dineshannayya/riscduino_board/KiCad_PCB/Riscduino_Fpga_Rev1.1/Riscduino_Fpga_Rev1.1.Back.jpg

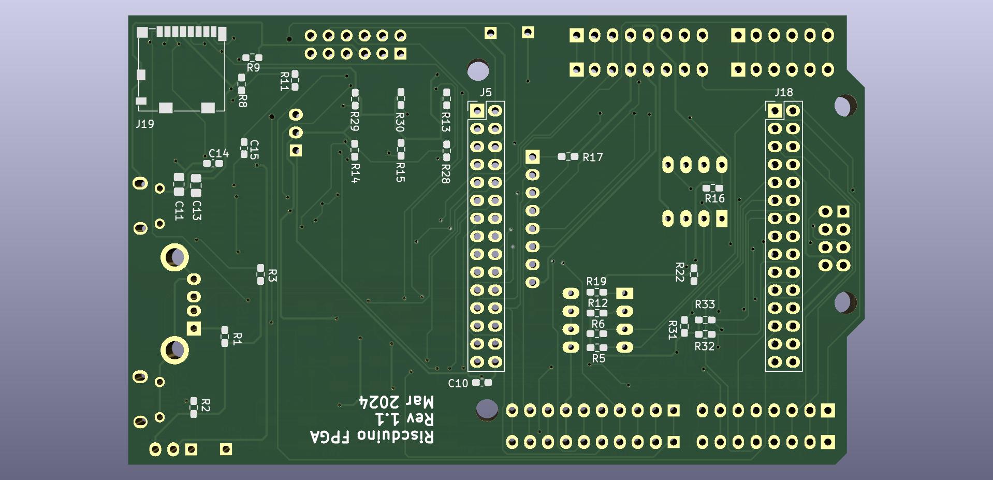
KiCad_PCB/Riscduino_Fpga_Rev1.1/Riscduino_Fpga_Rev1.1.Back.jpg
