dineshannayya/riscduino_board/KiCad_PCB/Riscduino_Fpga_Rev1.1/Riscduino_Fpga_Rev1.1.Front.jpg

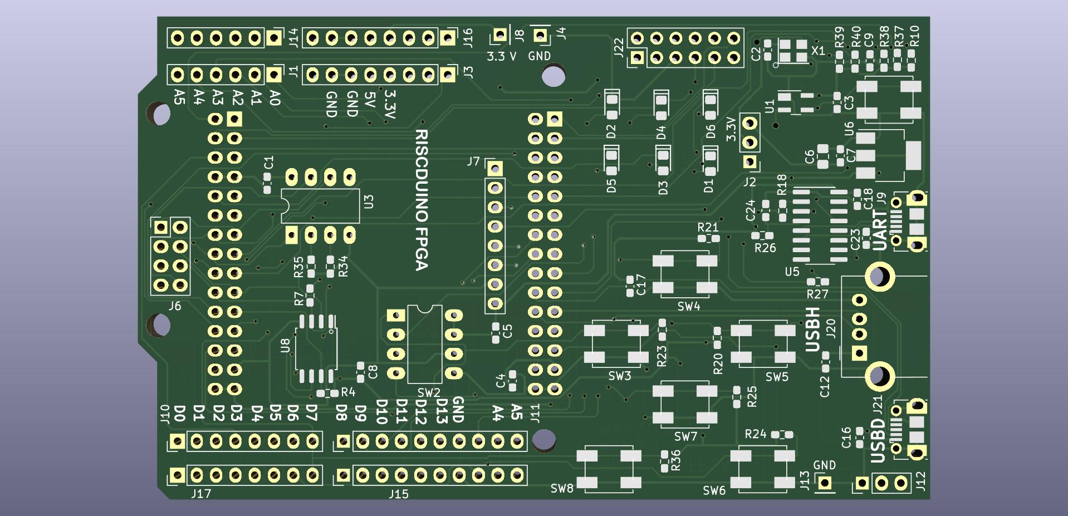
KiCad_PCB/Riscduino_Fpga_Rev1.1/Riscduino_Fpga_Rev1.1.Front.jpg
