dineshannayya/riscduino_board/README.md

# riscduino_board
Riscduino PCB Board documentation
