dineshannayya/riscduino_board/KiCad_PCB/Riscduino_Fpga_Rev1.1/Riscduino_Fpga_Rev1.1_BOM.xlsx

Id | Designator | Footprint | Quantity | Designation
1 | J3,J10,J7 | PinHeader_1x08_P2.54mm_Vertical | 3 | Conn_01x08_Female_Header
2 | J1 | PinHeader_1x06_P2.54mm_Vertical | 1 | Conn_01x06_Female_Header
3 | J11 | PinHeader_1x10_P2.54mm_Vertical | 1 | Conn_01x10_Female_Header
4 | J6 | PinHeader_2x04_P2.54mm_Vertical | 1 | Conn_02x04_Male_Header
5 | J14 | PinHeader_1x06_P2.54mm_Vertical | 1 | Conn_01x06_Male_Header
6 | J16,J17 | PinHeader_1x08_P2.54mm_Vertical | 2 | Conn_01x08_Male_Header
7 | J15 | PinHeader_1x10_P2.54mm_Vertical | 1 | Conn_01x10_Male_Header
8 | J12,J2 | PinHeader_1x03_P2.54mm_Vertical | 2 | Conn_01x03_Male_Header
9 | J22 | PinHeader_2x06_P2.54mm_Vertical | 1 | Conn_02x06_Male_Header
10 | J5,J18 | PinHeader_2x15_P2.54mm_Vertical | 2 | Conn_02x15_Male_Header (Double Hight, Both side exposure)
11 | J9,J21 | USB_Micro-B_Molex-105017-0001 | 2 | USB_B_Micro_Female
12 | J20 | USB_A_Molex_67643_Horizontal | 1 | USB Type A Female
13 | C1,C2,C3,C4,C5,C7,C8,C9,C10,C12,C14,C15,C16,C17,C18,C23,C24 | C_0603_1608Metric_Pad1.08x0.95mm_HandSolder | 17 | 0.1uF
14 | C6 | C_0805_2012Metric_Pad1.18x1.45mm_HandSolder | 1 | 22uF
15 | C13,C11 | C_0805_2012Metric_Pad1.18x1.45mm_HandSolder | 2 | 10uF
16 | R38,R25,R23,R39,R21,R37,R20,R24,R4,R10,R36,R7,R40,R5,R8,R19,R22,R31,R6,R32,R33,R16,R12 | R_0603_1608Metric_Pad0.98x0.95mm_HandSolder | 23 | 10K
17 | R1,R3,R11,R18,R26,R27 | R_0603_1608Metric_Pad0.98x0.95mm_HandSolder | 6 | 0E
18 | R13,R29,R28,R14,R15,R30 | R_0603_1608Metric_Pad0.98x0.95mm_HandSolder | 6 | 470 Ohm
19 | R17 | R_0603_1608Metric_Pad0.98x0.95mm_HandSolder | 1 | 100E
20 | U6 | SOT-223-3_TabPin2 | 1 | LM1117MP-3.3
21 | U8 | SOIC-8_5.23x5.23mm_P1.27mm | 1 | W25Q32JVSS
22 | U5 | SOIC-16_3.9x9.9mm_P1.27mm | 1 | CH340C
23 | D2,D4 | LED_0805_2012Metric_Pad1.15x1.40mm_HandSolder | 2 | GREEN LED
24 | D3,D1,D5,D6 | LED_0805_2012Metric_Pad1.15x1.40mm_HandSolder | 4 | BLUE LED
25 | SW3,SW5,SW8,SW6,SW4,SW1,SW7 | SW_SPST_EVPBF_TS4550TP | 7 | 4Pin Round Button SPST Straight Tactile Switch SMD - TS4550TP
26 | SW2 | DIP-8_W7.62mm_LongPads | 1 | 8 bit DIP Socket (SW_DIP_x04)
27 | U3 | DIP-8_W7.62mm_LongPads | 1 | 8 pin DIP socket (23LC1024-I/P)
28 | U1 | SOT-143_Handsoldering | 1 | APX811-29UG-7
29 | X1 | Crystal_SMD_Abracon_ABM8G-4Pin_3.2x2.5mm | 1 | ASE-18.432MHZ-LC-T
DNI - Donot Mount
1 | R34,R35 | R_0603_1608Metric_Pad0.98x0.95mm_HandSolder | 2 | DNI
2 | R9 | R_0603_1608Metric_Pad0.98x0.95mm_HandSolder | 1 | DNI
3 | R2 | R_0603_1608Metric_Pad0.98x0.95mm_HandSolder | 1 | DNI-0E
4 | J19 | microSD_HC_Molex_104031-0811 | 1 | Micro_SD_Card
24 | H1 | Arduino_UNO_R3_WithMountingHoles | 1 | MountingHole
1 | J4,J13,J8 | PinHeader_1x01_P2.54mm_Vertical | 3 | Conn_01x01
