dineshannayya/riscduino_board/KiCad_PCB/Riscduino_Uno_Rev1.3/Riscduino_Uno_Rev1.3_bom.xlsx

Id | Designator | Footprint | Quantity | Designation
1 | J4,J12,J7,J5 | PinHeader_1x01_P2.54mm_Vertical (Male Berg Connector) | 4 | Conn_01x01
2 | JP2,JP1 | PinHeader_1x02_P2.54mm_Vertical (Male Berg Connector) | 2 | Jumper_2
3 | J11 | PinHeader_1x03_P2.54mm_Vertical (Male Berg Connector) | 1 | Conn_01x03_Pin
4 | J2 | PinHeader_2x03_P2.54mm_Vertical (Male Berg Connector) | 1 | ISP
5 | J6 | PinHeader_2x04_P2.54mm_Vertical(Male Berg Connector) | 1 | Conn_02x04_Odd_Even
6 | J10 | PinHeader_1x10_P2.54mm_Vertical(Female Berg Connector) | 1 | Conn_01x10_Pin
7 | J3,J9 | PinHeader_1x08_P2.54mm_Vertical(Female Berg Connector) | 2 | Conn_01x08_Pin
8 | J1 | PinHeader_1x06_P2.54mm_Vertical(Female Berg Connector) | 1 | Conn_01x06_Pin
9 | J8 | USB_Micro-B_Molex-105017-0001 | 1 | USB_B_Micro
10 | C2,C12,C27,C28,C18,C21,C22,C23,C26 | C_0603_1608Metric_Pad1.08x0.95mm_HandSolder | 9 | 0.1uF (100nf)
11 | C6,C14,C3,C7,C9,C10,C11,C5,C8,C4,C1,C24,C25 | C_0603_1608Metric_Pad1.08x0.95mm_HandSolder | 13 | 0.1uF (100nf)
12 | C13,C19 | C_0805_2012Metric_Pad1.18x1.45mm_HandSolder | 2 | 22uF
13 | C16,C17,C15,C20 | C_0805_2012Metric_Pad1.18x1.45mm_HandSolder | 4 | 10uF
14 | R9,R6,R7,R5,R12,R20,R25,R26 | R_0603_1608Metric_Pad0.98x0.95mm_HandSolder | 8 | 0E
15 | R18,R27,R28,R17,R16,R29,R15 | R_0603_1608Metric_Pad0.98x0.95mm_HandSolder | 7 | 470 Ohm
16 | R3,R2,R1,R4,R10,R13,R21,R32,R24,R22,R23,R30,R31,R19 | R_0603_1608Metric_Pad0.98x0.95mm_HandSolder | 14 | 10K
17 | D2,D3,D1,D4,D5 | LED_0805_2012Metric_Pad1.15x1.40mm_HandSolder | 5 | GREEN LED
18 | D6 | LED_0805_2012Metric_Pad1.15x1.40mm_HandSolder | 1 | BLUE LED
19 | U1 | SOT-143_Handsoldering | 1 | APX811-29UG-7
20 | U5 | SOT-223-3_TabPin2 | 1 | LM1117MP-3.3
21 | U8,U2 | SOIC-8_5.23x5.23mm_P1.27mm | 2 | W25Q32JVSS
22 | U7 | SOT-223-3_TabPin2 | 1 | LM1117S-ADJ
23 | U6 | SOIC-16_3.9x9.9mm_P1.27mm | 1 | CH340C
24 | U3 | DIP-8_W7.62mm_LongPads | 1 | 23LC1024-I/P
25 | U4 | RISCDUINO_QFN-64-1EP_9x9mm_P0.5mm_EP7.65x7.65mm_Ver1.1 | 1 | Riscduino
26 | SW1 | SW_SPST_EVPBF_TS4550TP | 1 | 4Pin Round Button SPST Straight Tactile Switch SMD - TS4550TP
27 | X1 | Crystal_SMD_Abracon_ABM8G-4Pin_3.2x2.5mm | 1 | ASE-10.000MHZ-LC-T
28 | RV1 | Potentiometer_Bourns_3296W_Vertical | 1 | 500 Ohm Trim Pot
Don't mount below componets
1 | H1 | Arduino_UNO_R3_WithMountingHoles | 1 | MountingHole
2 | R8 | R_0603_1608Metric_Pad0.98x0.95mm_HandSolder | 1 | DNI
3 | R11 | C_0603_1608Metric_Pad1.08x0.95mm_HandSolder | 1 | 0E-DNI
4 | R14 | R_0603_1608Metric_Pad0.98x0.95mm_HandSolder | 1 | DNI
