dineshannayya/riscduino_board/KiCad_PCB/Riscduino_Tester_Rev1.0/Riscduino_Tester_BOM_1_0.xlsx

Id | Designator | Footprint | Quantity | Designation
1 | JP2,JP1 | PinHeader_1x02_P2.54mm_Vertical | 2 | Jumper_2(Male berg Connector)
2 | J6 | PinHeader_2x04_P2.54mm_Vertical | 1 | Conn_02x04_Odd_Even(Male berg Connector)
3 | J11 | PinHeader_1x03_P2.54mm_Vertical | 1 | Conn_01x03_Pin(Male berg Connector)
4 | J2 | PinHeader_2x03_P2.54mm_Vertical | 1 | ISP(Male berg Connector)
5 | J1 | PinHeader_1x06_P2.54mm_Vertical | 1 | Conn_01x06_Pin(Female berg Connector)
6 | J10 | PinHeader_1x10_P2.54mm_Vertical | 1 | Conn_01x10_Pin(Female berg Connector)
7 | J13,J14 | PinHeader_2x16_P2.54mm_Vertical_Swap | 2 | Conn_02x16_Odd_Even (Female berg Connector)
8 | J3,J9 | PinHeader_1x08_P2.54mm_Vertical | 2 | Conn_01x08_Pin(Female berg Connector)
9 | C3,C8,C16,C9,C11,C2,C6,C15,C12,C7,C1,C10 | C_0603_1608Metric_Pad1.08x0.95mm_HandSolder | 12 | 0.1uf
10 | C5,C13,C26,C27,C17,C18,C23,C24 | C_0603_1608Metric_Pad1.08x0.95mm_HandSolder | 8 | 0.1uF
11 | C4,C19,C20,C22 | C_0805_2012Metric_Pad1.18x1.45mm_HandSolder | 4 | 10uF
12 | C14,C21 | C_0805_2012Metric_Pad1.18x1.45mm_HandSolder | 2 | 22uF
13 | C25 | C_0603_1608Metric_Pad1.08x0.95mm_HandSolder | 1 | 0.1uF
14 | R7,R1,R10,R12,R8,R17,R22,R28 | R_0603_1608Metric_Pad0.98x0.95mm_HandSolder | 8 | 0E
15 | R2,R6,R4,R5,R3,R11,R23,R29,R24,R25,R26,R30,R31,R16 | R_0603_1608Metric_Pad0.98x0.95mm_HandSolder | 14 | 10K
16 | R18,R15,R19,R27,R20,R21,R13 | R_0603_1608Metric_Pad0.98x0.95mm_HandSolder | 7 | 470 Ohm
17 | U3 | SOT-223-3_TabPin2 | 1 | LM1117MP-3.3
18 | U6,U1 | SOIC-8_5.23x5.23mm_P1.27mm | 2 | W25Q32JVSS
19 | U4 | SOT-223-3_TabPin2 | 1 | LM1117S-ADJ
20 | U5 | SOIC-16_3.9x9.9mm_P1.27mm | 1 | CH340C
21 | U2 | DIP-8_W7.62mm_LongPads | 1 | 23LC1024-I/P
22 | D2,D5,D6,D3,D4 | LED_0805_2012Metric_Pad1.15x1.40mm_HandSolder | 5 | GREEN LED
23 | D1 | LED_0805_2012Metric_Pad1.15x1.40mm_HandSolder | 1 | BLUE LED
24 | J8 | USB_Micro-B_Molex-105017-0001 | 1 | USB_B_Micro
25 | SW1 | SW_SPST_EVPBF_TS4550TP | 1 | 4Pin Round Button SPST Straight Tactile Switch SMD - TS4550TP
26 | X1 | Crystal_SMD_Abracon_ABM8G-4Pin_3.2x2.5mm | 1 | ASE-10.000MHZ-LC-T
27 | RV1 | Potentiometer_Bourns_3296W_Vertical | 1 | 500 Ohm Trim Pot
1 | J4,J12,J7,J5 | PinHeader_1x01_P2.54mm_Vertical | 4 | DNI (Don't Mount)
2 | R9 | R_0603_1608Metric_Pad0.98x0.95mm_HandSolder | 1 | DNI(Don't Mount)
3 | H1 | Riscduino_Tester_WithMountingHoles | 1 | DNI(Don't Mount)
4 | R14 | R_0603_1608Metric_Pad0.98x0.95mm_HandSolder | 1 | DNI(Don't Mount)
