dineshannayya/riscduino_board/KiCad_PCB/Riscduino_Debug_Rev1.4/Riscduino_Debug_Rev1.4.xlsx

 | Id | Designator | Footprint | Quantity | Designation | Total Pins | Total Q | Total 5 Board
Female Berg Connector | 1 | J3,J10,J7 | PinHeader_1x08_P2.54mm_Vertical | 3 | Female Berg Conn_01x08 | 8 | 24
 | 2 | J1 | PinHeader_1x06_P2.54mm_Vertical | 1 | Femal Berg Conn_01x06 | 6 | 6
 | 3 | J11 | PinHeader_1x10_P2.54mm_Vertical | 1 | Female Berg Conn_01x10 | 10 | 10
 |  |  |  |  |  | 24 | 40 | 200
Male Berg Connector | 4 | JP2,JP1 | PinHeader_1x02_P2.54mm_Vertical | 2 | Male Berg Conn_01x02 | 2 | 4
 | 5 | J6 | PinHeader_2x04_P2.54mm_Vertical | 1 | Male Berg Conn_02x04 | 8 | 8
 | 6 | J12 | PinHeader_1x03_P2.54mm_Vertical | 1 | Male Berg Conn_01x03 | 3 | 3
 | 7 | J2 | PinHeader_2x03_P2.54mm_Vertical | 1 | Male Berg Conn_02x04 | 8 | 8
 |  |  |  |  |  | 21 | 23 | 115
IC's | 8 | U6 | SOT-223-3_TabPin2 | 1 | LM1117MP-3.3 | 1 | 1 | 5
 | 9 | U8,U2 | SOIC-8_5.23x5.23mm_P1.27mm | 2 | W25Q32JVSS | 2 | 2 | 10
 | 10 | U7 | SOT-223-3_TabPin2 | 1 | LM1117S-ADJ | 1 | 1 | 5
 | 11 | X1 | Crystal_SMD_Abracon_ABM8G-4Pin_3.2x2.5mm | 1 | ASE-10.000MHZ-LC-T | 1 | 1 | 5
 | 12 | U5 | SOIC-16_3.9x9.9mm_P1.27mm | 1 | CH340C | 1 | 1 | 5
 | 13 | U3 | DIP-8_W7.62mm_LongPads | 1 | 23LC1024-I/P (8 pin socket)
 | 14 | U1 | SOT-143_Handsoldering | 1 | APX811-29UG-7 | 1 | 1 | 5
 | 15 | J9 | USB_Micro-B_Molex-105017-0001 | 1 | USB_B_Micro | 1 | 1 | 5
Capacitor | 16 | C2,C8,C3,C5,C7,C4,C1,C21,C20,C15,C24,C16,C22,C12,C14,C19,C18,C23 | C_0603_1608Metric_Pad1.08x0.95mm | 18 | 0.1uF | 18 | 18 | 90
 | 17 | C6,C17 | C_0805_2012Metric_Pad1.18x1.45mm | 2 | 22uF | 2 | 2 | 10
 | 18 | C10,C13,C9,C11 | C_0805_2012Metric_Pad1.18x1.45mm | 4 | 10uF | 4 | 4 | 20
LED | 19 | D2,D3,D1,D4,D5 | LED_0805_2012Metric_Pad1.15x1.40mm | 5 | GREEN LED | 5 | 5 | 25
 | 20 | D6 | LED_0805_2012Metric_Pad1.15x1.40mm | 1 | BLUE LED | 1 | 1 | 5
Resister | 21 | R5,R11,R18,R19,R20,R21,R26,R27 | R_0603_1608Metric_Pad0.98x0.95mm | 8 | 0E | 8 | 8 | 40
 | 22 | R13,R29,R28,R14,R15,R30,R12 | R_0603_1608Metric_Pad0.98x0.95mm | 7 | 470E | 7 | 7 | 35
 | 23 | R17 | R_0603_1608Metric_Pad0.98x0.95mm | 1 | 100E | 1 | 1 | 5
 | 24 | R1,R2,R3,R4,R7,R8,R22,R31,R23,R24,R25,R32,R33,R16 | R_0603_1608Metric_Pad0.98x0.95mm | 14 | 10K | 14 | 14 | 70
 | 25 | H2 | MicroMod-Standoff | 1 | MICROMOD-Standoff | 1 | 1 | 5
 | 26 | U4 | M.2-CONNECTOR-E | 1 | MICROMOD-Connector | 1 | 1 | 5
 | 27 | SW1 | SW_SPST_EVPBF_TS4550TP | 1 | 4Pin Round Button SPST Straight Tactile Switch SMD - TS4550TP | 1 | 1 | 5
 | 28 | RV1 | Potentiometer_Bourns_3296W_Vertical | 1 | 500 Ohm Trim Pot | 1 | 1 | 5
 | Following Componets are need not be mounted
 | 30 | R6,R34,R35 | R_0603_1608Metric_Pad0.98x0.95mm | 3 | DNI
 | 31 | R10 | C_0603_1608Metric_Pad1.08x0.95mm | 1 | 0E-DNI
 | 32 | R9 | R_0603_1608Metric_Pad0.98x0.95mm | 1 | DNI
 | 33 | J4,J13,J8,J5 | PinHeader_1x01_P2.54mm_Vertical | 4 | DNI
 | 34 | H1 | Arduino_UNO_R3_WithMountingHoles | 1 | MountingHole | 1 | 1 | 5
