dineshannayya/riscduino_board/KiCad_PCB/Riscduino_Componets_Tracking.xlsx

 | Riscduino Components Tracking
Id | Footprint | Designation | Quantity | Vendor |  | Code/Sku | Link
1 | PinHeader_1x01_P2.54mm_Vertical(Male) | Conn_01x01 | 40x 10 | evelta | ₹4.03 | 083-BS-M-1X40-254-S | berg-strip-i-type-male (https://evelta.com/berg-strip-i-type-male-1x40-2-54-mm-0-1-inch-pitch/)
2 | PinHeader_1x02_P2.54mm_Vertical(Male) | Jumper_2
3 | PinHeader_1x01_P2.54mm_Vertical(Male) | TestPoint
7 | PinHeader_2x04_P2.54mm_Vertical(Male) | Conn_02x04_Odd_Even
8 | PinHeader_2x03_P2.54mm_Vertical(Male) | ISP
4 | PinHeader_1x08_P2.54mm_Vertical (Female) | Conn_01x08_Pin | 40 x 10 | electronicscomp | Rs.19.00 | EC-6391/85366990 | 2x40 1.27mm Pitch Pin Female Double Row Header Berg Strip (https://www.electronicscomp.com/2x40-1.27mm-pitch-pin-female-double-row-header-berg-strip?search=EC-6391)
5 | PinHeader_1x06_P2.54mm_Vertical (Female) | Conn_01x06_Pin (Female)
6 | PinHeader_1x10_P2.54mm_Vertical (Female) | Conn_01x10_Pin
9 | USB_Micro-B_Molex-105017-0001 | USB_B_Micro | 13 | evelta | ₹7.78 | 345-U254-051T-4BH83-S1S | female-micro-b-usb-connector (https://evelta.com/female-micro-b-usb-connector-smd/)
10 | R_0603_1608Metric_Pad0.98x0.95mm_HandSolder | 0E | 200
11 | R_0603_1608Metric_Pad0.98x0.95mm_HandSolder | 10K | 200 | evelta | ₹0.32 | 039-RC0603FR-0710KL | 10k-1-100mw-0603 (https://evelta.com/10k-1-100mw-0603-chip-resistor/)
12 | R_0603_1608Metric_Pad0.98x0.95mm_HandSolder | 470 Ohm | 200 | robu.in | ₹45.00 | 573876 | 470-ohm-1-4w-0603 (https://robu.in/product/470-ohm-1-4w-0603-surface-mount-chip-resistor-pack-of-100/)
13 | C_0603_1608Metric_Pad1.08x0.95mm_HandSolder | 0.1uF | 200 | evelta | ₹0.76 | 153-W25Q32JVSSIQ | 100-nf-50v-0603 (https://evelta.com/100-nf-50v-0603-smd-multi-layer-ceramic-capacitor-0603b104k500ct-walsin/)
14 | C_0805_2012Metric_Pad1.18x1.45mm_HandSolder | 22uF | 100 | evelta | ₹4.00 | 110-CL21A226MQQNNNE | 22-uf-6-3v-0805
15 | C_0805_2012Metric_Pad1.18x1.45mm_HandSolder | 10uF | 100 | evelta | ₹7.14 | 110-CL21A106KBYQNNE | 10uf-50v (https://evelta.com/10uf-50v-10-x5r-0805-chip-capacitor/)
16 | LED_0805_2012Metric_Pad1.15x1.40mm_HandSolder | RED LED | 100 | evelta | ₹1.84 | 083-RD-LED-0805 | red-led (https://evelta.com/red-led-smd-0805-package/)
17 | LED_0805_2012Metric_Pad1.15x1.40mm_HandSolder | GREEN LED | 100 | evelta | ₹4.03 | 083-GN-LED-0805 | green-led (https://evelta.com/green-led-smd-0805-package/)
18 | LED_0805_2012Metric_Pad1.15x1.40mm_HandSolder | BLUE LED | 100 | evelta | ₹1.69 | 083-BE-LED-0805 | blue-led (https://evelta.com/blue-led-smd-0805-package/)
19 | SOIC-8_5.23x5.23mm_P1.27mm | W25Q32JVSS (SPI FLASH) | 50 | evelta | ₹28.80 | 153-W25Q32JVSSIQ | w25q32jvssiq (https://evelta.com/w25q32jvssiq-winbond/)
20 | SOT-223-3_TabPin2 | LM1117S-ADJ (Adjustable Regulator) | 25 | evelta | ₹13.44 | 052-LM1117S-ADJ | lm1117s-adj-htc-adjustable (https://evelta.com/lm1117s-adj-htc-adjustable-1a-ldo-voltage-regulator/)
reg |  |  | 25 | inkocean.in | ₹21.00 | CJ0109170855 | LM1117IMPX-ADJ N03A (https://inkocean.in/products/screen-lm1117impx-adj-n03a-power-regulator-chip-package-sot223)
21 | SOIC-16_3.9x9.9mm_P1.27mm | CH340C (USB2UART IC) | 10 | electronicscomp | Rs.64.00 | EC-17358/85423100 | ch340c-smd-sop-16-package (https://www.electronicscomp.com/ch340c-smd-sop-16-package-usb-to-serial-ttl-converter-ic?search=EC-17358) | S
22 | SOIC-8-1EP_3.9x4.9mm_P1.27mm_EP2.29x3mm | MAX1232ESA+T ( Power Supervisory) | 25 | inkocean.in | ₹30.00 | CJ0109155354 | monitor-ic-max1232esa-sop8 (https://inkocean.in/products/monitor-ic-max1232esa-sop8-supervisory-circuits-max1232-chip-package)
23 | SOT-223-3_TabPin2 | LM1117MP-3.3 (3.3 V Regulator) | 25 | evelta | ₹11.70 | 052-LM1117GS-3.3 | lm1117s-3-3-htc-3-3v (https://evelta.com/lm1117s-3-3-htc-3-3v-1a-ldo-voltage-regulator/)
 |  |  | 25 | inkocean.in | ₹21.00 | CJ0109170855 | ns-lm1117-3-3-lm1117impx-3-3v (https://inkocean.in/products/ns-lm1117-3-3-lm1117impx-3-3-lm1117mpx-3-3-n05a-n05b)
24 | DIP-8_W7.62mm_LongPads | 23LC1024-I/P (SPI SRAM) | 10 | tanotis.com | ₹355.50 | 9781102352 | MICROCHIP SRAM, 1 MB, 128K x 8bit (https://www.tanotis.com/products/microchip-23lc1024-i-p-sram-1-mb-128k-x-8bit-2-5v-to-5-5v-dip-8-pins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) | S
25 | RISCDUINO_QFN-64-1EP_9x9mm_P0.5mm_EP7.65x7.65mm_NEW | Riscduino | 40
26 | SW_SPST_EVPBF_TS4550TP | 4Pin Round Button SPST Straight Tactile Switch SMD - TS4550TP | 100 | evelta | ₹1.68 | 336-TS4550TP | 4pin-round-button-spst (https://evelta.com/12v-50ma-4-5x4-5x5-0mm-4pin-round-button-spst-straight-tactile-switch-smd/)
27 | Crystal_SMD_Abracon_ABM8G-4Pin_3.2x2.5mm (SMD_3225) | ASE-10.000MHZ-LC-T | 15 | iodparts.in | ₹117.85 |  | ase-10-000mhz-lc-t (https://www.iodparts.in/part/ase-10-000mhz-lc-t) | S
28 | Potentiometer_Bourns_3296W_Vertical | 500 Ohm Trim Pot | 15 | evelta | ₹6.25 | 184-3296W-1-501LF | 500r-0-5w-10-multiturn-trimpot (https://evelta.com/500r-0-5w-10-multiturn-trimpot-trimming-potentiometer-through-hole/) | S
29 | MicroMod DIY Carrier Kit |  | 5 | tanotis.com | ₹665 | 6615389077589/KIT-16549 | MicroMod DIY Carrier Kit (https://www.tanotis.com/products/sparkfun-micromod-diy-carrier-kit-5-pack?variant=39501712425045)
Additional Componets
30 | R_0603_1608Metric_Pad0.98x0.95mm_HandSolder | 220 ohm | 200 | robu.in | ₹ 49.00 | 573740 | 220-ohm-chip-resistor-1-4w-0603 (https://robu.in/product/220-ohm-chip-resistor-1-4w-0603-surface-mount-pack-of-100/)
31 | R_0603_1608Metric_Pad0.98x0.95mm_HandSolder | 330 ohm | 200 | robu.in | ₹ 49.00 | 573821 | 330-ohm-1-4w-0603 (https://robu.in/product/330-ohm-1-4w-0603-surface-mount-chip-resistor-pack-of-100/)
32 | 1uF 16V 10% X5R 0603 MLCC Multilayer Ceramic Capacitor |  | 100 | evelta | ₹0.80 | 110-CL10A105KO8NNNC | 1uf-16v (https://evelta.com/1uf-16v-10-x5r-0603-capacitor/)
33 | 4.7uF 16V 10% X5R 0603 MLCC Multilayer Ceramic Capacitor |  | 100 | evelta | ₹1.60 | 110-CL10A475KO8NNNC | 4-7uf-16v (https://evelta.com/4-7uf-16v-10-x5r-0603-capacitor/)
34 | LM1117S-1.8V - 1.8V 1A Fixed Output LDO Linear Voltage Regulator 3-Pin SOT-223 |  | 50 | evelta | ₹13.44 | 052-LM1117S-1.8V | lm1117s-1-8v (https://evelta.com/lm1117s-1-8v-htc-1-8v-1a-ldo-voltage-regulator/)
35 | 1x20 2.54mm Pitch (Right Angle) Female Header Berg Strip |  | 4 | electronicscomp | Rs.19.00 | EC-6408/85366990 | 1x20-2.54mm-pitch-right-angle-female-header-berg-strip (https://www.electronicscomp.com/1x20-2.54mm-pitch-right-angle-female-header-berg-strip?search=EC-6408)
36 | 1x40 2.54mm Pitch Female Berg Strip Header (Right Angle) |  | 4 | electronicscomp | Rs.23.00 | EC-6405/85366990 | 1x40-2.54mm-pitch-female-berg-strip-header-right-angle (https://www.electronicscomp.com/1x40-2.54mm-pitch-female-berg-strip-header-right-angle?search=EC-6405)
37 | 1x20 2.54mm Pitch (Right Angle) Male Header Berg Strip |  | 6 | electronicscomp | Rs.15.00 | EC-6409/85366990 | 1x20-2.54mm-pitch-right-angle-male-header-berg-strip (https://www.electronicscomp.com/1x20-2.54mm-pitch-right-angle-male-header-berg-strip?search=EC-6409)
38 | 2x40 1.27mm Pitch Pin Female Double Row Header Berg Strip |  | 2 | electronicscomp | Rs.59.00 | EC-6391/85366990 | 2x40-1.27mm-pitch-pin-female-double-row-header-berg-strip (https://www.electronicscomp.com/2x40-1.27mm-pitch-pin-female-double-row-header-berg-strip?search=EC-6391)
39 | 1x40 Pin 2.54mm Pitch Male Berg Strip - Break Away Header - Straight |  | 10 | electronicscomp | Rs.9.00 | EC-0183/85369090 | 1x40 Pin 2.54mm Pitch Male Berg Strip (https://www.electronicscomp.com/40-pin-male-berg-strip?search=EC-0183)
40 | 24LC256-I/P 24C256 |  | 5 | robu.in | ₹ 55.00 | 1089239 | 24LC256-I/P 24C256 256K (https://robu.in/product/24lc256-i-p-24c256-256k-bit-serial-i2c-bus-eeprom-ic-dip-8-package/)
41 | 24LC512-I/SN |  | 20 | iodparts.in | ₹133.97 |  | 24lc512-i-sn (https://www.iodparts.in/part/24lc512-i-sn)
42 | Integrated Silicon Solution (ISSI) IS62WV2568BLL-55HLI Sram 2 Mbit 256K x 8bit 2.5V to 3.6V |  | 4 | tanotis.com | ₹334.65 | 1359619915861 | IS62WV2568BLL-55HLI (https://www.tanotis.com/products/integrated-silicon-solution-issi-is62wv2568bll-55hli-sram-2-mbit-256k-x-8bit-2-5v-to-3-6v-stsop-32-pins-55-ns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)
43 | LM1117IMPX-1.8 SOT223 package |  | 25 | inkocean.in | ₹26.00 | CJ0109162514 | lm1117impx-1-8-sot223 (https://inkocean.in/products/lm1117impx-1-8-sot223-package-n12a-screen-full-range-jieyou)
44 | CP2102 CP2102-GMR QFN28 USB serial converter chip |  | 5 | inkocean.in | ₹139.00 | CJ0109172849 | cp2102-cp2102-gmr-qfn28 (https://inkocean.in/products/cp2102-cp2102-gmr-qfn28-usb-serial-converter-chip)
45 | DS1232LPS DS1232L SOP-8 rmal monitoring chip |  | 100 | inkocean.in | ₹16.00 | CJ0109164039 | ds1232lps-ds1232l (https://inkocean.in/products/ds1232lps-ds1232l-sop-8-rmal-monitoring-chip)
