dineshannayya/riscduino_board/KiCad_PCB/Riscduino_Tester_Rev1.0/Riscduino_Tester_back_View.png

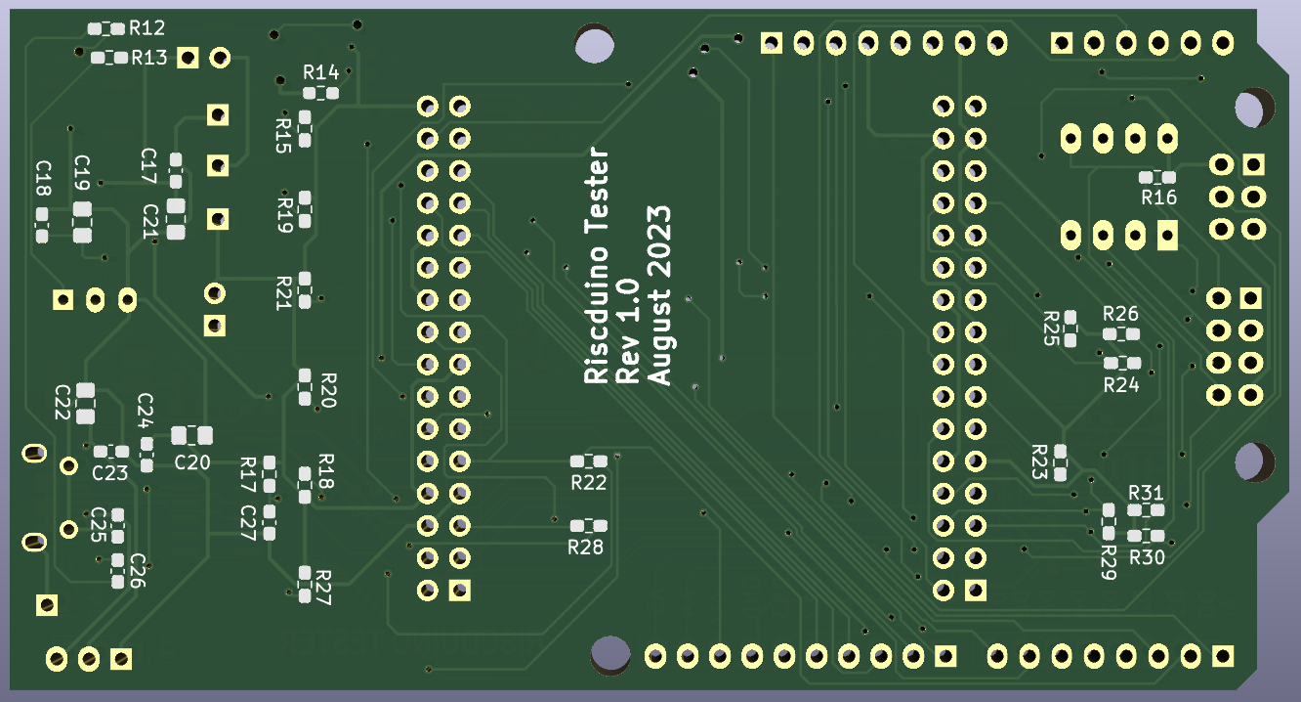
KiCad_PCB/Riscduino_Tester_Rev1.0/Riscduino_Tester_back_View.png
