dineshannayya/riscduino_board/KiCad_PCB/Riscduino_Debug_Rev1.4/BoardStatus.xlsx

 |  | IO | Core |  |  |  |  |  |  | Replace |  |  |  | Resolder | Female Connector
Board | No | (V) | (V) | USB | CLK | LED | Download | Cache | Non-Cache | CLK | USB2UART | Riscduino | LED | Riscduino |  | 100nf | Remark
Riscduino Rev 1.3 | B1 | 3.3 | 1.58 | OK | OK | OK | OK | NOK | OK |  |  |  |  |  |  |  | Good for Non cache mode TCM Test passing, Still software hangs with cache enabled
Riscduino Rev 1.3 | B2 | 3.3 | 1.59 | OK | NOK | OK |  |  |  | YES |  |  |  | YES |  |  | Need Clock Replacement + Chip reSoldering
Riscduino Rev 1.3 | B3 | 3.3 | 1.58 | OK | OK | OK | NOK |  |  |  |  | YES |  |  |  |  | Bootloader programing itself fails, need to replace chip
Riscduino Rev 1.3 | B4 | 3.3 | 1.59 | OK | OK | OK | OK | NOK | OK |  |  |  |  |  |  | YES | Good for Non cache mode
Riscduino Rev 1.3 | B5 | 3.3 | 1.59 | NOK | OK | OK |  |  |  |  | YES |  |  |  | YES |  | Try with USB2UART replacement
Riscduino Rev 1.3 | B6 | 3.3 | 1.59 | OK | OK | OK |  |  |  |  |  |  |  | YES | YES |  | Need Chip resoldering
Riscduino Rev 1.3 | B7 | 3.3 | 1.59 | NOK | OK |  |  |  |  |  | YES |  | YES |  |  |  | Replace USB2UART and Need to Solder LED
Riscduino Rev 1.3 | B8 | 3.3 | 1.59 | OK | OK | OK | OK | OK | OK |  |  |  |  |  | YES |  | Good for Cache Mode
Riscduino Rev 1.3 | B9 | 3.3 | 1.59 | OK | OK | OK |  |  |  |  |  |  |  | YES | YES |  | Need Chip resoldering
Riscduino Rev 1.3 | B10 | 3.3 | 1.59 | OK | OK | OK | OK | NOK | OK |  |  |  |  |  |  |  | Good for Non Cache Mode
VSDSquadron V2 | B1 | 3.3 | 1.57 | OK | OK | OK | OK | NOK | NOK |  |  | YES |  |  |  |  | Software is not executing Fyi: Previosly this board fails with SPI signature check, after replacing it , Downloading is working
VSDSquadron V2 | B2 | 3.3 | 1.58 | OK | OK | OK | OK | NOK | OK |  |  |  |  |  |  |  | Working in non cache Mode
