dineshannayya/riscduino_board/KiCad_PCB/Riscduino_Uno_Rev1.3/Riscduino_Uno_Rev1.3_Schematic.pdf

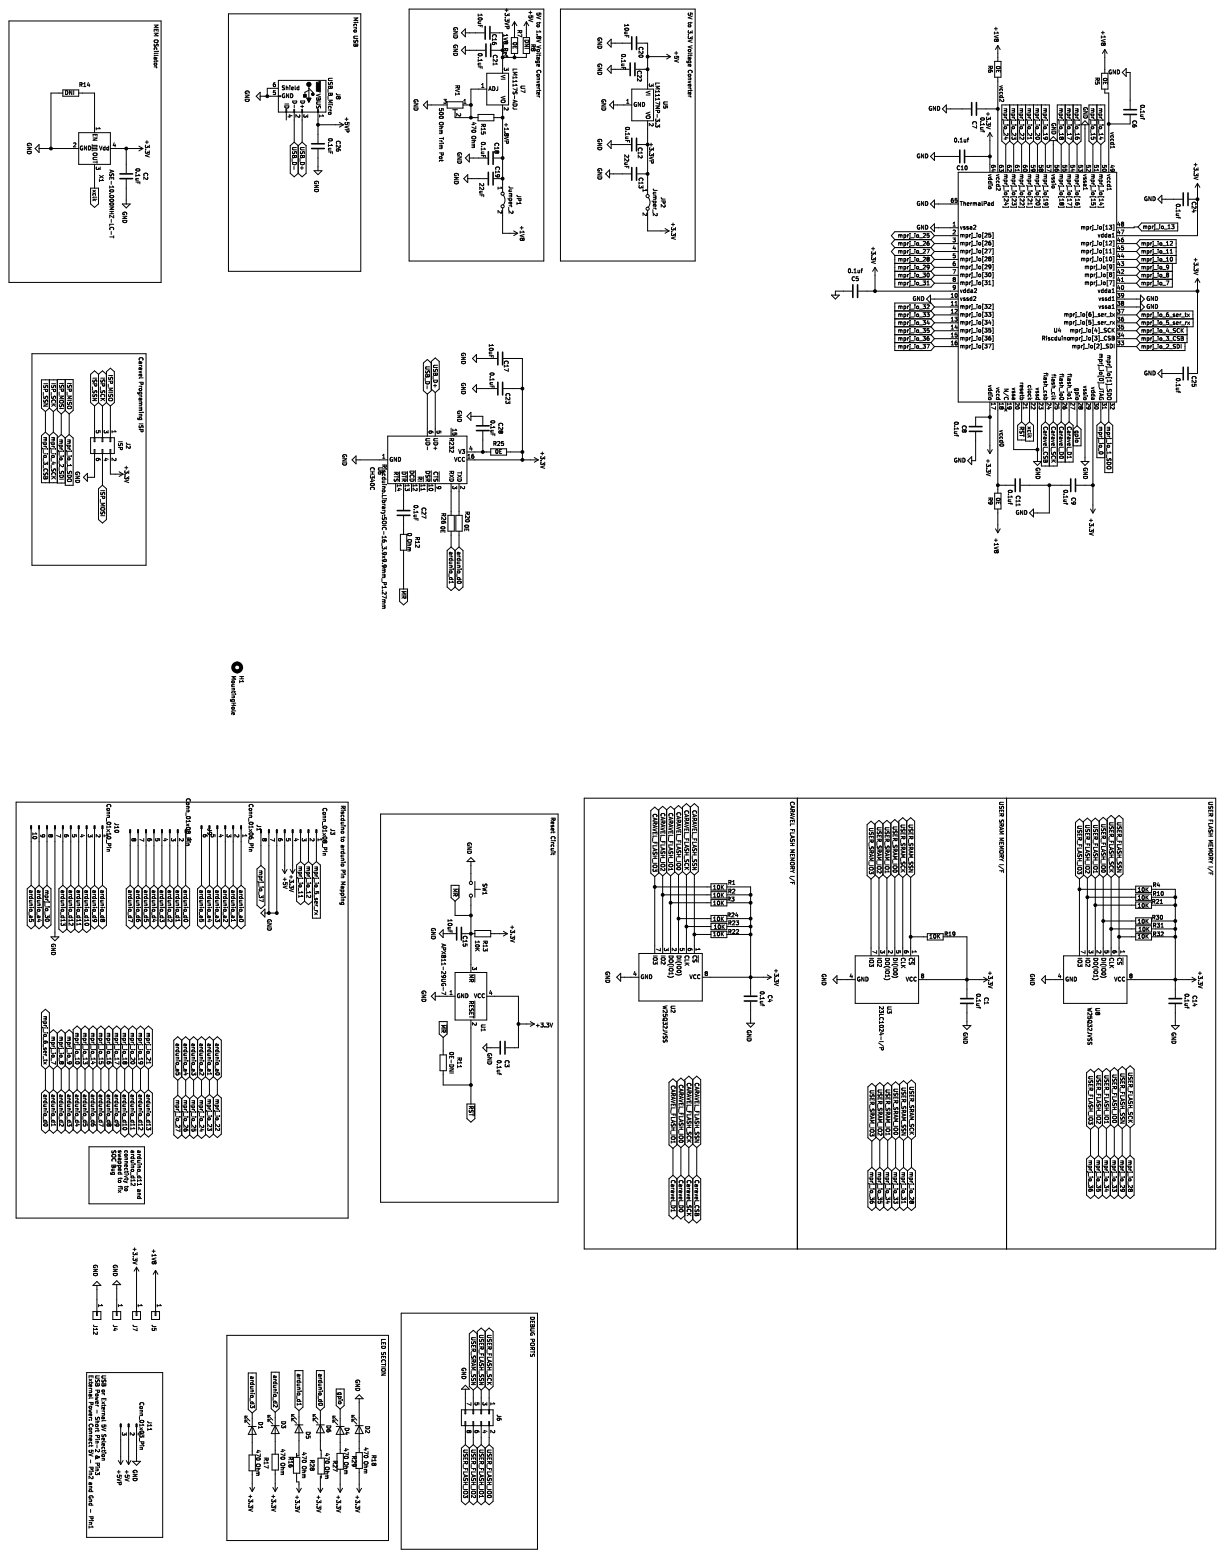
[picture p5: page 1]
