dineshannayya/riscduino_board/KiCad_PCB/Riscduino_Uno_Rev1.1/Riscduino_Uno_Rev1.1_Schematic.pdf

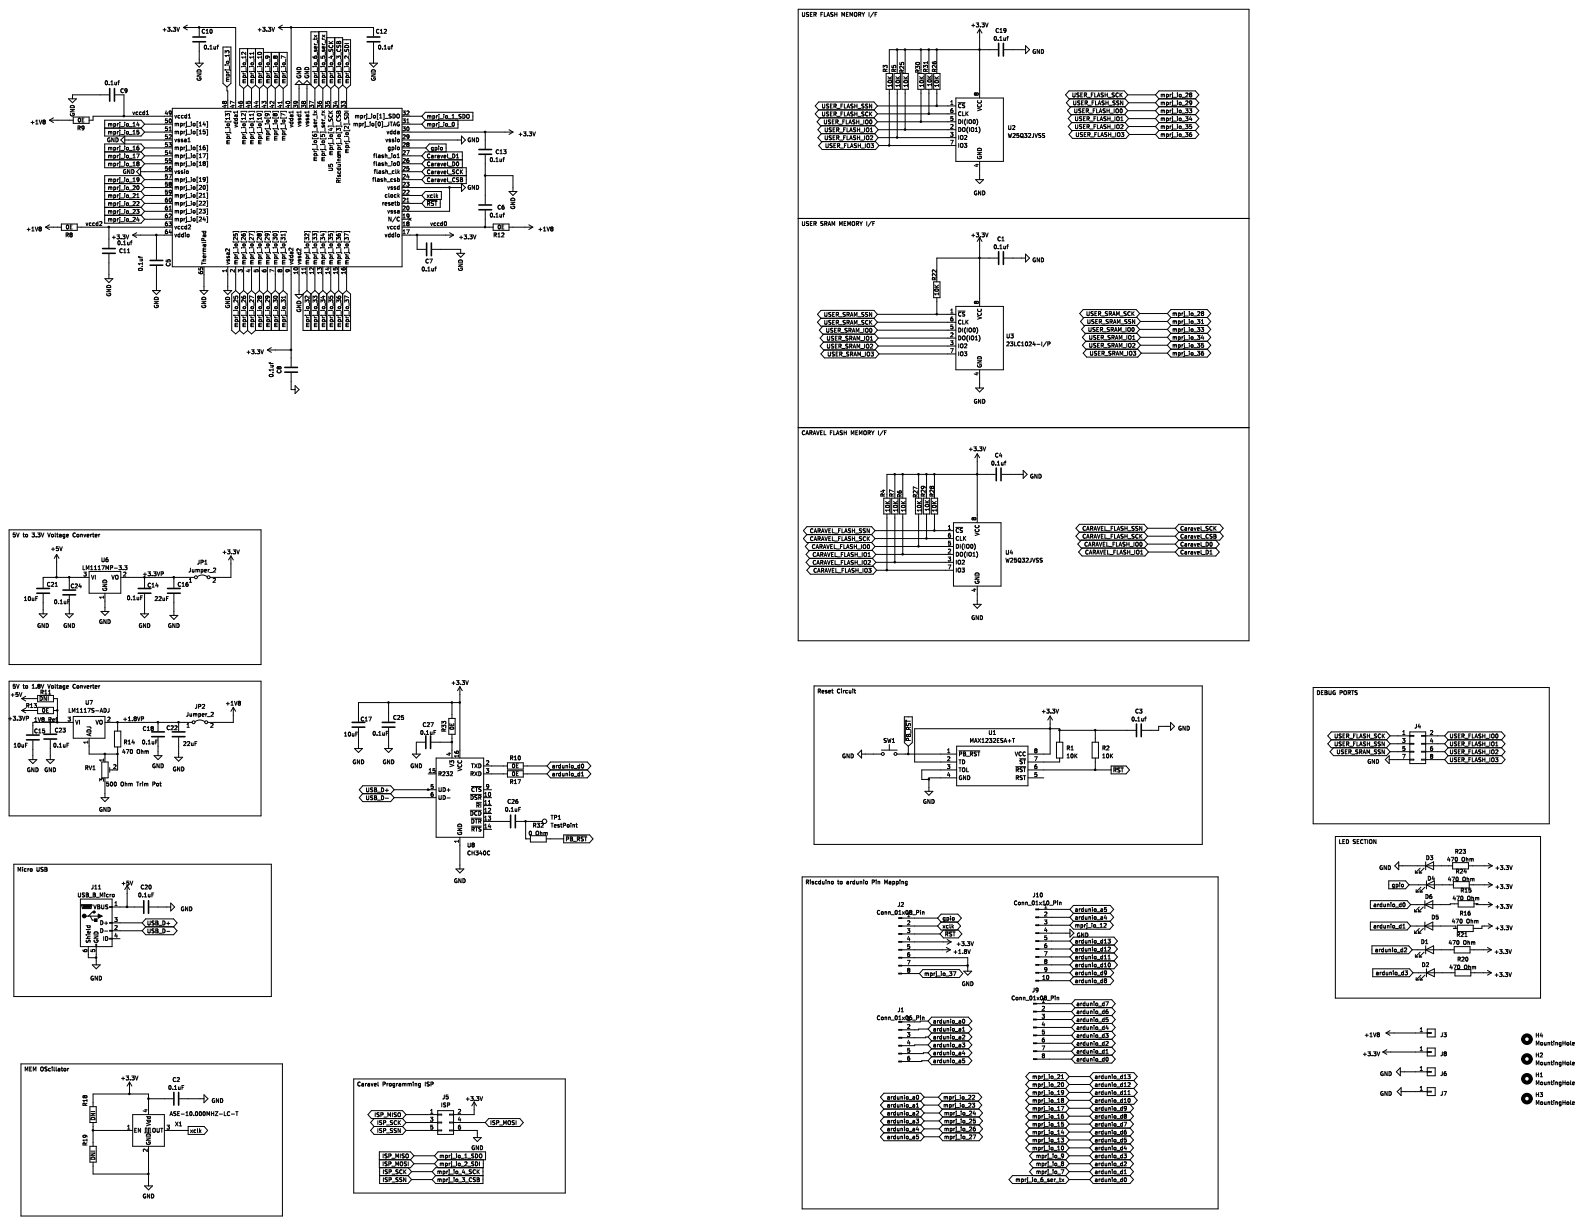
[picture p6: page 1]
