dineshannayya/riscduino_board/KiCad_PCB/Riscduino_Fpga_Rev1.1/Riscduino_Fpga_Rev1.1.kicad_pcb

## KiCad design KiCad_PCB/Riscduino_Fpga_Rev1.1/Riscduino_Fpga_Rev1.1.kicad_pcb (2024-03-15)

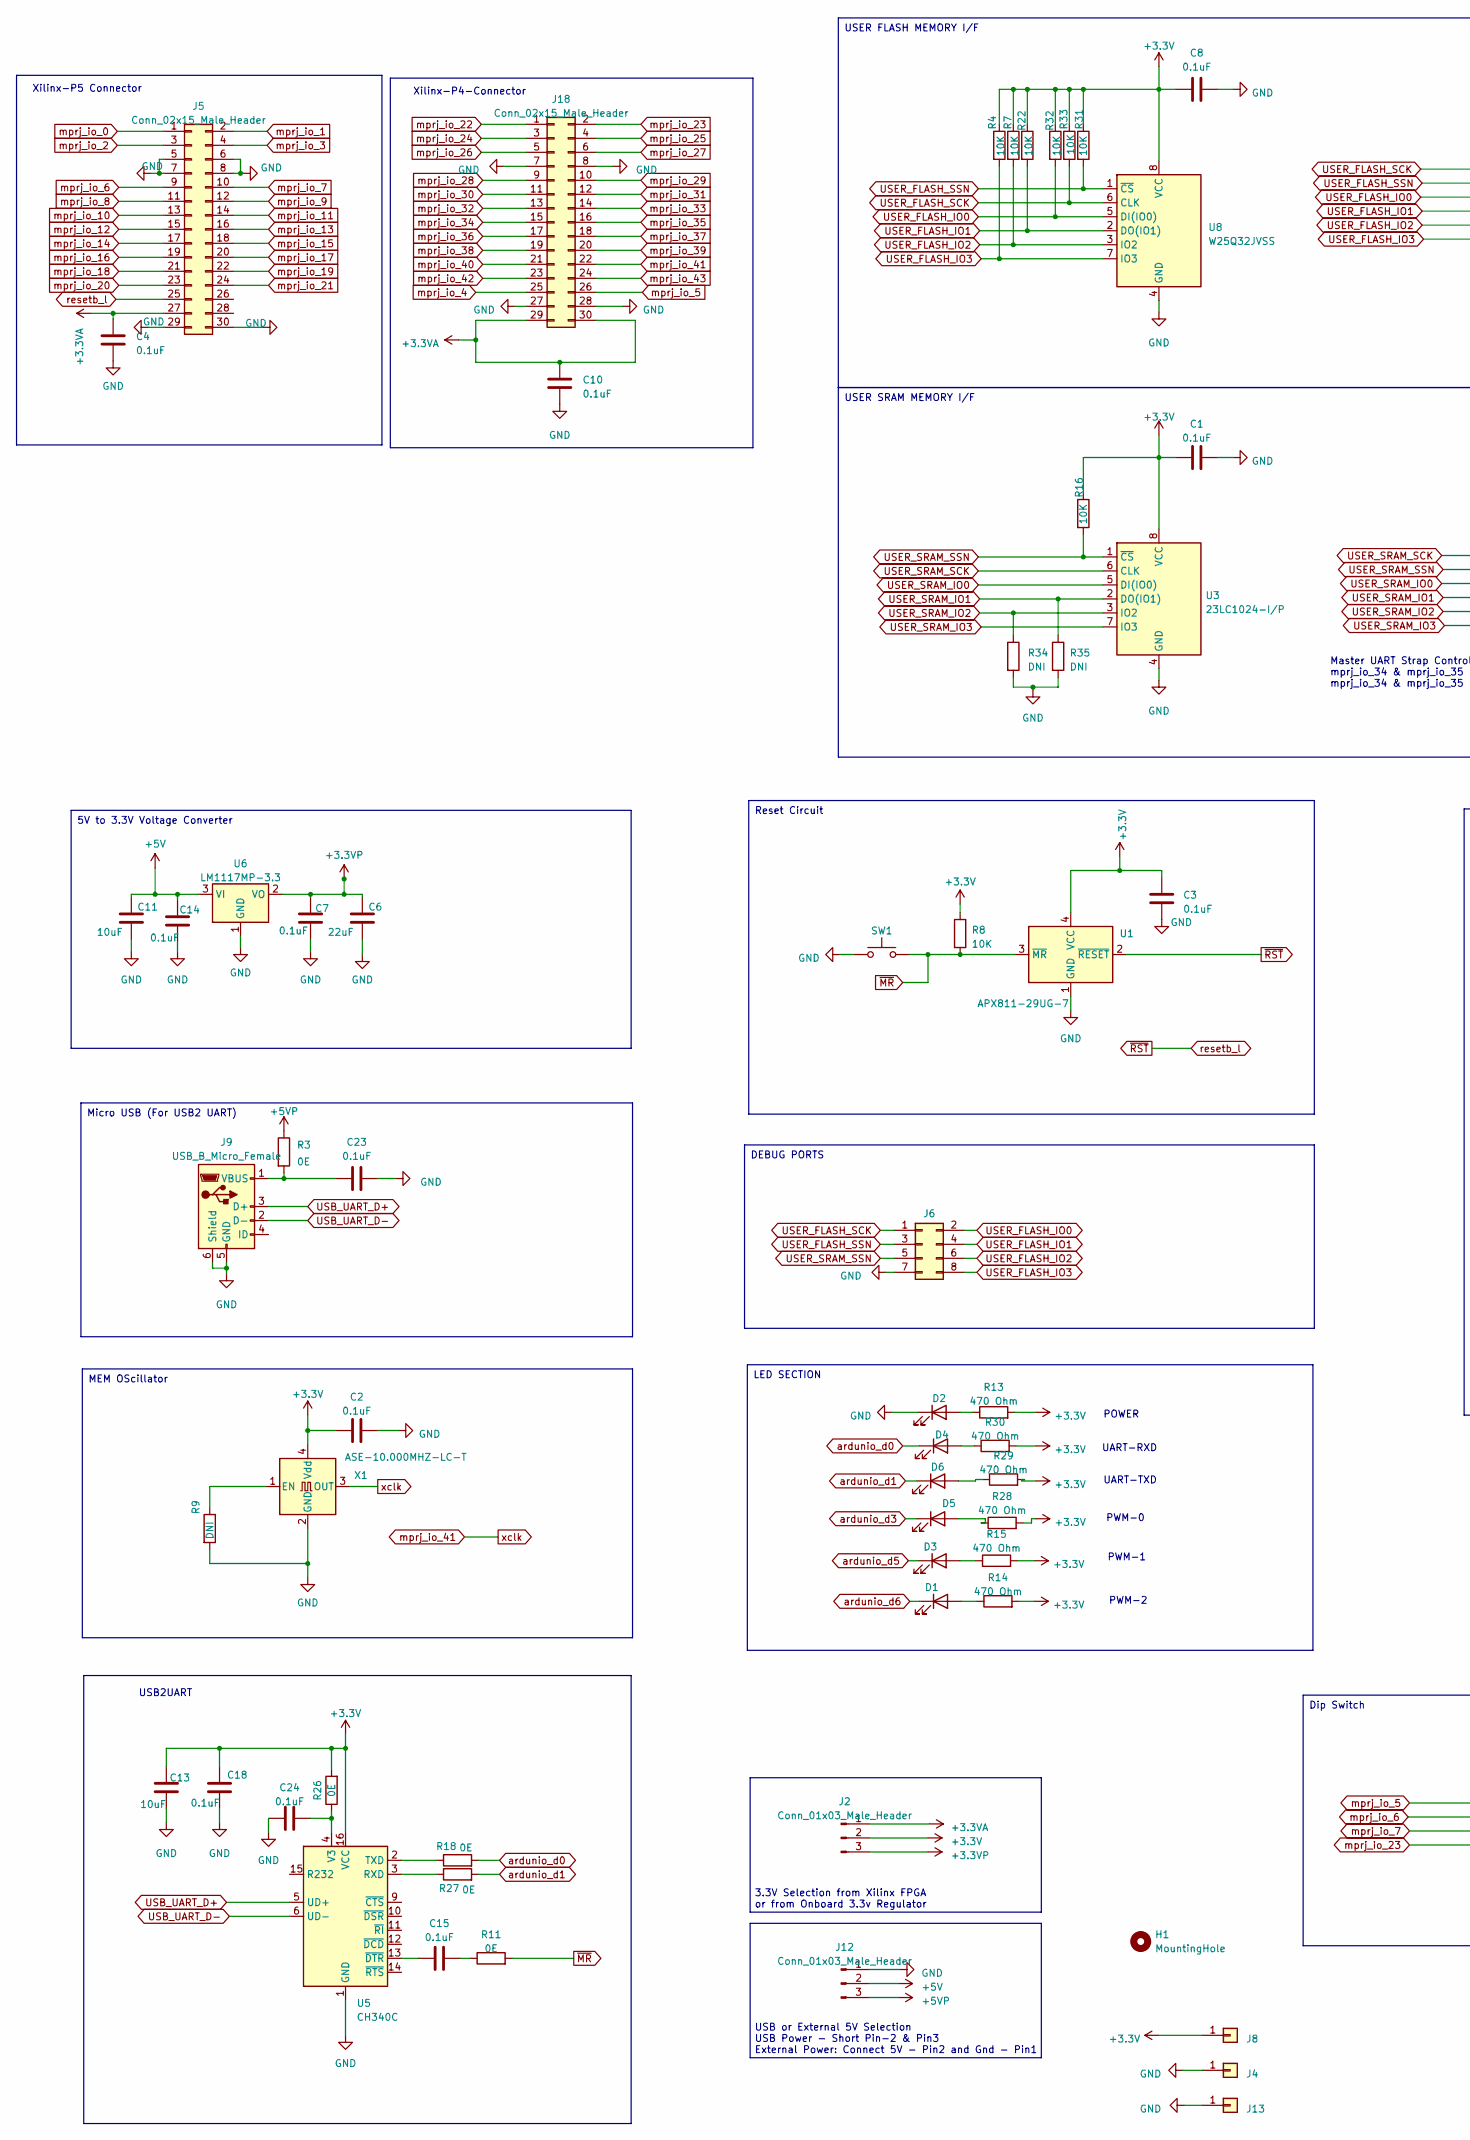
[picture p7: schematic Riscduino_Fpga_Rev1.1.kicad_sch, part in row 1, column 1]

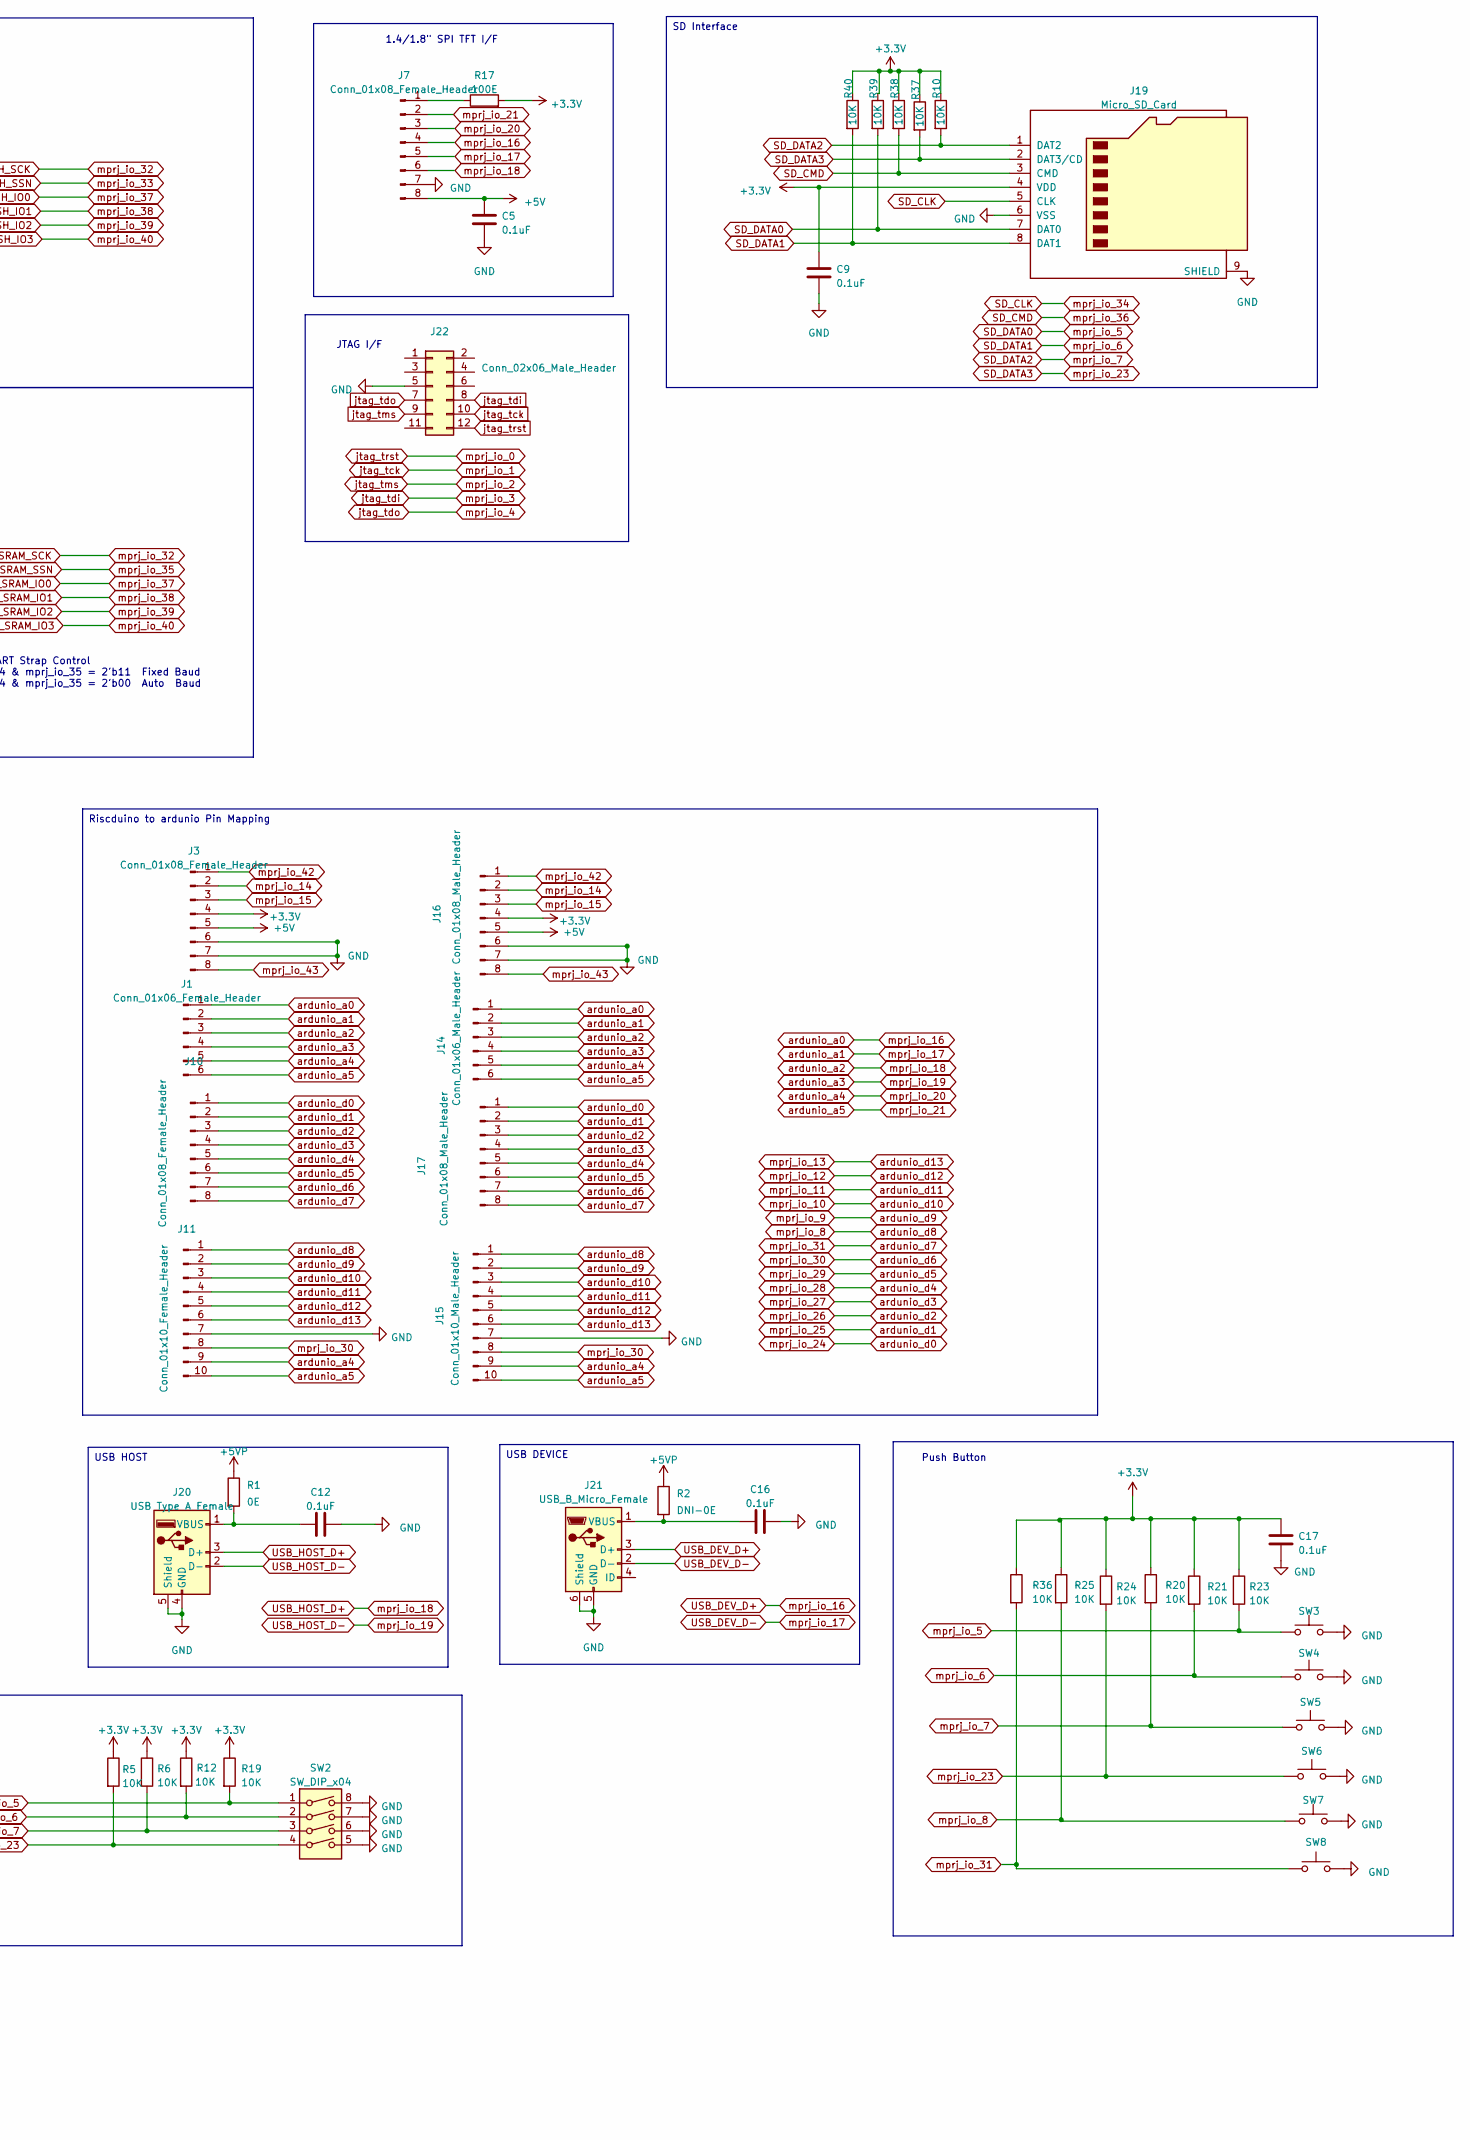
[picture p8: schematic Riscduino_Fpga_Rev1.1.kicad_sch, part in row 1, column 2]

Parts:
C1, C2, C3, C4, C5, C7, C8, C9, C10, C12, C14, C15, C16, C17, C18, C23, C24: 0.1uF; C_0603_1608Metric_Pad1.08x0.95mm_HandSolder
C6: 22uF; C_0805_2012Metric_Pad1.18x1.45mm_HandSolder
C11, C13: 10uF; C_0805_2012Metric_Pad1.18x1.45mm_HandSolder
D1, D3, D5, D6: BLUE LED; LED_0805_2012Metric_Pad1.15x1.40mm_HandSolder
D2, D4: GREEN LED; LED_0805_2012Metric_Pad1.15x1.40mm_HandSolder
H1: MountingHole; Arduino_UNO_R3_WithMountingHoles
J1: Conn_01x06_Female_Header; PinHeader_1x06_P2.54mm_Vertical
J2, J12: Conn_01x03_Male_Header; PinHeader_1x03_P2.54mm_Vertical
J3, J7, J10: Conn_01x08_Female_Header; PinHeader_1x08_P2.54mm_Vertical
J4, J8, J13: Conn_01x01; PinHeader_1x01_P2.54mm_Vertical
J5, J18: Conn_02x15_Male_Header; PinHeader_2x15_P2.54mm_Vertical
J6: Conn_02x04_Male_Header; PinHeader_2x04_P2.54mm_Vertical
J9, J21: USB_B_Micro_Female; USB_Micro-B_Molex-105017-0001
J11: Conn_01x10_Female_Header; PinHeader_1x10_P2.54mm_Vertical
J14: Conn_01x06_Male_Header; PinHeader_1x06_P2.54mm_Vertical
J15: Conn_01x10_Male_Header; PinHeader_1x10_P2.54mm_Vertical
J16, J17: Conn_01x08_Male_Header; PinHeader_1x08_P2.54mm_Vertical
J19: Micro_SD_Card; microSD_HC_Molex_104031-0811
J20: USB Type A Female; USB_A_Molex_67643_Horizontal
J22: Conn_02x06_Male_Header; PinHeader_2x06_P2.54mm_Vertical
R1, R3, R11, R18, R26, R27: 0E; R_0603_1608Metric_Pad0.98x0.95mm_HandSolder
R2: DNI-0E; R_0603_1608Metric_Pad0.98x0.95mm_HandSolder
R4, R5, R6, R7, R8, R10, R12, R16, R19, R20, R21, R22, R23, R24, R25, R31, R32, R33, R36, R37, R38, R39, R40: 10K; R_0603_1608Metric_Pad0.98x0.95mm_HandSolder
R9, R34, R35: DNI; R_0603_1608Metric_Pad0.98x0.95mm_HandSolder
R13, R14, R15, R28, R29, R30: 470 Ohm; R_0603_1608Metric_Pad0.98x0.95mm_HandSolder
R17: 100E; R_0603_1608Metric_Pad0.98x0.95mm_HandSolder
SW1, SW3, SW4, SW5, SW6, SW7, SW8: 4Pin Round Button SPST Straight Tactile Switch SM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; SW_SPST_EVPBF_TS4550TP
SW2: SW_DIP_x04; DIP-8_W7.62mm_LongPads
U1: APX811-29UG-7; SOT-143_Handsoldering
U3: 23LC1024-I/P; DIP-8_W7.62mm_LongPads
U5: CH340C; SOIC-16_3.9x9.9mm_P1.27mm
U6: LM1117MP-3.3; SOT-223-3_TabPin2
U8: W25Q32JVSS; SOIC-8_5.23x5.23mm_P1.27mm
X1: ASE-10.000MHZ-LC-T; Crystal_SMD_Abracon_ABM8G-4Pin_3.2x2.5mm

Connections:
+3.3V: C1.1, C2.1, C3.1, C8.1, C9.1, C13.1, C17.1, C18.1, J2.2, J3.4, J8.1, J16.4, J19.4 (VDD), R4.1, R5.1, R6.1, R7.1, R8.1, R10.1, R12.1, R13.2, R14.2, R15.2, R16.1, R17.2, R19.1, R20.1, R21.1, R22.1, R23.1, R24.1, R25.1, R26.2, R28.2, R29.2, R30.2, R31.1, R32.1, R33.1, R36.1, R37.1, R38.1, R39.1, R40.1, U1.4 (VCC), U3.8 (VCC), U5.16 (VCC), U8.8 (VCC), X1.4 (Vdd)
+3.3VA: C4.1, C10.1, J2.1, J5.27, J18.29, J18.30
+3.3VP: C6.1, C7.1, J2.3, U6.2 (VO)
+5V: C5.1, C11.1, C14.1, J3.5, J7.8, J12.2, J16.5, U6.3 (VI)
+5VP: J12.3, R1.1, R2.1, R3.1
GND: C1.2, C2.2, C3.2, C4.2, C5.2, C6.2, C7.2, C8.2, C9.2, C10.2, C11.2, C12.2, C13.2, C14.2, C16.2, C17.2, C18.2, C23.2, C24.1, D2.1 (K), J3.6, J3.7, J4.1, J5.5, J5.6, J5.7, J5.8, J5.29, J5.30, J6.7, J7.7, J9.5 (GND), J9.6 (Shield), J11.7, J12.1, J13.1, J15.7, J16.6, J16.7, J18.7, J18.8, J18.27, J18.28, J19.6 (VSS), J19.9 (SHIELD), J20.4 (GND), J20.5 (Shield), J21.5 (GND), J21.6 (Shield), J22.5, R9.2, R34.2, R35.2, SW1.1, SW2.5, SW2.6, SW2.7, SW2.8, SW3.2, SW4.2, SW5.2, SW6.2, SW7.2, SW8.2, U1.1 (GND), U3.4 (GND), U5.1 (GND), U6.1 (GND), U8.4 (GND), X1.2 (GND)
unnamed: C15.2, R11.1
unnamed 7: D1.2 (A), R14.1; also elsewhere on the board
unnamed: D2.2 (A), R13.1
unnamed: D3.2 (A), R15.1
unnamed: D4.2 (A), R30.1
unnamed: D5.2 (A), R28.1
unnamed: D6.2 (A), R29.1
unnamed: J7.1, R17.1
unnamed: C23.1, J9.1 (VBUS), R3.2
unnamed: C12.1, J20.1 (VBUS), R1.2
unnamed: C16.1, J21.1 (VBUS), R2.2
unnamed: R27.1, U5.3 (RXD)
unnamed: R18.1, U5.2 (TXD)
unnamed: C24.2, R26.1, U5.4 (V3)
unnamed: C15.1, U5.13 (~DTR)
unnamed: R9.1, X1.1 (EN)
SD_CLK: J18.15, J19.5 (CLK)
SD_CMD: J18.17, J19.3 (CMD), R38.2
SD_DATA0: J18.26, J19.7 (DAT0), R19.2, R23.2, R39.2, SW2.1, SW3.1
SD_DATA1: J5.9, J19.8 (DAT1), R12.2, R21.2, R40.2, SW2.2, SW4.1
SD_DATA2: J5.10, J19.1 (DAT2), R6.2, R10.2, R20.2, SW2.3, SW5.1
SD_DATA3: J18.2, J19.2 (DAT3/CD), R5.2, R24.2, R37.2, SW2.4, SW6.1
USB_DEV_D+: J1.1, J5.19, J7.4, J14.1, J21.3 (D+)
USB_DEV_D-: J1.2, J5.20, J7.5, J14.2, J21.2 (D-)
USB_HOST_D+: J1.3, J5.21, J7.6, J14.3, J20.3 (D+)
USB_HOST_D-: J1.4, J5.22, J14.4, J20.2 (D-)
USB_UART_D+: J9.3 (D+), U5.5 (UD+)
USB_UART_D-: J9.2 (D-), U5.6 (UD-)
USER_FLASH_IO0: J6.2, J18.18, R32.2, U3.5 (DI(IO0)), U8.5 (DI(IO0))
USER_FLASH_IO1: J6.4, J18.19, R22.2, R35.1, U3.2 (DO(IO1)), U8.2 (DO(IO1))
USER_FLASH_IO2: J6.6, J18.20, R7.2, R34.1, U3.3 (IO2), U8.3 (IO2)
USER_FLASH_IO3: J6.8, J18.21, R4.2, U3.7 (IO3), U8.7 (IO3)
USER_FLASH_SCK: J6.1, J18.13, R33.2, U3.6 (CLK), U8.6 (CLK)
USER_FLASH_SSN: J6.3, J18.14, R31.2, U8.1 (~CS)
USER_SRAM_SSN: J6.5, J18.16, R16.2, U3.1 (~CS)
ardunio_a4: J1.5, J5.23, J7.3, J11.9, J14.5, J15.9
ardunio_a5: J1.6, J5.24, J7.2, J11.10, J14.6, J15.10
ardunio_d0: D4.1 (K), J10.1, J17.1, J18.3, R18.2
ardunio_d1: D6.1 (K), J10.2, J17.2, J18.4, R27.2
ardunio_d2: J10.3, J17.3, J18.5
ardunio_d3: D5.1 (K), J10.4, J17.4, J18.6
ardunio_d4: J10.5, J17.5, J18.9
ardunio_d5: D3.1 (K), J10.6, J17.6, J18.10
ardunio_d6: D1.1 (K), J10.7, J11.8, J15.8, J17.7, J18.11; also elsewhere on the board
ardunio_d7: J10.8, J17.8, J18.12, R36.2, SW8.1
ardunio_d8: J5.11, J11.1, J15.1, R25.2, SW7.1
ardunio_d9: J5.12, J11.2, J15.2
ardunio_d10: J5.13, J11.3, J15.3
ardunio_d11: J5.14, J11.4, J15.4
ardunio_d12: J5.15, J11.5, J15.5
ardunio_d13: J5.16, J11.6, J15.6
jtag_tck: J5.2, J22.10
jtag_tdi: J5.4, J22.8
jtag_tdo: J18.25, J22.7
jtag_tms: J5.3, J22.9
jtag_trst: J5.1, J22.12
mprj_io_14: J3.2, J5.17, J16.2
mprj_io_15: J3.3, J5.18, J16.3
mprj_io_22: J18.1
mprj_io_41: J18.22, X1.3 (OUT)
mprj_io_42: J3.1, J16.1, J18.23
mprj_io_43: J3.8, J16.8, J18.24
resetb_l: J5.25, U1.2 (~RESET)
~MR: R8.2, R11.2, SW1.2, U1.3 (~MR)

Notes on the sheet:
MEM OScillator
5V to 3.3V Voltage Converter
Dip Switch
LED SECTION
Riscduino to ardunio Pin Mapping
Micro USB (For USB2 UART)
USER SRAM MEMORY I/F
DEBUG PORTS
USB HOST
USB DEVICE
USER FLASH MEMORY I/F
SD Interface
Reset Circuit
Xilinx-P5 Connector
POWER
Xilinx-P4-Connector
Push Button
UART-TXD
3.3V Selection from Xilinx FPGA or from Onboard 3.3v Regulator
JTAG I/F
USB or External 5V Selection USB Power - Short Pin-2 & Pin3 External Power: Connect 5V - Pin2 and Gnd - Pin1
PWM-0
UART-RXD
1.4/1.8" SPI TFT I/F
Master UART Strap Control mprj_io_34 & mprj_io_35 = 2'b11 Fixed Baud mprj_io_34 & mprj_io_35 = 2'b00 Auto Baud
PWM-1
USB2UART
PWM-2

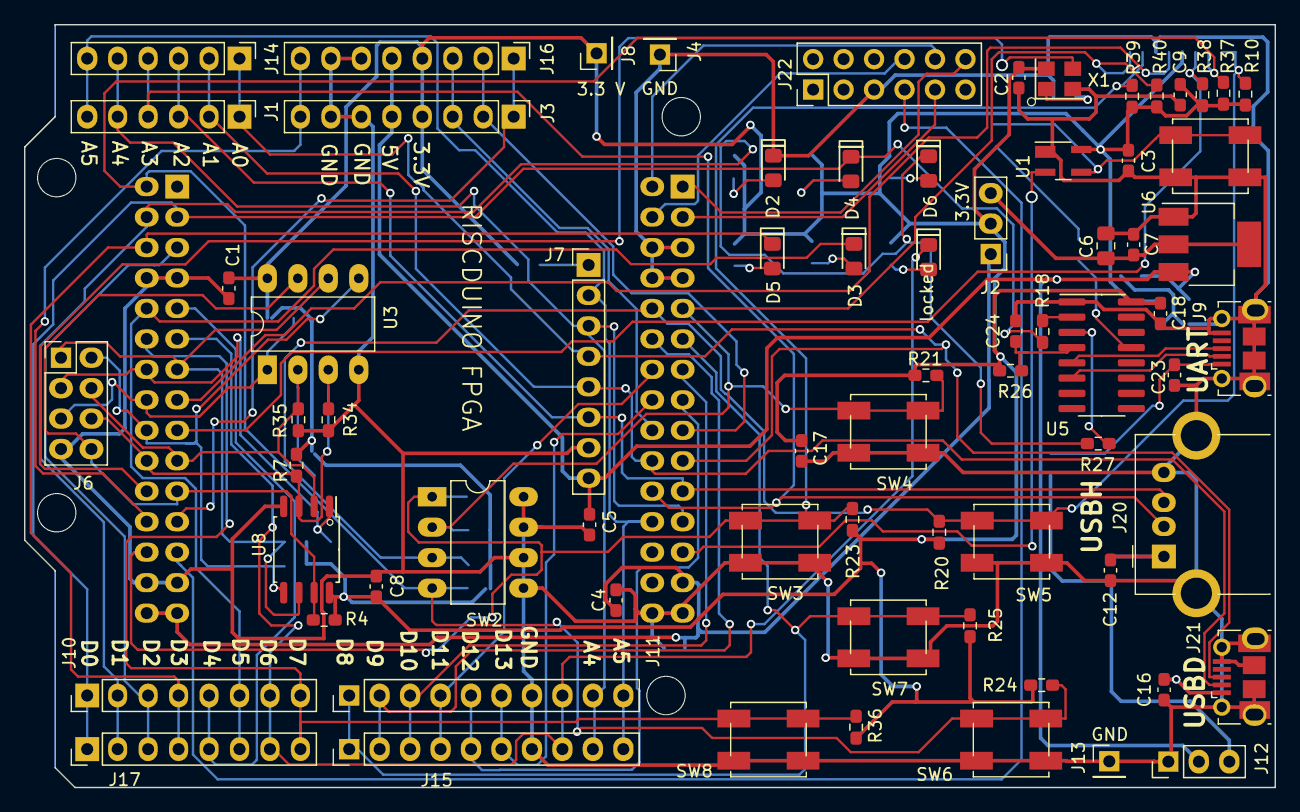
[picture p9: board Riscduino_Fpga_Rev1.1.kicad_pcb from above]

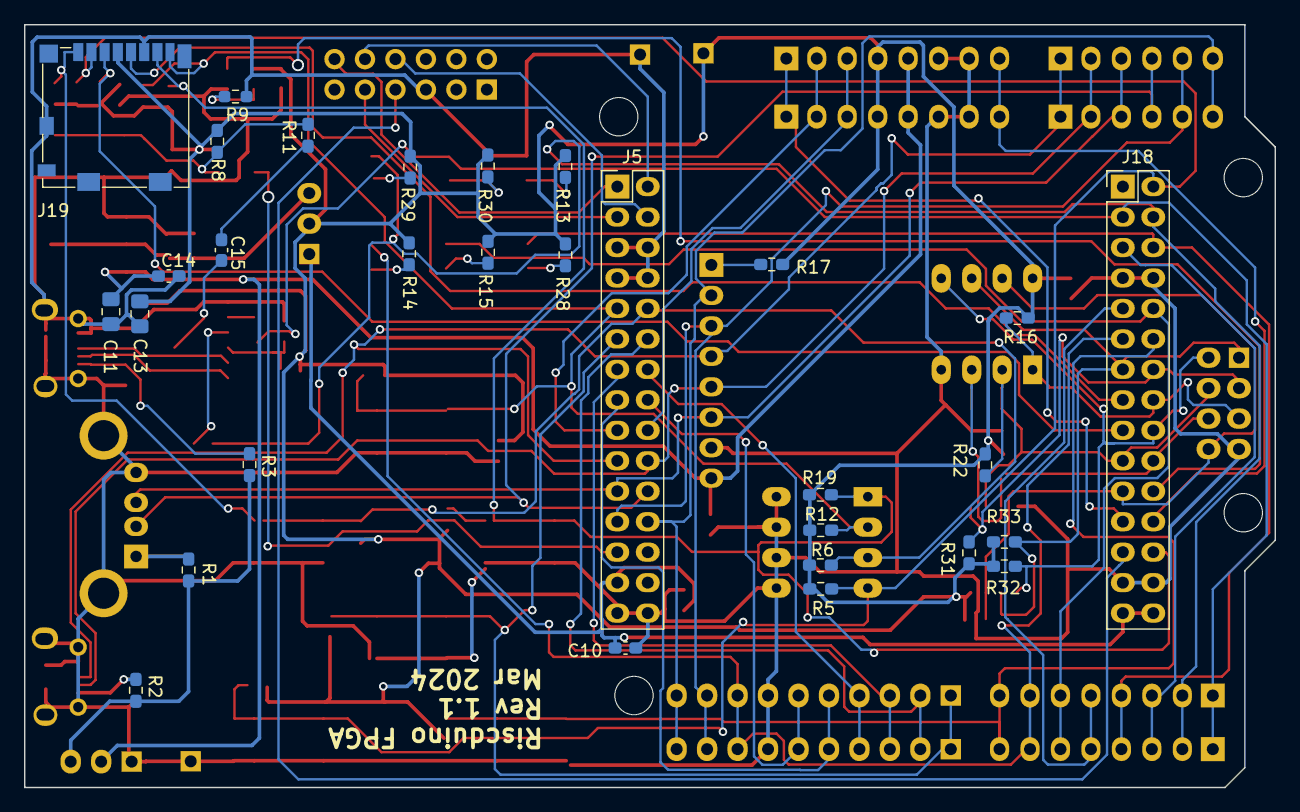
[picture p10: board Riscduino_Fpga_Rev1.1.kicad_pcb from below]

Board: 2 copper layers, 104.3 x 63.6 mm, 103 parts (30 on the bottom side), 69 nets.

Other parts of the board:
locked: BLUE LED; LED_0805_2012Metric_Pad1.15x1.40mm_HandSolder

Their connections:
unnamed 7: locked.2 (A); also elsewhere on the board
ardunio_d6: locked.1 (K); also elsewhere on the board
