dineshannayya/riscduino_board/KiCad_PCB/Riscduino_Debug_Rev1.4/Riscduino_Debug_Rev1.4.kicad_pcb

## KiCad design KiCad_PCB/Riscduino_Debug_Rev1.4/Riscduino_Debug_Rev1.4.kicad_pcb (2024-02-04)

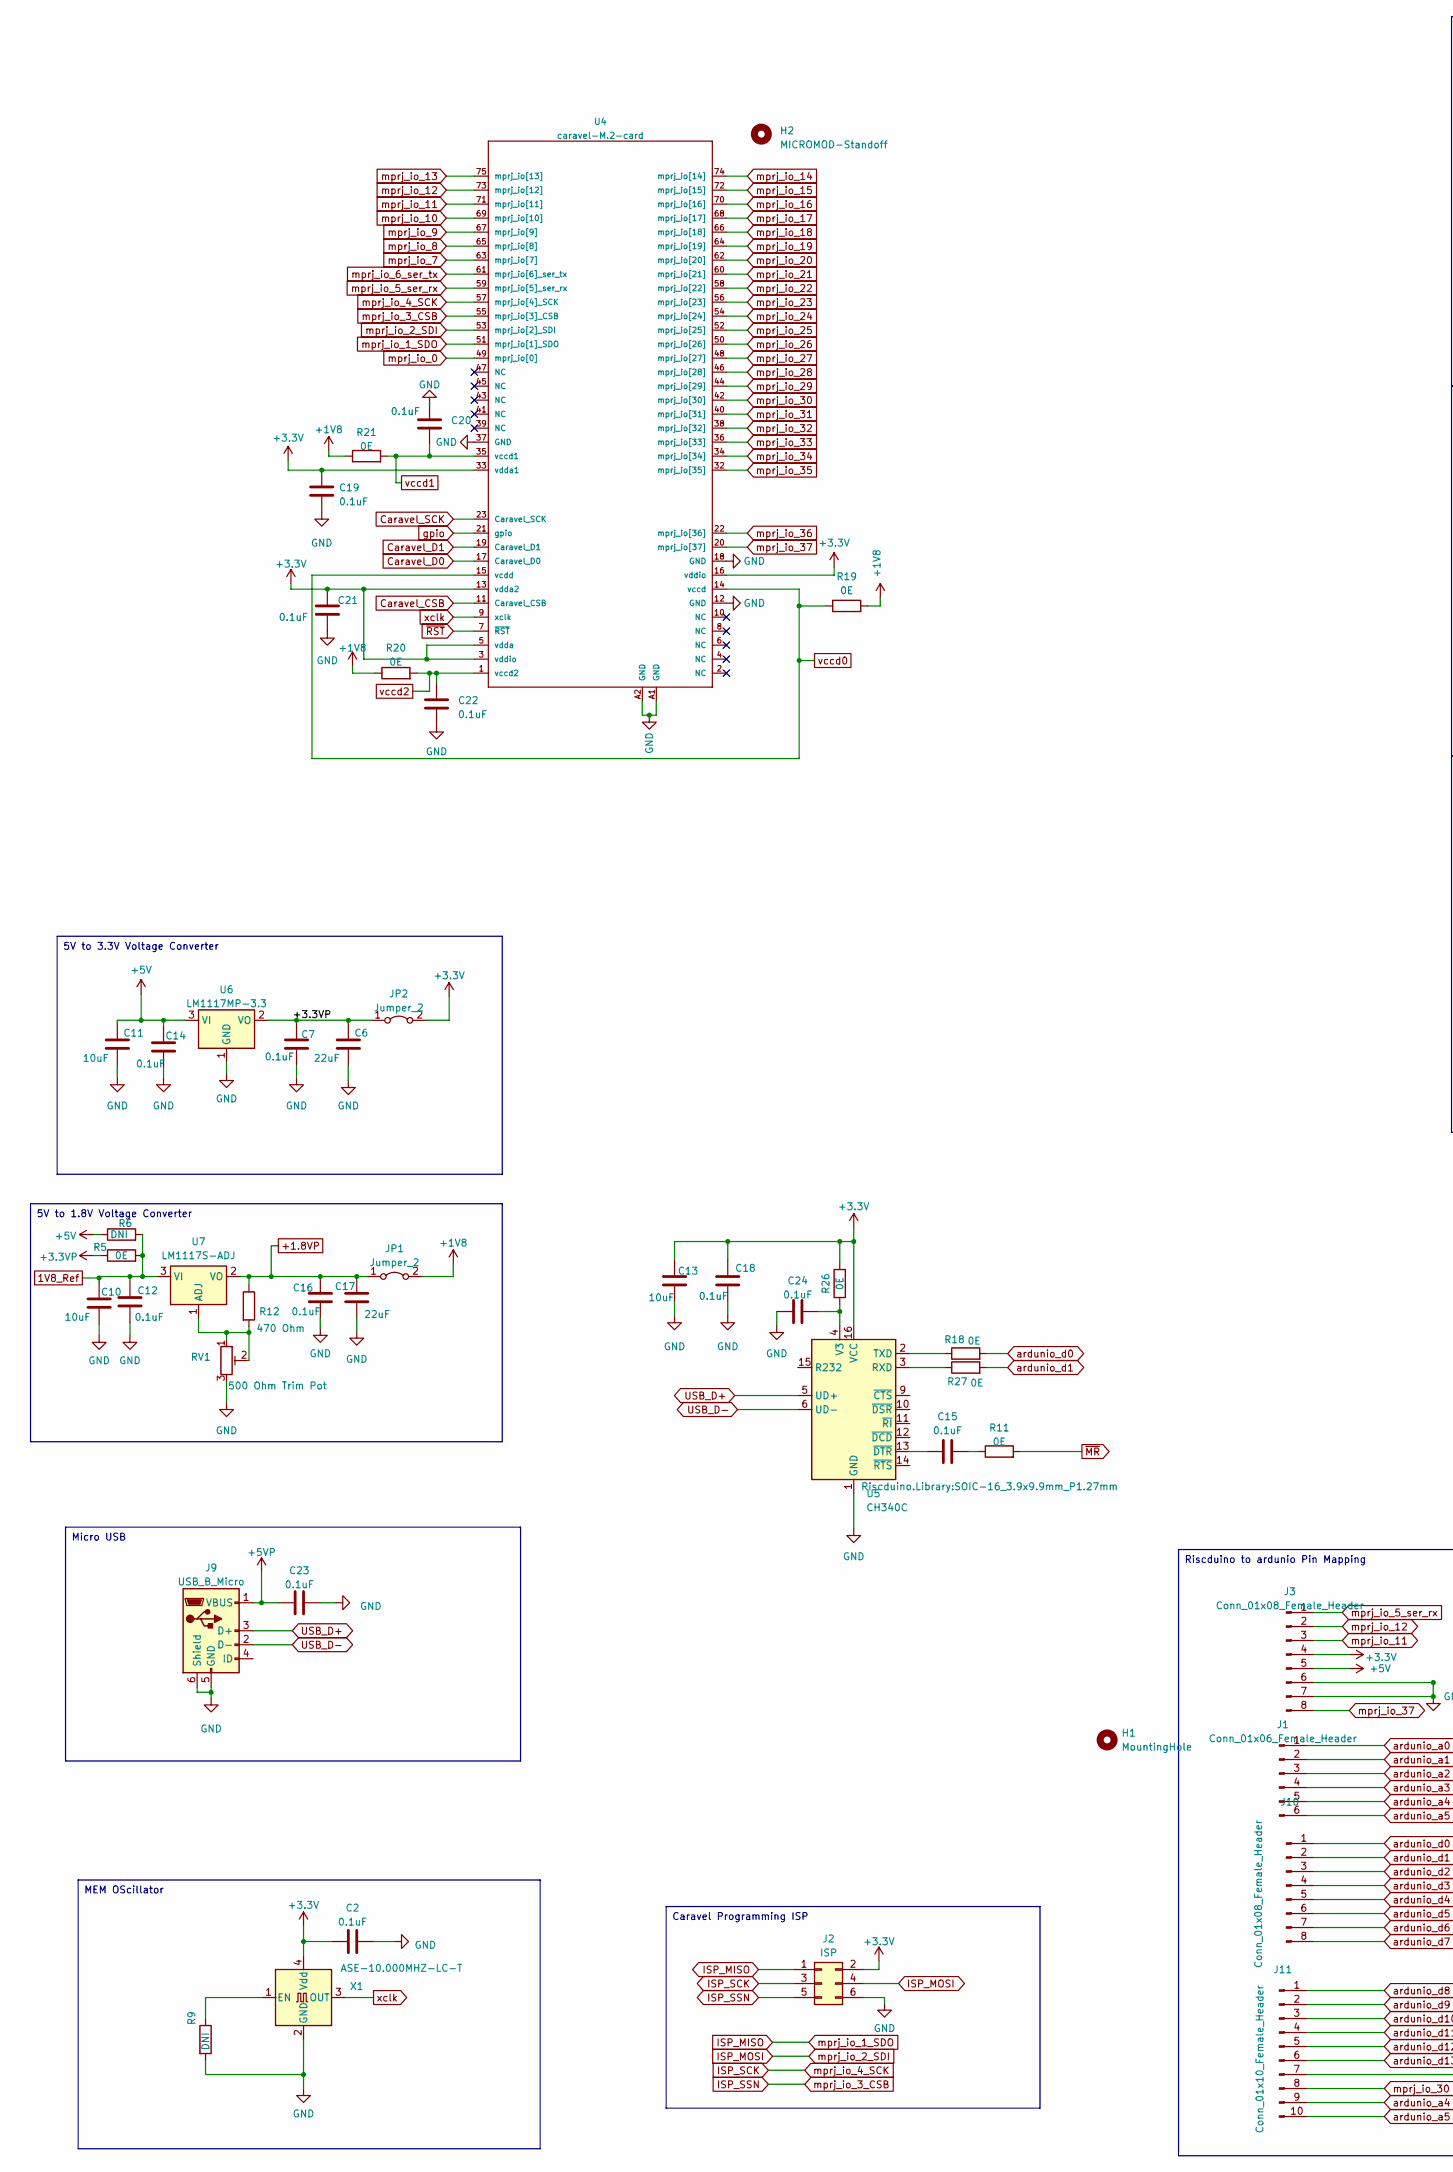
[picture p11: schematic Riscduino_Debug_Rev1.4.kicad_sch, part in row 1, column 1]

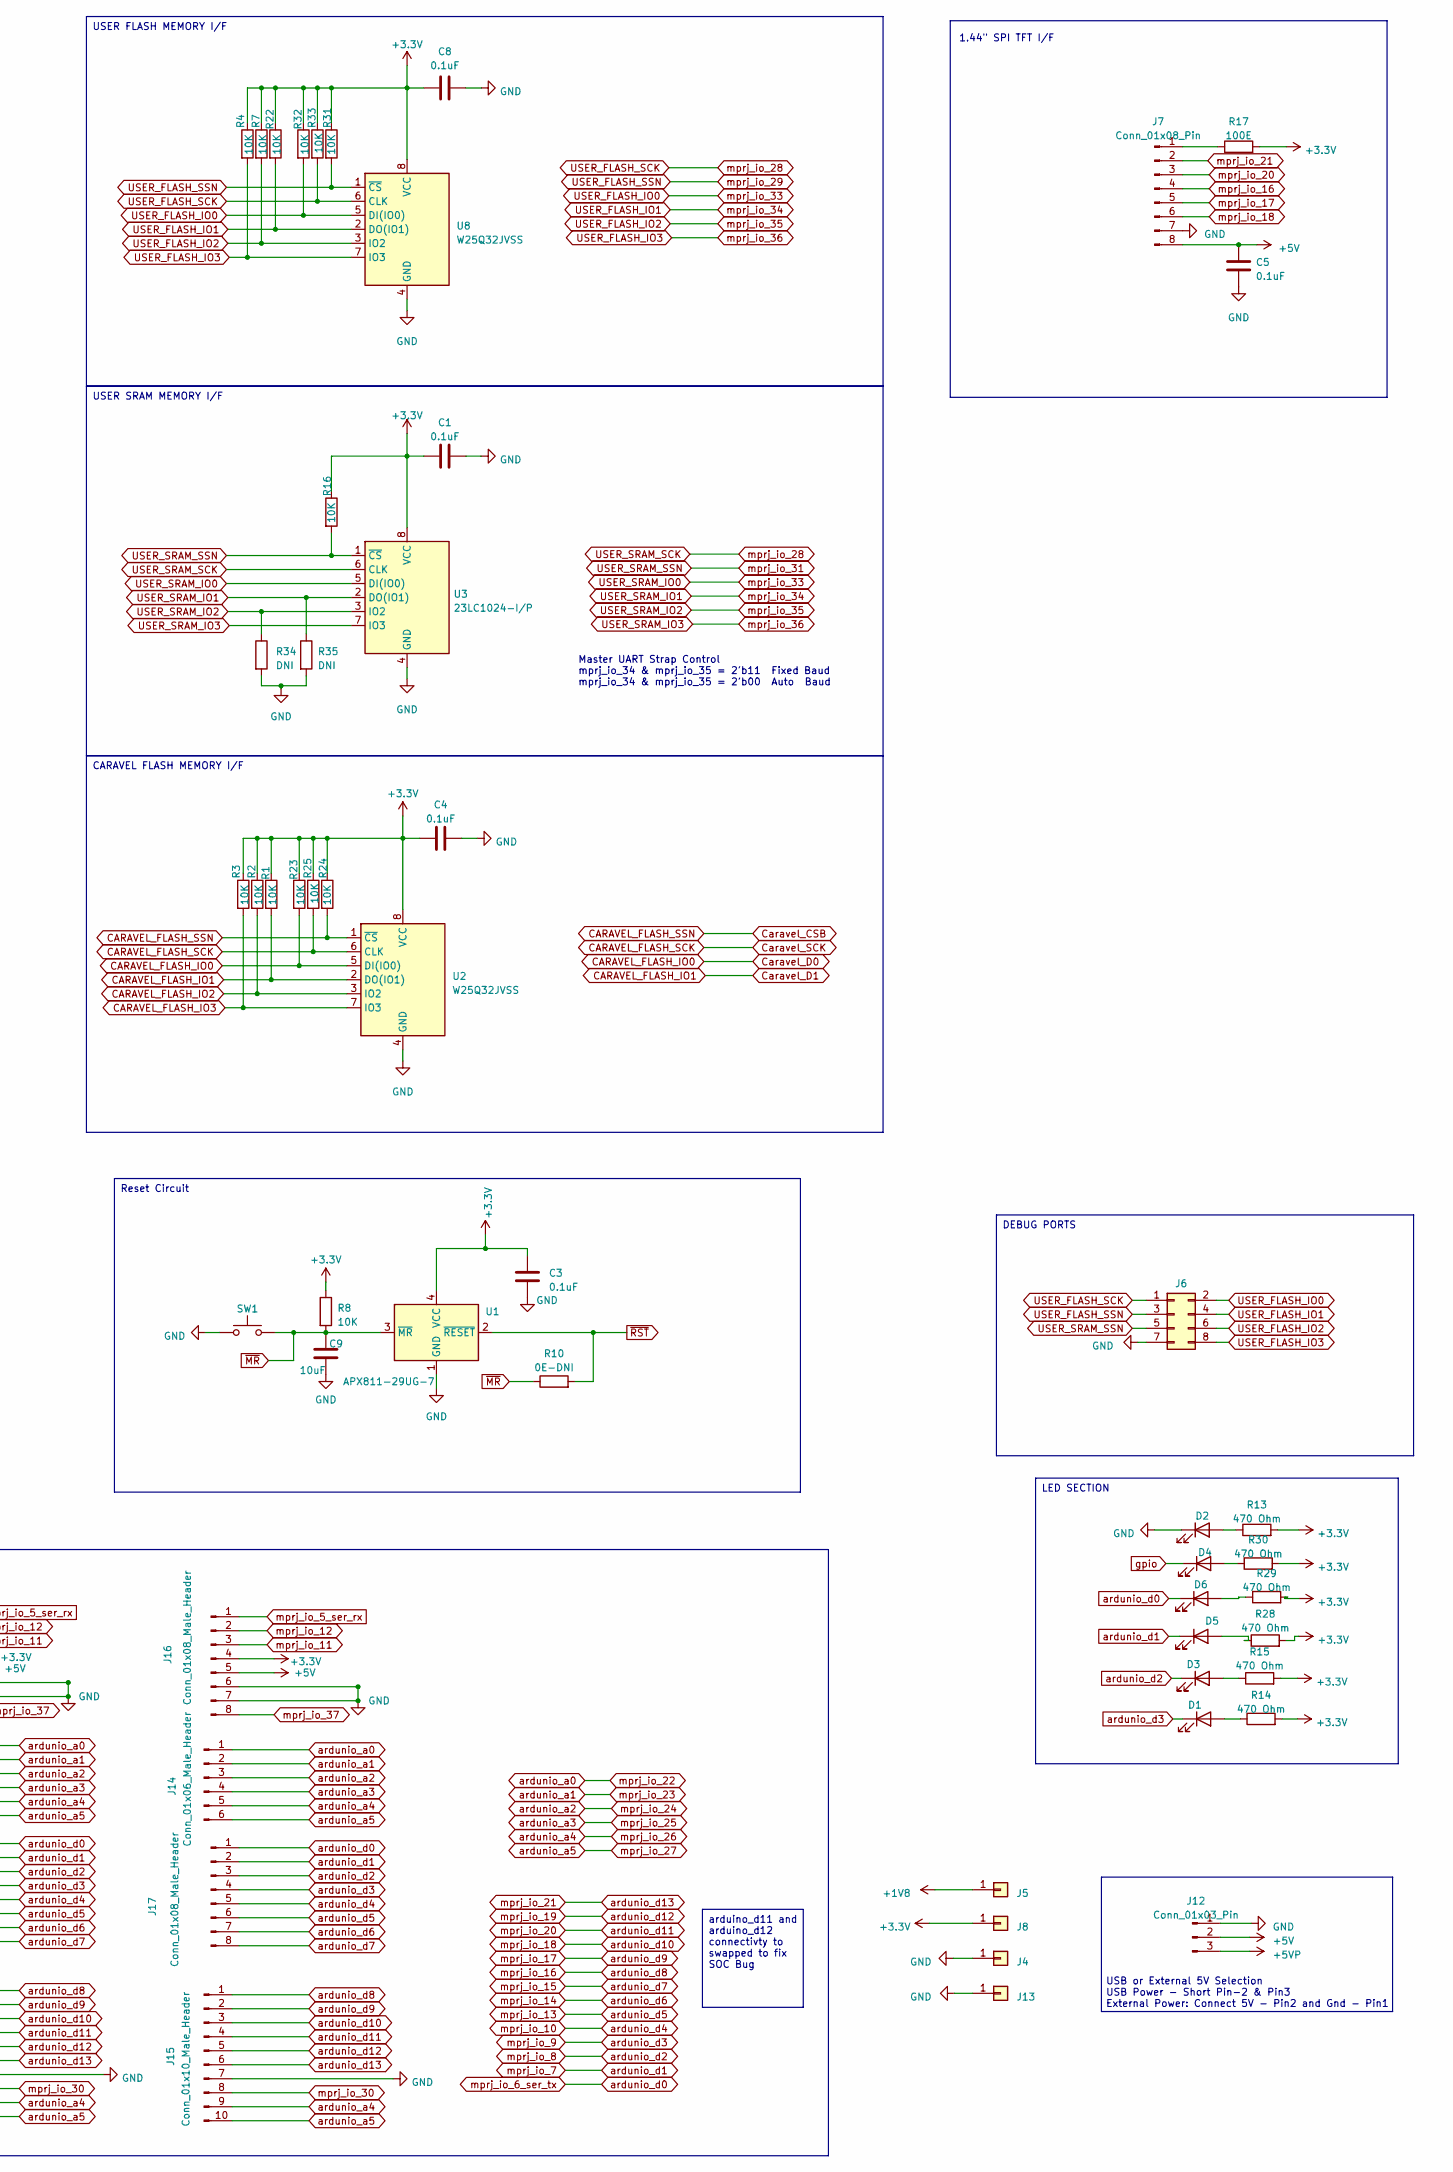
[picture p12: schematic Riscduino_Debug_Rev1.4.kicad_sch, part in row 1, column 2]

Parts:
C1, C2, C3, C4, C5, C7, C8, C12, C14, C15, C16, C18, C19, C20, C21, C22, C23, C24: 0.1uF; C_0603_1608Metric_Pad1.08x0.95mm_HandSolder
C6, C17: 22uF; C_0805_2012Metric_Pad1.18x1.45mm_HandSolder
C9, C10, C11, C13: 10uF; C_0805_2012Metric_Pad1.18x1.45mm_HandSolder
D1, D2, D3, D4, D5: GREEN LED; LED_0805_2012Metric_Pad1.15x1.40mm_HandSolder
D6: BLUE LED; LED_0805_2012Metric_Pad1.15x1.40mm_HandSolder
H1: MountingHole; Arduino_UNO_R3_WithMountingHoles
H2: MICROMOD-Standoff; MicroMod-Standoff
J1: Conn_01x06_Female_Header; PinHeader_1x06_P2.54mm_Vertical
J2: ISP; PinHeader_2x03_P2.54mm_Vertical
J3, J10: Conn_01x08_Female_Header; PinHeader_1x08_P2.54mm_Vertical
J4, J5, J8, J13: Conn_01x01; PinHeader_1x01_P2.54mm_Vertical
J6: Conn_02x04_Odd_Even; PinHeader_2x04_P2.54mm_Vertical
J7: Conn_01x08_Pin; PinHeader_1x08_P2.54mm_Vertical
J9: USB_B_Micro; USB_Micro-B_Molex-105017-0001
J11: Conn_01x10_Female_Header; PinHeader_1x10_P2.54mm_Vertical
J12: Conn_01x03_Pin; PinHeader_1x03_P2.54mm_Vertical
J14: Conn_01x06_Male_Header; PinHeader_1x06_P2.54mm_Vertical
J15: Conn_01x10_Male_Header; PinHeader_1x10_P2.54mm_Vertical
J16, J17: Conn_01x08_Male_Header; PinHeader_1x08_P2.54mm_Vertical
JP1, JP2: Jumper_2; PinHeader_1x02_P2.54mm_Vertical
R1, R2, R3, R4, R7, R8, R16, R22, R23, R24, R25, R31, R32, R33: 10K; R_0603_1608Metric_Pad0.98x0.95mm_HandSolder
R5, R11, R18, R19, R20, R21, R26, R27: 0E; R_0603_1608Metric_Pad0.98x0.95mm_HandSolder
R6, R9, R34, R35: DNI; R_0603_1608Metric_Pad0.98x0.95mm_HandSolder
R10: 0E-DNI; C_0603_1608Metric_Pad1.08x0.95mm_HandSolder
R12, R13, R14, R15, R28, R29, R30: 470 Ohm; R_0603_1608Metric_Pad0.98x0.95mm_HandSolder
R17: 100E; R_0603_1608Metric_Pad0.98x0.95mm_HandSolder
RV1: 500 Ohm Trim Pot; Potentiometer_Bourns_3296W_Vertical
SW1: 4Pin Round Button SPST Straight Tactile Switch SM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; SW_SPST_EVPBF_TS4550TP
U1: APX811-29UG-7; SOT-143_Handsoldering
U2, U8: W25Q32JVSS; SOIC-8_5.23x5.23mm_P1.27mm
U3: 23LC1024-I/P; DIP-8_W7.62mm_LongPads
U4: caravel-M.2-card; M.2-CONNECTOR-E
U5: CH340C; SOIC-16_3.9x9.9mm_P1.27mm
U6: LM1117MP-3.3; SOT-223-3_TabPin2
U7: LM1117S-ADJ; SOT-223-3_TabPin2
X1: ASE-10.000MHZ-LC-T; Crystal_SMD_Abracon_ABM8G-4Pin_3.2x2.5mm

Connections:
1V8_Ref: C10.1, C12.1, R5.2, R6.2, U7.3 (VI)
+1.8VP: C16.1, C17.1, JP1.1 (A), R12.1, U7.2 (VO)
+1V8: J5.1, JP1.2 (B), R19.2, R20.1, R21.1
+3.3V: C1.1, C2.1, C3.1, C4.1, C8.1, C13.1, C18.1, C19.1, C21.1, J2.2, J3.4, J8.1, J16.4, JP2.2 (B), R1.1, R2.1, R3.1, R4.1, R7.1, R8.1, R13.2, R14.2, R15.2, R16.1, R17.2, R22.1, R23.1, R24.1, R25.1, R26.2, R28.2, R29.2, R30.2, R31.1, R32.1, R33.1, U1.4 (VCC), U2.8 (VCC), U3.8 (VCC), U4.3 (vddio), U4.5 (vdda), U4.13 (vdda2), U4.16 (vddio), U4.33 (vdda1), U5.16 (VCC), U8.8 (VCC), X1.4 (Vdd)
+3.3VP: C6.1, C7.1, JP2.1 (A), R5.1, U6.2 (VO)
+5V: C5.1, C11.1, C14.1, J3.5, J7.8, J12.2, J16.5, R6.1, U6.3 (VI)
+5VP: C23.1, J9.1 (VBUS), J12.3
CARAVEL_FLASH_IO0: R23.2, U2.5 (DI(IO0)), U4.17 (Caravel_D0)
CARAVEL_FLASH_IO1: R1.2, U2.2 (DO(IO1)), U4.19 (Caravel_D1)
CARAVEL_FLASH_IO2: R2.2, U2.3 (IO2)
CARAVEL_FLASH_IO3: R3.2, U2.7 (IO3)
CARAVEL_FLASH_SCK: R25.2, U2.6 (CLK), U4.23 (Caravel_SCK)
CARAVEL_FLASH_SSN: R24.2, U2.1 (~CS), U4.11 (Caravel_CSB)
GND: C1.2, C2.2, C3.2, C4.2, C5.2, C6.2, C7.2, C8.2, C9.2, C10.2, C11.2, C12.2, C13.2, C14.2, C16.2, C17.2, C18.2, C19.2, C20.1, C21.2, C22.2, C23.2, C24.1, D2.1 (K), J2.6, J3.6, J3.7, J4.1, J6.7, J7.7, J9.5 (GND), J9.6 (Shield), J11.7, J12.1, J13.1, J15.7, J16.6, J16.7, R9.2, R34.2, R35.2, RV1.3, SW1.1, U1.1 (GND), U2.4 (GND), U3.4 (GND), U4.12 (GND), U4.18 (GND), U4.37 (GND), U4.A1 (GND), U4.A2 (GND), U5.1 (GND), U6.1 (GND), U8.4 (GND), X1.2 (GND)
ISP_MISO: J2.1, U4.51 (mprj_io[1]_SDO)
ISP_MOSI: J2.4, U4.53 (mprj_io[2]_SDI)
ISP_SCK: J2.3, U4.57 (mprj_io[4]_SCK)
ISP_SSN: J2.5, U4.55 (mprj_io[3]_CSB)
unnamed: C15.2, R11.1
unnamed 19: D1.2 (A), R14.1; also elsewhere on the board
unnamed: D2.2 (A), R13.1
unnamed: D3.2 (A), R15.1
unnamed: D4.2 (A), R30.1
unnamed: D5.2 (A), R28.1
unnamed: D6.2 (A), R29.1
unnamed: J7.1, R17.1
unnamed: R27.1, U5.3 (RXD)
unnamed: R18.1, U5.2 (TXD)
unnamed: C24.2, R26.1, U5.4 (V3)
unnamed: C15.1, U5.13 (~DTR)
unnamed: R12.2, RV1.1, RV1.2, U7.1 (ADJ)
unnamed: R9.1, X1.1 (EN)
USB_D+: J9.3 (D+), U5.5 (UD+)
USB_D-: J9.2 (D-), U5.6 (UD-)
USER_FLASH_IO0: J6.2, R32.2, U3.5 (DI(IO0)), U4.36 (mprj_io[33]), U8.5 (DI(IO0))
USER_FLASH_IO1: J6.4, R22.2, R35.1, U3.2 (DO(IO1)), U4.34 (mprj_io[34]), U8.2 (DO(IO1))
USER_FLASH_IO2: J6.6, R7.2, R34.1, U3.3 (IO2), U4.32 (mprj_io[35]), U8.3 (IO2)
USER_FLASH_IO3: J6.8, R4.2, U3.7 (IO3), U4.22 (mprj_io[36]), U8.7 (IO3)
USER_FLASH_SCK: J6.1, R33.2, U3.6 (CLK), U4.46 (mprj_io[28]), U8.6 (CLK)
USER_FLASH_SSN: J6.3, R31.2, U4.44 (mprj_io[29]), U8.1 (~CS)
USER_SRAM_SSN: J6.5, R16.2, U3.1 (~CS), U4.40 (mprj_io[31])
ardunio_a0: J1.1, J14.1, U4.58 (mprj_io[22])
ardunio_a1: J1.2, J14.2, U4.56 (mprj_io[23])
ardunio_a2: J1.3, J14.3, U4.54 (mprj_io[24])
ardunio_a3: J1.4, J14.4, U4.52 (mprj_io[25])
ardunio_a4: J1.5, J11.9, J14.5, J15.9, U4.50 (mprj_io[26])
ardunio_a5: J1.6, J11.10, J14.6, J15.10, U4.48 (mprj_io[27])
ardunio_d0: D6.1 (K), J10.1, J17.1, R18.2, U4.61 (mprj_io[6]_ser_tx)
ardunio_d1: D5.1 (K), J10.2, J17.2, R27.2, U4.63 (mprj_io[7])
ardunio_d2: D3.1 (K), J10.3, J17.3, U4.65 (mprj_io[8])
ardunio_d3: D1.1 (K), J10.4, J17.4, U4.67 (mprj_io[9]), U8.67; also elsewhere on the board
ardunio_d4: J10.5, J17.5, U4.69 (mprj_io[10])
ardunio_d5: J10.6, J17.6, U4.75 (mprj_io[13])
ardunio_d6: J10.7, J17.7, U4.74 (mprj_io[14])
ardunio_d7: J10.8, J17.8, U4.72 (mprj_io[15])
ardunio_d8: J7.4, J11.1, J15.1, U4.70 (mprj_io[16])
ardunio_d9: J7.5, J11.2, J15.2, U4.68 (mprj_io[17])
ardunio_d10: J7.6, J11.3, J15.3, U4.66 (mprj_io[18])
ardunio_d11: J7.3, J11.4, J15.4, U4.62 (mprj_io[20])
ardunio_d12: J11.5, J15.5, U4.64 (mprj_io[19])
ardunio_d13: J7.2, J11.6, J15.6, U4.60 (mprj_io[21])
gpio: D4.1 (K), U4.21 (gpio)
mprj_io_0: U4.49 (mprj_io[0])
mprj_io_5_ser_rx: J3.1, J16.1, U4.59 (mprj_io[5]_ser_rx)
mprj_io_11: J3.3, J16.3, U4.71 (mprj_io[11])
mprj_io_12: J3.2, J16.2, U4.73 (mprj_io[12])
mprj_io_30: J11.8, J15.8, U4.42 (mprj_io[30])
mprj_io_32: U4.38 (mprj_io[32])
mprj_io_37: J3.8, J16.8, U4.20 (mprj_io[37])
vccd0: R19.1, U4.14 (vccd), U4.15 (vcdd)
vccd1: C20.2, R21.2, U4.35 (vccd1)
vccd2: C22.1, R20.2, U4.1 (vccd2)
xclk: U4.9 (xclk), X1.3 (OUT)
~MR: C9.1, R8.2, R10.1, R11.2, SW1.2, U1.3 (~MR)
~RST: R10.2, U1.2 (~RESET), U4.7 (~RST)

Notes on the sheet:
MEM OScillator
5V to 3.3V Voltage Converter
LED SECTION
Riscduino to ardunio Pin Mapping
Micro USB
arduino_d11 and arduino_d12 connectivty to swapped to fix SOC Bug
USER SRAM MEMORY I/F
DEBUG PORTS
Caravel Programming ISP
USER FLASH MEMORY I/F
5V to 1.8V Voltage Converter
Reset Circuit
CARAVEL FLASH MEMORY I/F
USB or External 5V Selection USB Power - Short Pin-2 & Pin3 External Power: Connect 5V - Pin2 and Gnd - Pin1
1.44" SPI TFT I/F
Master UART Strap Control mprj_io_34 & mprj_io_35 = 2'b11 Fixed Baud mprj_io_34 & mprj_io_35 = 2'b00 Auto Baud
