dineshannayya/riscduino_board/KiCad_PCB/Riscduino_Debug_Rev1.4/Riscduino_Debug_Rev1.4.kicad_pcb

## KiCad design KiCad_PCB/Riscduino_Debug_Rev1.4/Riscduino_Debug_Rev1.4.kicad_pcb (continued)

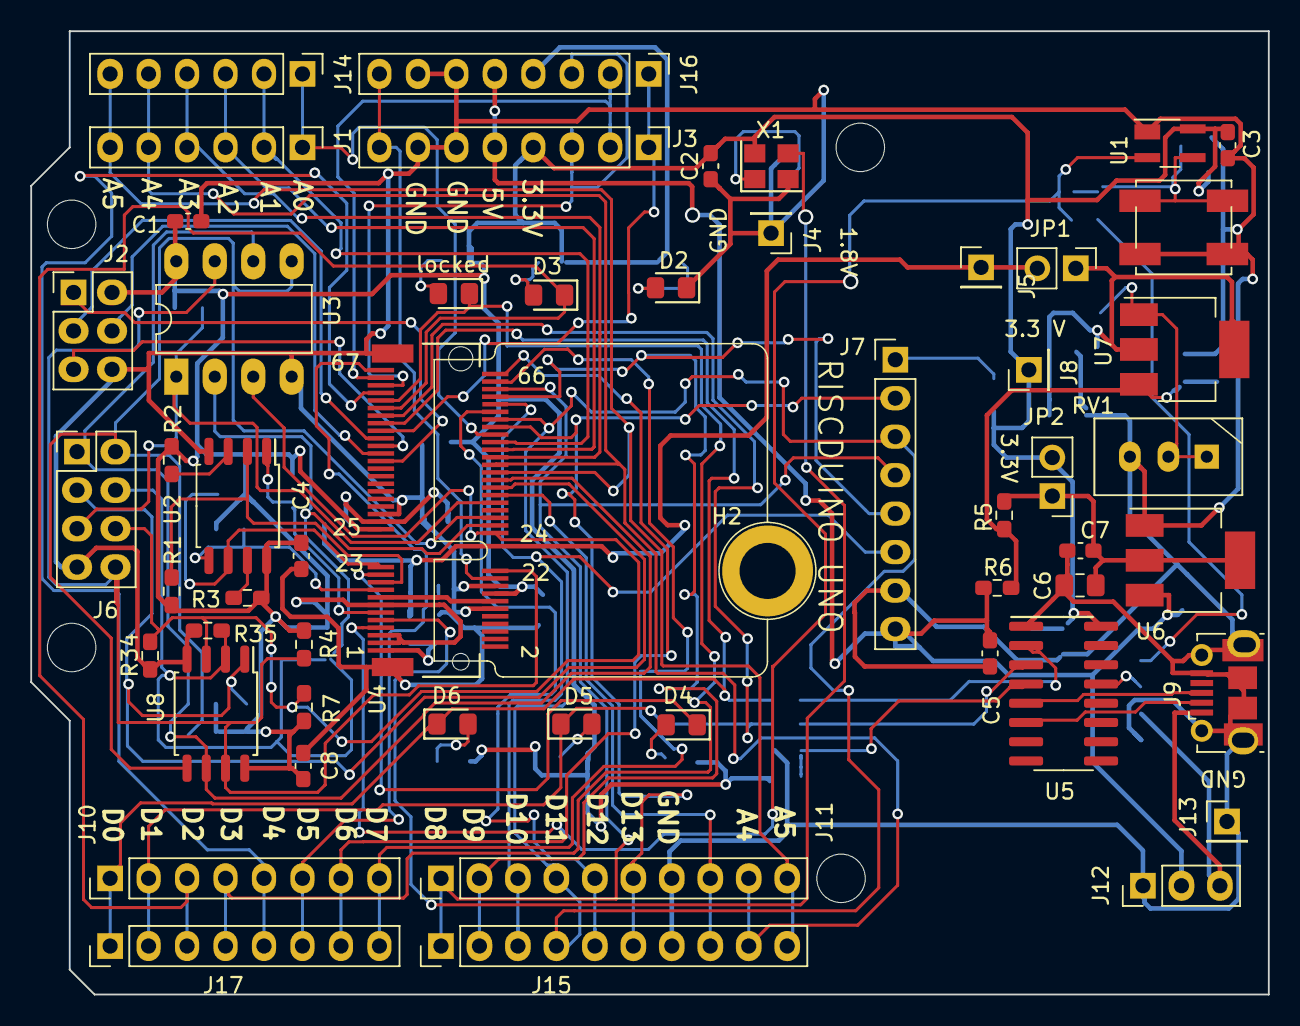
[picture p13: board Riscduino_Debug_Rev1.4.kicad_pcb from above]

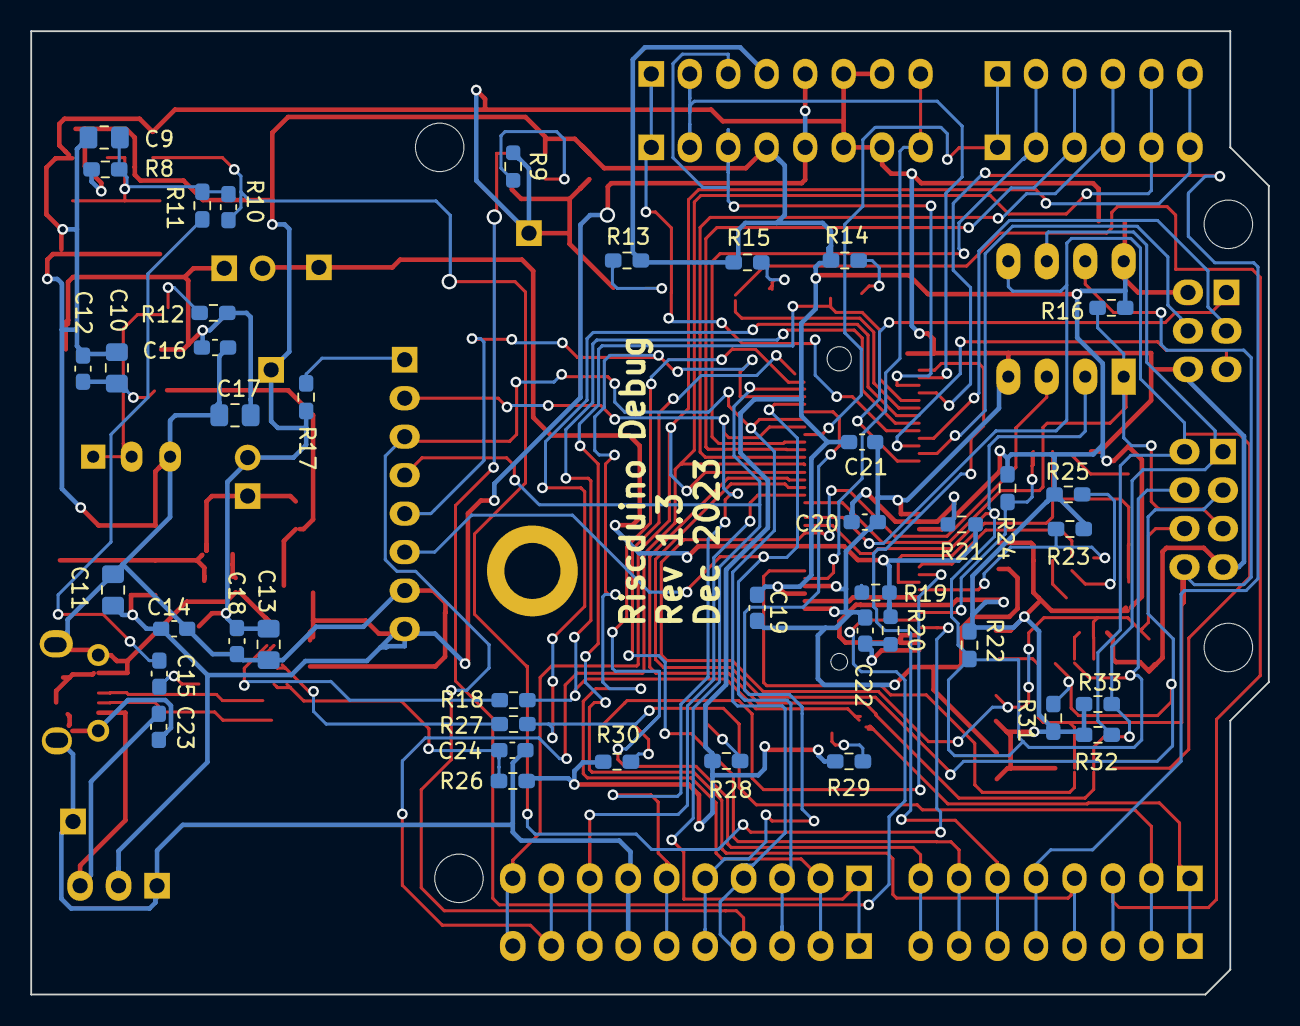
[picture p14: board Riscduino_Debug_Rev1.4.kicad_pcb from below]

Board: 2 copper layers, 81.7 x 63.6 mm, 97 parts (42 on the bottom side), 73 nets.

Other parts of the board:
locked: GREEN LED; LED_0805_2012Metric_Pad1.15x1.40mm_HandSolder

Their connections:
unnamed 19: locked.2 (A); also elsewhere on the board
ardunio_d3: locked.1 (K); also elsewhere on the board
