dineshannayya/riscduino_board/KiCad_PCB/Riscduino_Uno_Rev1.3/Riscduino_Uno.kicad_pcb

## KiCad design KiCad_PCB/Riscduino_Uno_Rev1.3/Riscduino_Uno.kicad_pcb (2023-09-16)

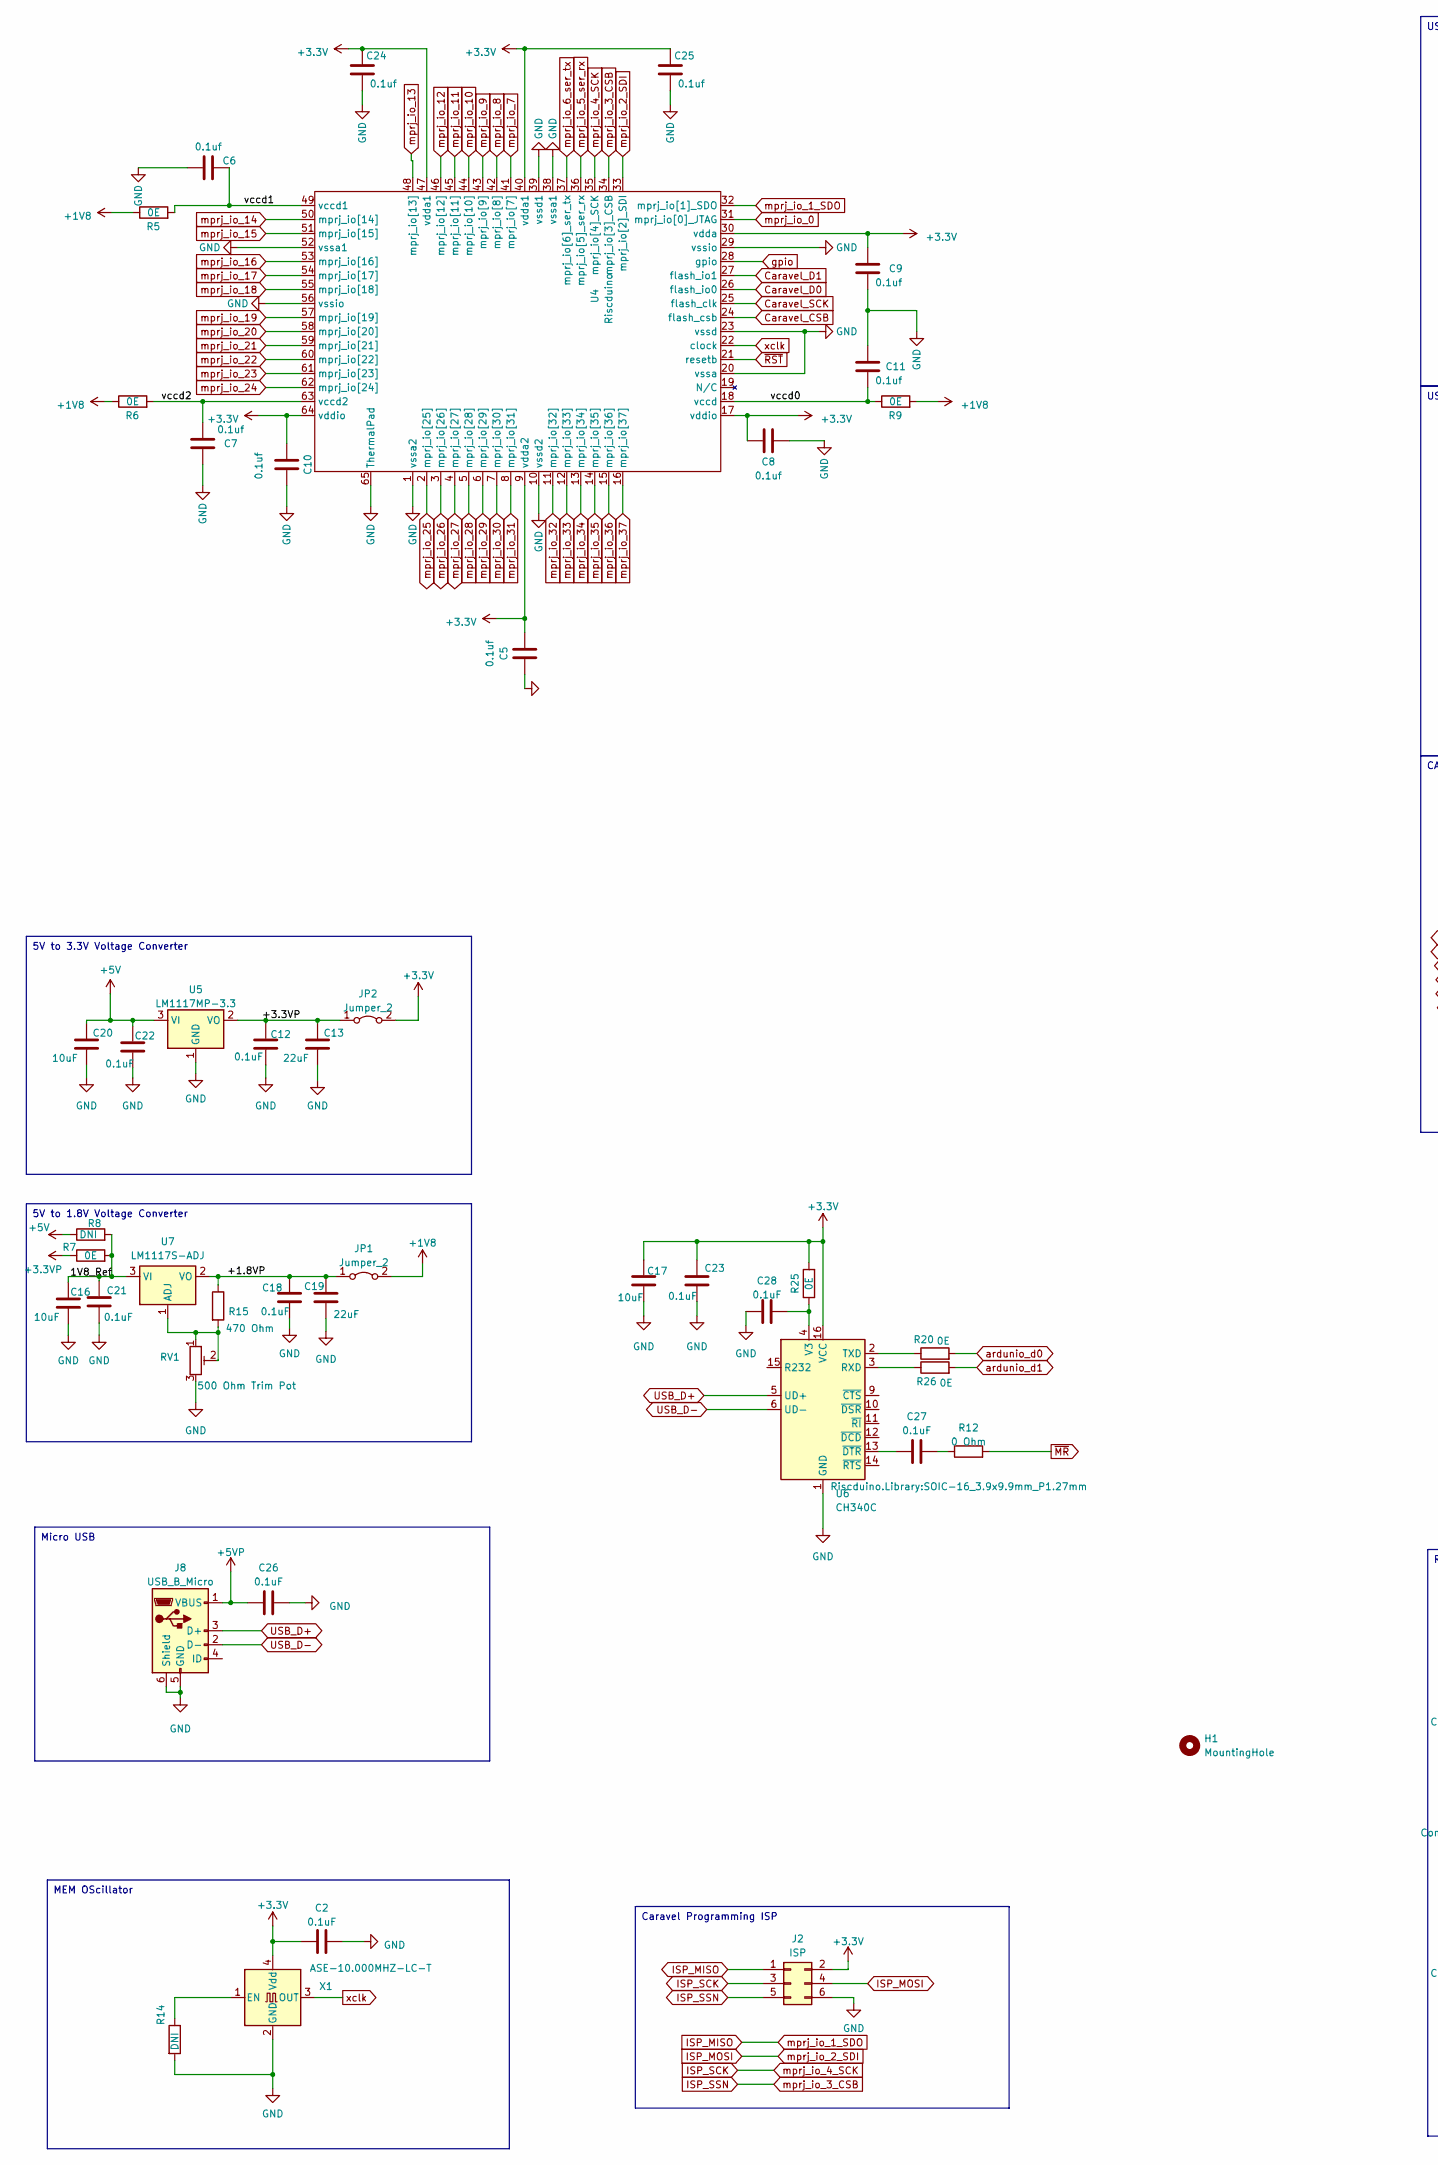
[picture p15: schematic Riscduino_Uno.kicad_sch, part in row 1, column 1]

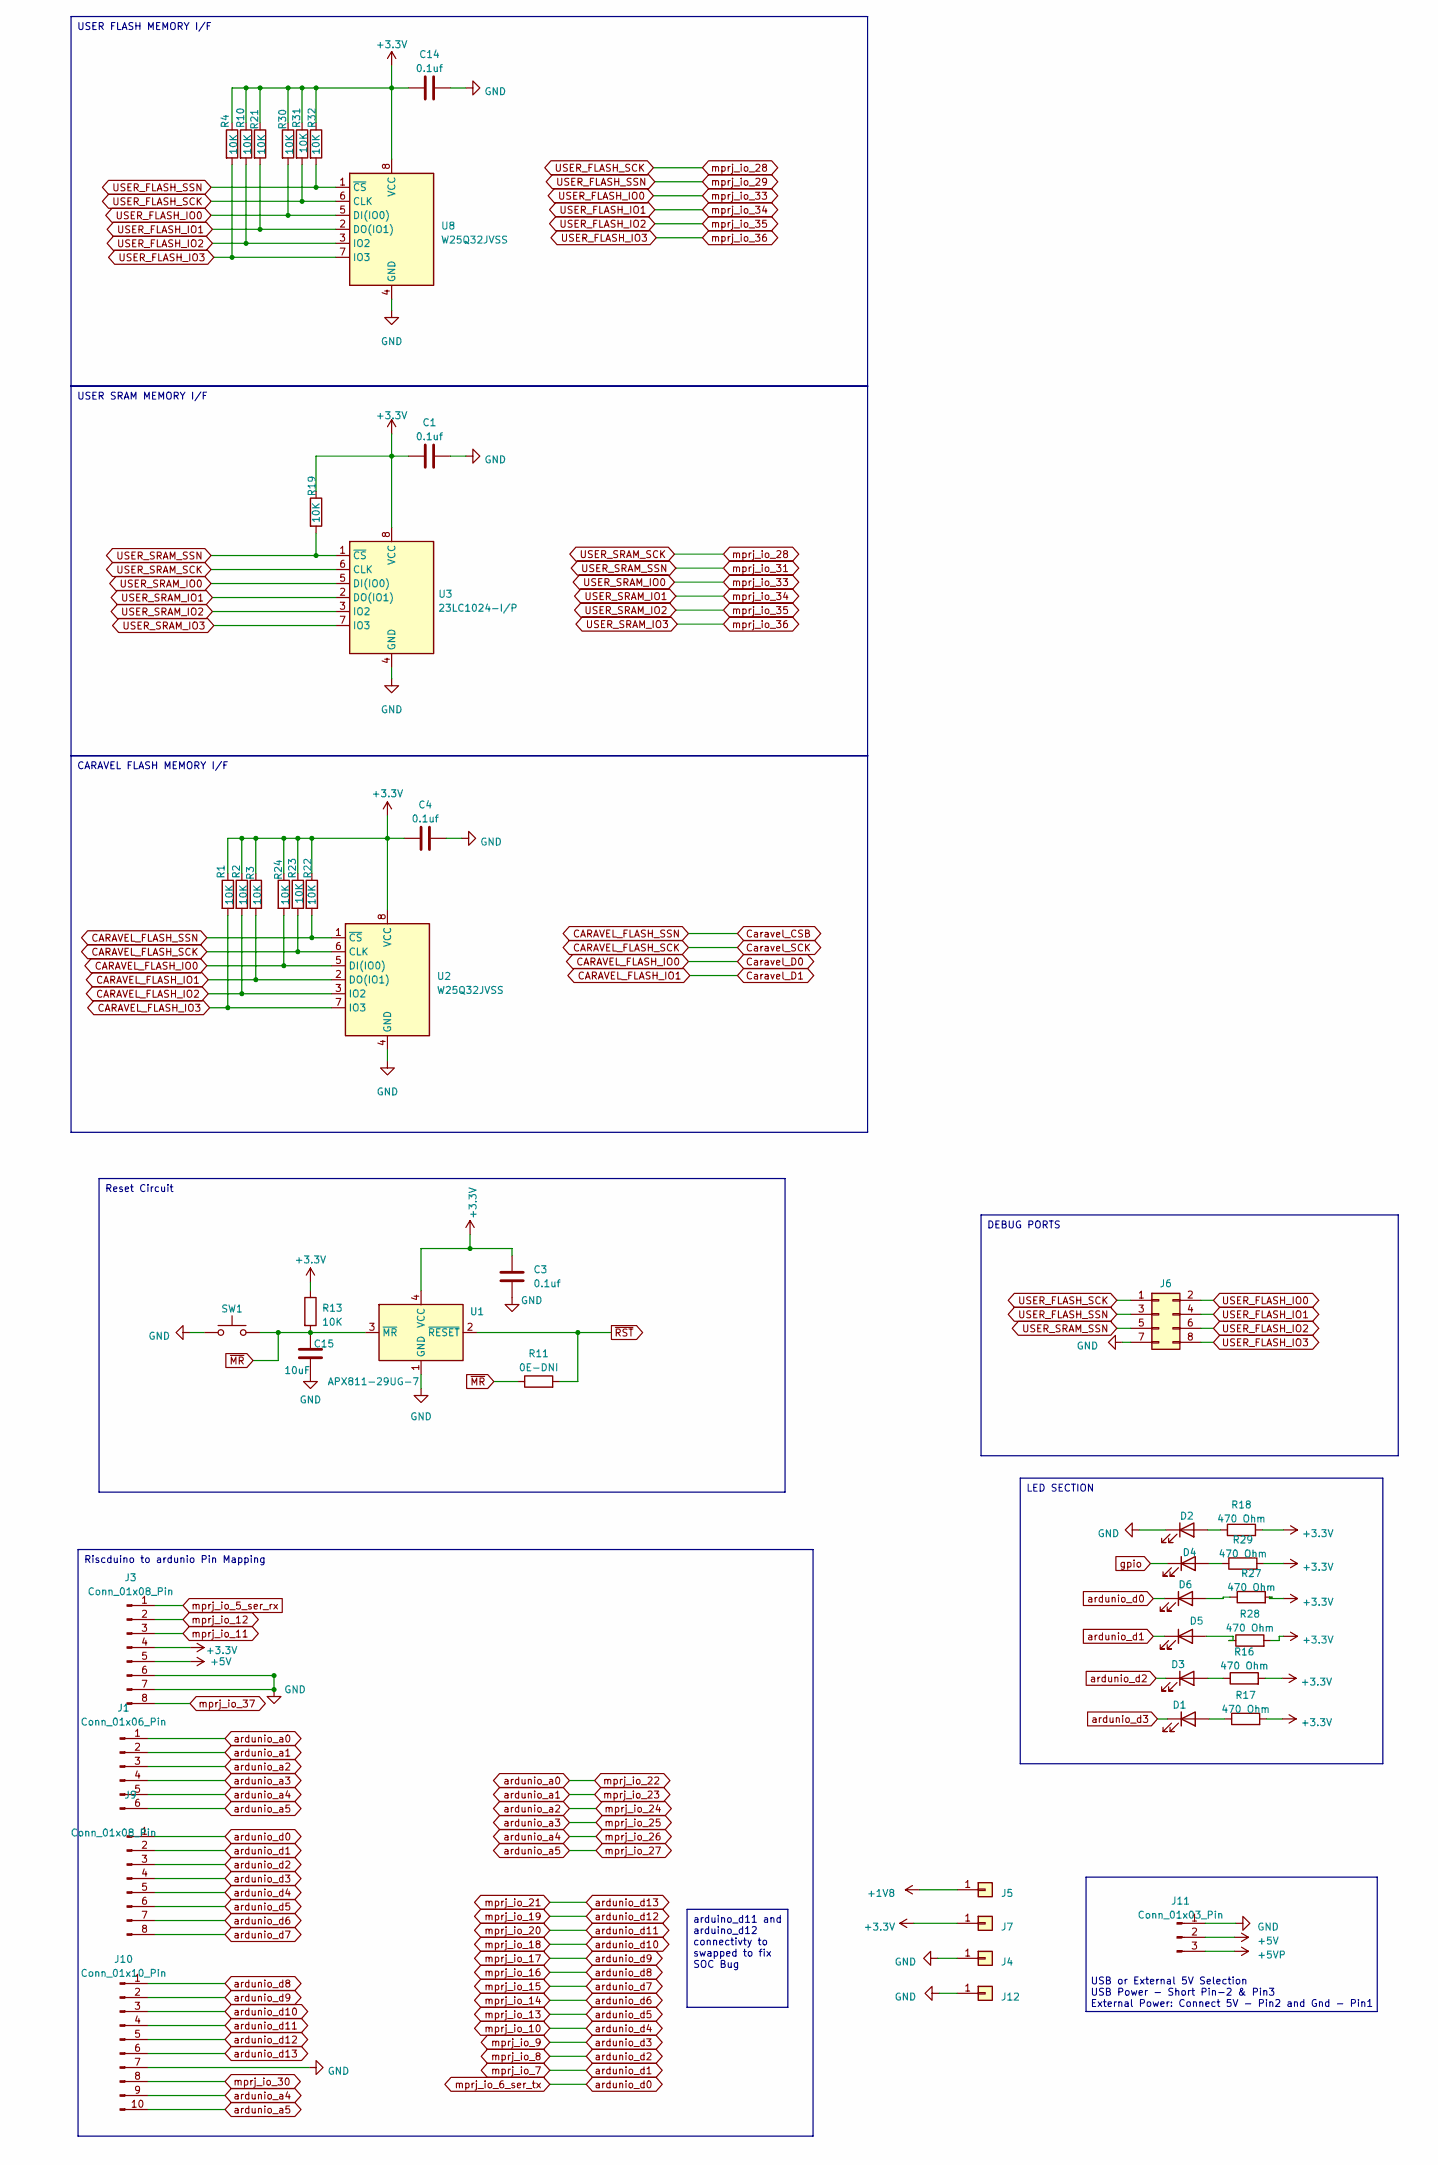
[picture p16: schematic Riscduino_Uno.kicad_sch, part in row 1, column 2]

Parts:
C1, C3, C4, C5, C6, C7, C8, C9, C10, C11, C14, C24, C25: 0.1uf; C_0603_1608Metric_Pad1.08x0.95mm_HandSolder
C2, C12, C18, C21, C22, C23, C26, C27, C28: 0.1uF; C_0603_1608Metric_Pad1.08x0.95mm_HandSolder
C13, C19: 22uF; C_0805_2012Metric_Pad1.18x1.45mm_HandSolder
C15, C16, C17, C20: 10uF; C_0805_2012Metric_Pad1.18x1.45mm_HandSolder
D1, D2, D3, D4, D5: GREEN LED; LED_0805_2012Metric_Pad1.15x1.40mm_HandSolder
D6: BLUE LED; LED_0805_2012Metric_Pad1.15x1.40mm_HandSolder
H1: MountingHole; Arduino_UNO_R3_WithMountingHoles
J1: Conn_01x06_Pin; PinHeader_1x06_P2.54mm_Vertical
J2: ISP; PinHeader_2x03_P2.54mm_Vertical
J3, J9: Conn_01x08_Pin; PinHeader_1x08_P2.54mm_Vertical
J4, J5, J7, J12: Conn_01x01; PinHeader_1x01_P2.54mm_Vertical
J6: Conn_02x04_Odd_Even; PinHeader_2x04_P2.54mm_Vertical
J8: USB_B_Micro; USB_Micro-B_Molex-105017-0001
J10: Conn_01x10_Pin; PinHeader_1x10_P2.54mm_Vertical
J11: Conn_01x03_Pin; PinHeader_1x03_P2.54mm_Vertical
JP1, JP2: Jumper_2; PinHeader_1x02_P2.54mm_Vertical
R1, R2, R3, R4, R10, R13, R19, R21, R22, R23, R24, R30, R31, R32: 10K; R_0603_1608Metric_Pad0.98x0.95mm_HandSolder
R5, R6, R7, R9, R20, R25, R26: 0E; R_0603_1608Metric_Pad0.98x0.95mm_HandSolder
R8, R14: DNI; R_0603_1608Metric_Pad0.98x0.95mm_HandSolder
R11: 0E-DNI; C_0603_1608Metric_Pad1.08x0.95mm_HandSolder
R12: 0 Ohm; R_0603_1608Metric_Pad0.98x0.95mm_HandSolder
R15, R16, R17, R18, R27, R28, R29: 470 Ohm; R_0603_1608Metric_Pad0.98x0.95mm_HandSolder
RV1: 500 Ohm Trim Pot; Potentiometer_Bourns_3296W_Vertical
SW1: 4Pin Round Button SPST Straight Tactile Switch SM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; SW_SPST_EVPBF_TS4550TP
U1: APX811-29UG-7; SOT-143_Handsoldering
U2, U8: W25Q32JVSS; SOIC-8_5.23x5.23mm_P1.27mm
U3: 23LC1024-I/P; DIP-8_W7.62mm_LongPads
U4: Riscduino; RISCDUINO_QFN-64-1EP_9x9mm_P0.5mm_EP7.65x7.65mm_Ver1.1
U5: LM1117MP-3.3; SOT-223-3_TabPin2
U6: CH340C; SOIC-16_3.9x9.9mm_P1.27mm
U7: LM1117S-ADJ; SOT-223-3_TabPin2
X1: ASE-10.000MHZ-LC-T; Crystal_SMD_Abracon_ABM8G-4Pin_3.2x2.5mm

Connections:
+1V8: J5.1, JP1.2 (B), R5.1, R6.1, R9.2
+3.3V: C1.1, C2.1, C3.1, C4.1, C5.2, C8.2, C9.1, C10.2, C14.1, C17.1, C23.1, C24.1, C25.1, J2.2, J3.4, J7.1, JP2.2 (B), R1.1, R2.1, R3.1, R4.1, R10.1, R13.1, R16.2, R17.2, R18.2, R19.1, R21.1, R22.1, R23.1, R24.1, R25.2, R27.2, R28.2, R29.2, R30.1, R31.1, R32.1, U1.4 (VCC), U2.8 (VCC), U3.8 (VCC), U4.9 (vdda2), U4.17 (vddio), U4.30 (vdda), U4.40 (vdda1), U4.47 (vdda1), U4.64 (vddio), U6.16 (VCC), U8.8 (VCC), X1.4 (Vdd)
+3.3VP: C12.1, C13.1, JP2.1 (A), R7.1, U5.2 (VO)
+5V: C20.1, C22.1, J3.5, J11.2, R8.1, U5.3 (VI)
+5VP: C26.1, J8.1 (VBUS), J11.3
/+1.8VP: C18.1, C19.1, JP1.1 (A), R15.1, U7.2 (VO)
/vccd0: C11.2, R9.1, U4.18 (vccd)
/vccd1: C6.2, R5.2, U4.49 (vccd1)
/vccd2: C7.1, R6.2, U4.63 (vccd2)
CARAVEL_FLASH_IO0: R24.2, U2.5 (DI(IO0)), U4.26 (flash_io0)
CARAVEL_FLASH_IO1: R3.2, U2.2 (DO(IO1)), U4.27 (flash_io1)
CARAVEL_FLASH_IO2: R2.2, U2.3 (IO2)
CARAVEL_FLASH_IO3: R1.2, U2.7 (IO3)
CARAVEL_FLASH_SCK: R23.2, U2.6 (CLK), U4.25 (flash_clk)
CARAVEL_FLASH_SSN: R22.2, U2.1 (~CS), U4.24 (flash_csb)
GND: C1.2, C2.2, C3.2, C4.2, C5.1, C6.1, C7.2, C8.1, C9.2, C10.1, C11.1, C12.2, C13.2, C14.2, C15.2, C16.2, C17.2, C18.2, C19.2, C20.2, C21.2, C22.2, C23.2, C24.2, C25.2, C26.2, C28.1, D2.1 (K), J2.6, J3.6, J3.7, J4.1, J6.7, J8.5 (GND), J8.6 (Shield), J10.7, J11.1, J12.1, R14.2, RV1.3, SW1.1, U1.1 (GND), U2.4 (GND), U3.4 (GND), U4.1 (vssa2), U4.10 (vssd2), U4.20 (vssa), U4.23 (vssd), U4.29 (vssio), U4.38 (vssa1), U4.39 (vssd1), U4.52 (vssa1), U4.56 (vssio), U4.65 (ThermalPad), U5.1 (GND), U6.1 (GND), U8.4 (GND), X1.2 (GND)
ISP_MISO: J2.1, U4.32 (mprj_io[1]_SDO)
ISP_MOSI: J2.4, U4.33 (mprj_io[2]_SDI)
ISP_SCK: J2.3, U4.35 (mprj_io[4]_SCK)
ISP_SSN: J2.5, U4.34 (mprj_io[3]_CSB)
unnamed: C27.2, R12.1
unnamed 21: D1.2 (A), R17.1; also elsewhere on the board
unnamed: D2.2 (A), R18.1
unnamed: D3.2 (A), R16.1
unnamed: D4.2 (A), R29.1
unnamed: D5.2 (A), R28.1
unnamed: D6.2 (A), R27.1
unnamed: R26.1, U6.3 (RXD)
unnamed: R20.1, U6.2 (TXD)
unnamed: C28.2, R25.1, U6.4 (V3)
unnamed: C27.1, U6.13 (~DTR)
unnamed: R15.2, RV1.1, RV1.2, U7.1 (ADJ)
unnamed: C16.1, C21.1, R7.2, R8.2, U7.3 (VI)
unnamed: R14.1, X1.1 (EN)
USB_D+: J8.3 (D+), U6.5 (UD+)
USB_D-: J8.2 (D-), U6.6 (UD-)
USER_FLASH_IO0: J6.2, R30.2, U3.5 (DI(IO0)), U4.12 (mprj_io[33]), U8.5 (DI(IO0))
USER_FLASH_IO1: J6.4, R21.2, U3.2 (DO(IO1)), U4.13 (mprj_io[34]), U8.2 (DO(IO1))
USER_FLASH_IO2: J6.6, R10.2, U3.3 (IO2), U4.14 (mprj_io[35]), U8.3 (IO2)
USER_FLASH_IO3: J6.8, R4.2, U3.7 (IO3), U4.15 (mprj_io[36]), U8.7 (IO3)
USER_FLASH_SCK: J6.1, R31.2, U3.6 (CLK), U4.5 (mprj_io[28]), U8.6 (CLK)
USER_FLASH_SSN: J6.3, R32.2, U4.6 (mprj_io[29]), U8.1 (~CS)
USER_SRAM_SSN: J6.5, R19.2, U3.1 (~CS), U4.8 (mprj_io[31])
ardunio_a0: J1.1, U4.60 (mprj_io[22])
ardunio_a1: J1.2, U4.61 (mprj_io[23])
ardunio_a2: J1.3, U4.62 (mprj_io[24])
ardunio_a3: J1.4, U4.2 (mprj_io[25])
ardunio_a4: J1.5, J10.9, U4.3 (mprj_io[26])
ardunio_a5: J1.6, J10.10, U4.4 (mprj_io[27])
ardunio_d0: D6.1 (K), J9.1, R20.2, U4.37 (mprj_io[6]_ser_tx)
ardunio_d1: D5.1 (K), J9.2, R26.2, U4.41 (mprj_io[7])
ardunio_d2: D3.1 (K), J9.3, U4.42 (mprj_io[8])
ardunio_d3: D1.1 (K), J9.4, U4.43 (mprj_io[9]); also elsewhere on the board
ardunio_d4: J9.5, U4.44 (mprj_io[10])
ardunio_d5: J9.6, U4.48 (mprj_io[13])
ardunio_d6: J9.7, U4.50 (mprj_io[14])
ardunio_d7: J9.8, U4.51 (mprj_io[15])
ardunio_d8: J10.1, U4.53 (mprj_io[16])
ardunio_d9: J10.2, U4.54 (mprj_io[17])
ardunio_d10: J10.3, U4.55 (mprj_io[18])
ardunio_d11: J10.4, U4.58 (mprj_io[20])
ardunio_d12: J10.5, U4.57 (mprj_io[19])
ardunio_d13: J10.6, U4.59 (mprj_io[21])
gpio: D4.1 (K), U4.28 (gpio)
mprj_io_0: U4.31 (mprj_io[0]_JTAG)
mprj_io_5_ser_rx: J3.1, U4.36 (mprj_io[5]_ser_rx)
mprj_io_11: J3.3, U4.45 (mprj_io[11])
mprj_io_12: J3.2, U4.46 (mprj_io[12])
mprj_io_30: J10.8, U4.7 (mprj_io[30])
mprj_io_32: U4.11 (mprj_io[32])
mprj_io_37: J3.8, U4.16 (mprj_io[37])
xclk: U4.22 (clock), X1.3 (OUT)
~MR: C15.1, R11.1, R12.2, R13.2, SW1.2, U1.3 (~MR)
~RST: R11.2, U1.2 (~RESET), U4.21 (resetb)

Notes on the sheet:
MEM OScillator
5V to 3.3V Voltage Converter
LED SECTION
Riscduino to ardunio Pin Mapping
Micro USB
arduino_d11 and arduino_d12 connectivty to swapped to fix SOC Bug
USER SRAM MEMORY I/F
DEBUG PORTS
Caravel Programming ISP
USER FLASH MEMORY I/F
5V to 1.8V Voltage Converter
Reset Circuit
CARAVEL FLASH MEMORY I/F
USB or External 5V Selection USB Power - Short Pin-2 & Pin3 External Power: Connect 5V - Pin2 and Gnd - Pin1

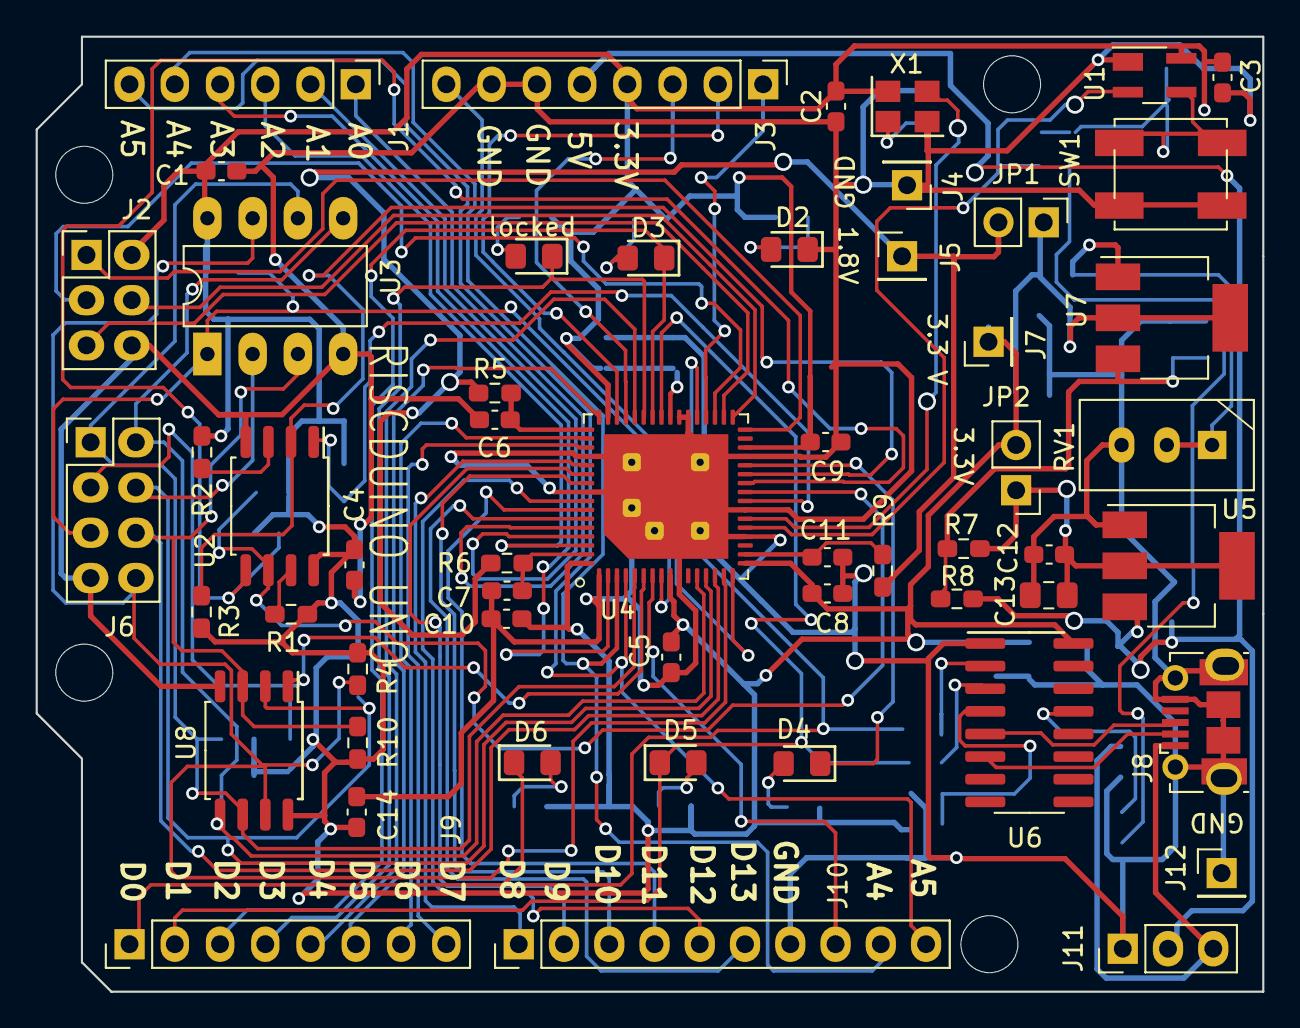
[picture p17: board Riscduino_Uno.kicad_pcb from above]

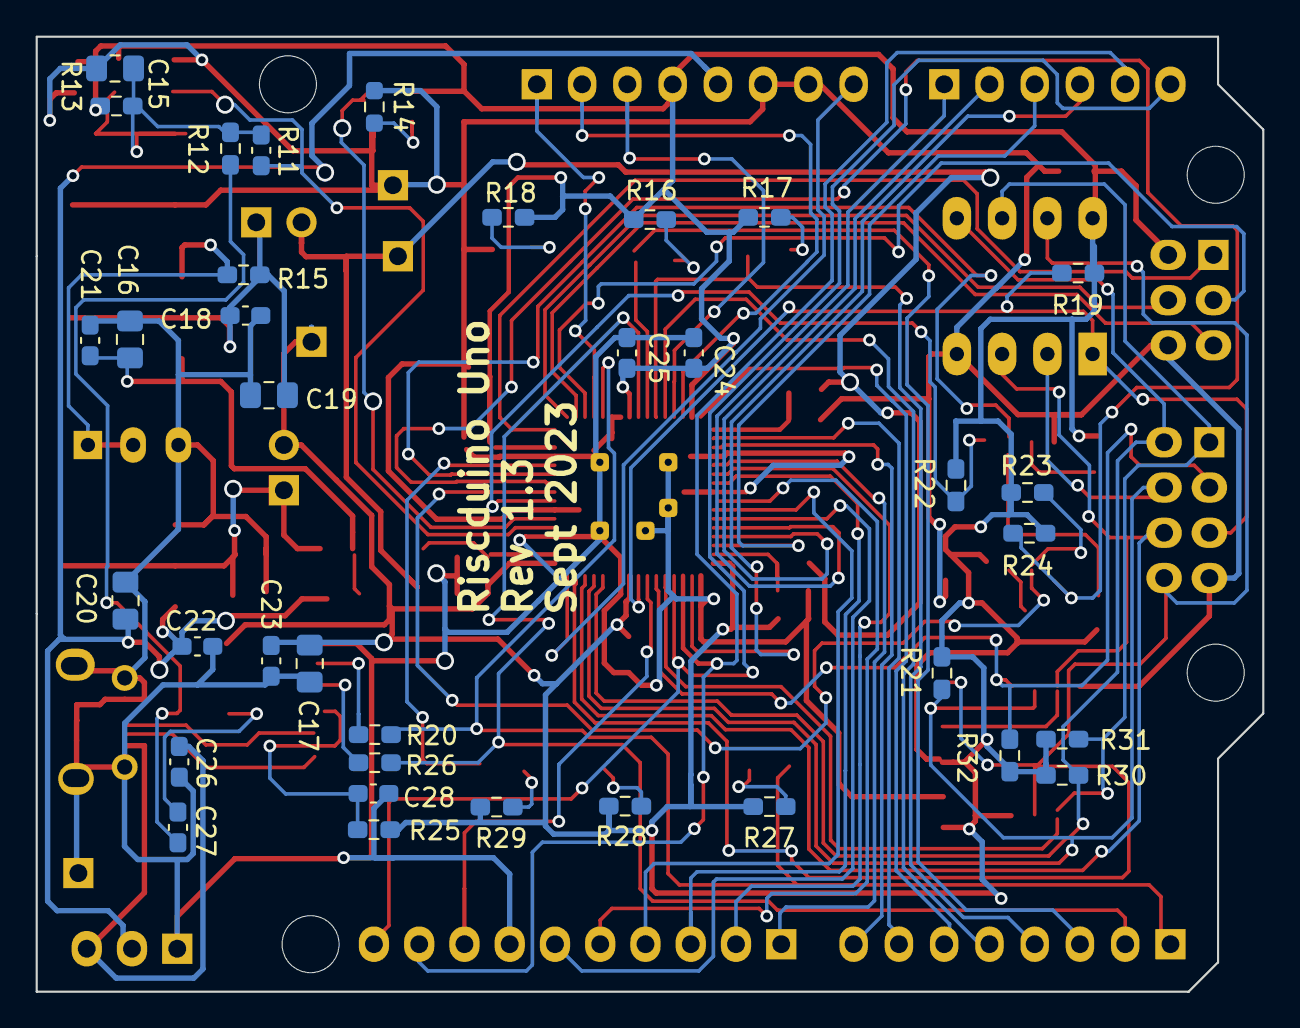
[picture p18: board Riscduino_Uno.kicad_pcb from below]

Board: 2 copper layers, 68.8 x 53.6 mm, 92 parts (36 on the bottom side), 72 nets.

Other parts of the board:
locked: GREEN LED; LED_0805_2012Metric_Pad1.15x1.40mm_HandSolder

Their connections:
unnamed 21: locked.2 (A); also elsewhere on the board
ardunio_d3: locked.1 (K); also elsewhere on the board
