dineshannayya/riscduino_board/KiCad_PCB/Riscduino_Debug_Rev1.1/Riscduino_Debug.kicad_pcb

## KiCad design KiCad_PCB/Riscduino_Debug_Rev1.1/Riscduino_Debug.kicad_pcb (2023-08-05, an earlier design)

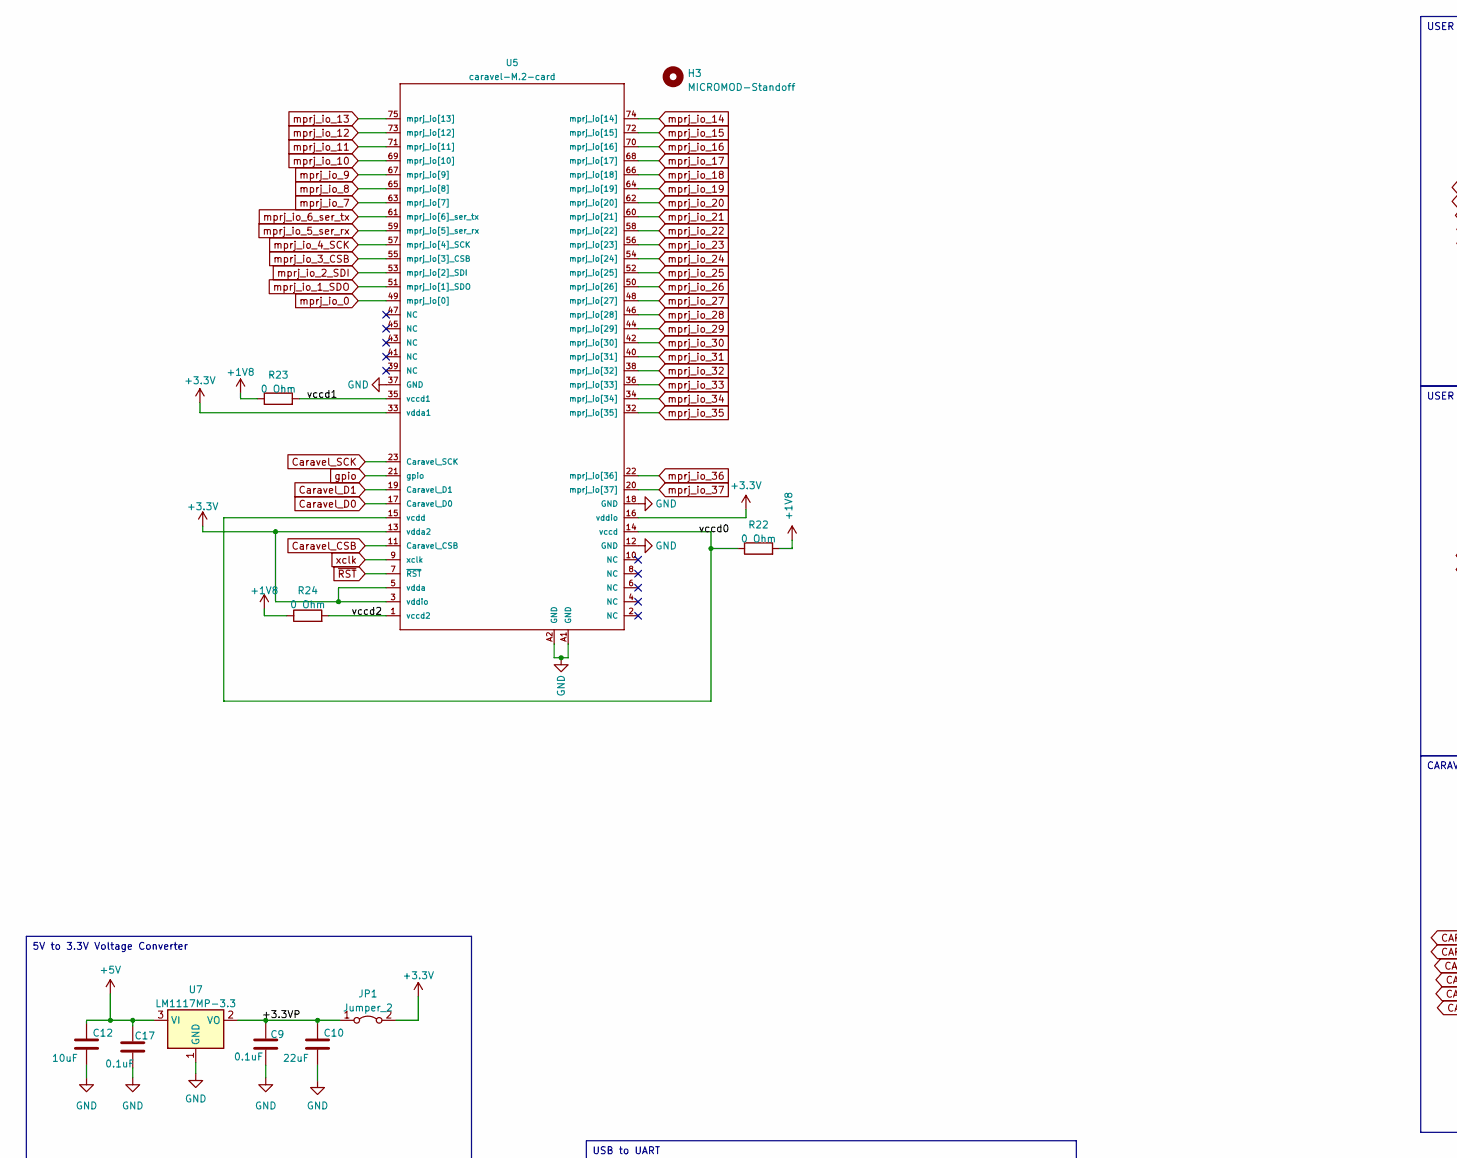
[picture p19: schematic Riscduino_Debug.kicad_sch, part in row 1, column 1]

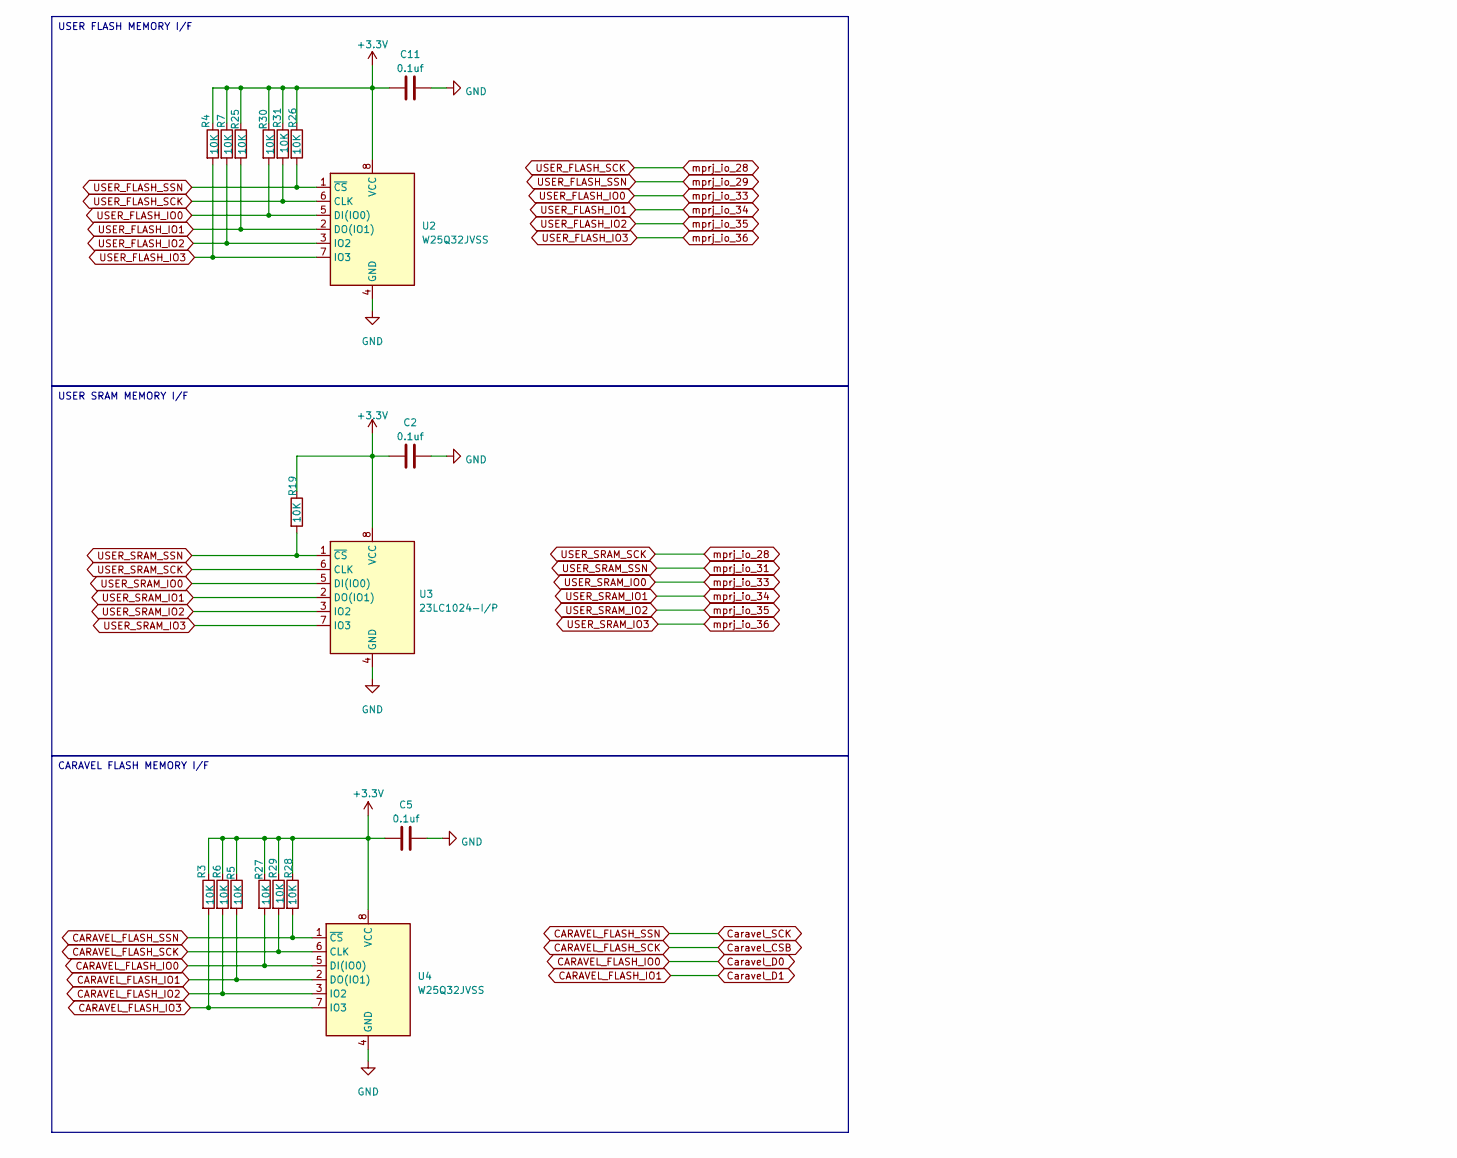
[picture p20: schematic Riscduino_Debug.kicad_sch, part in row 1, column 2]

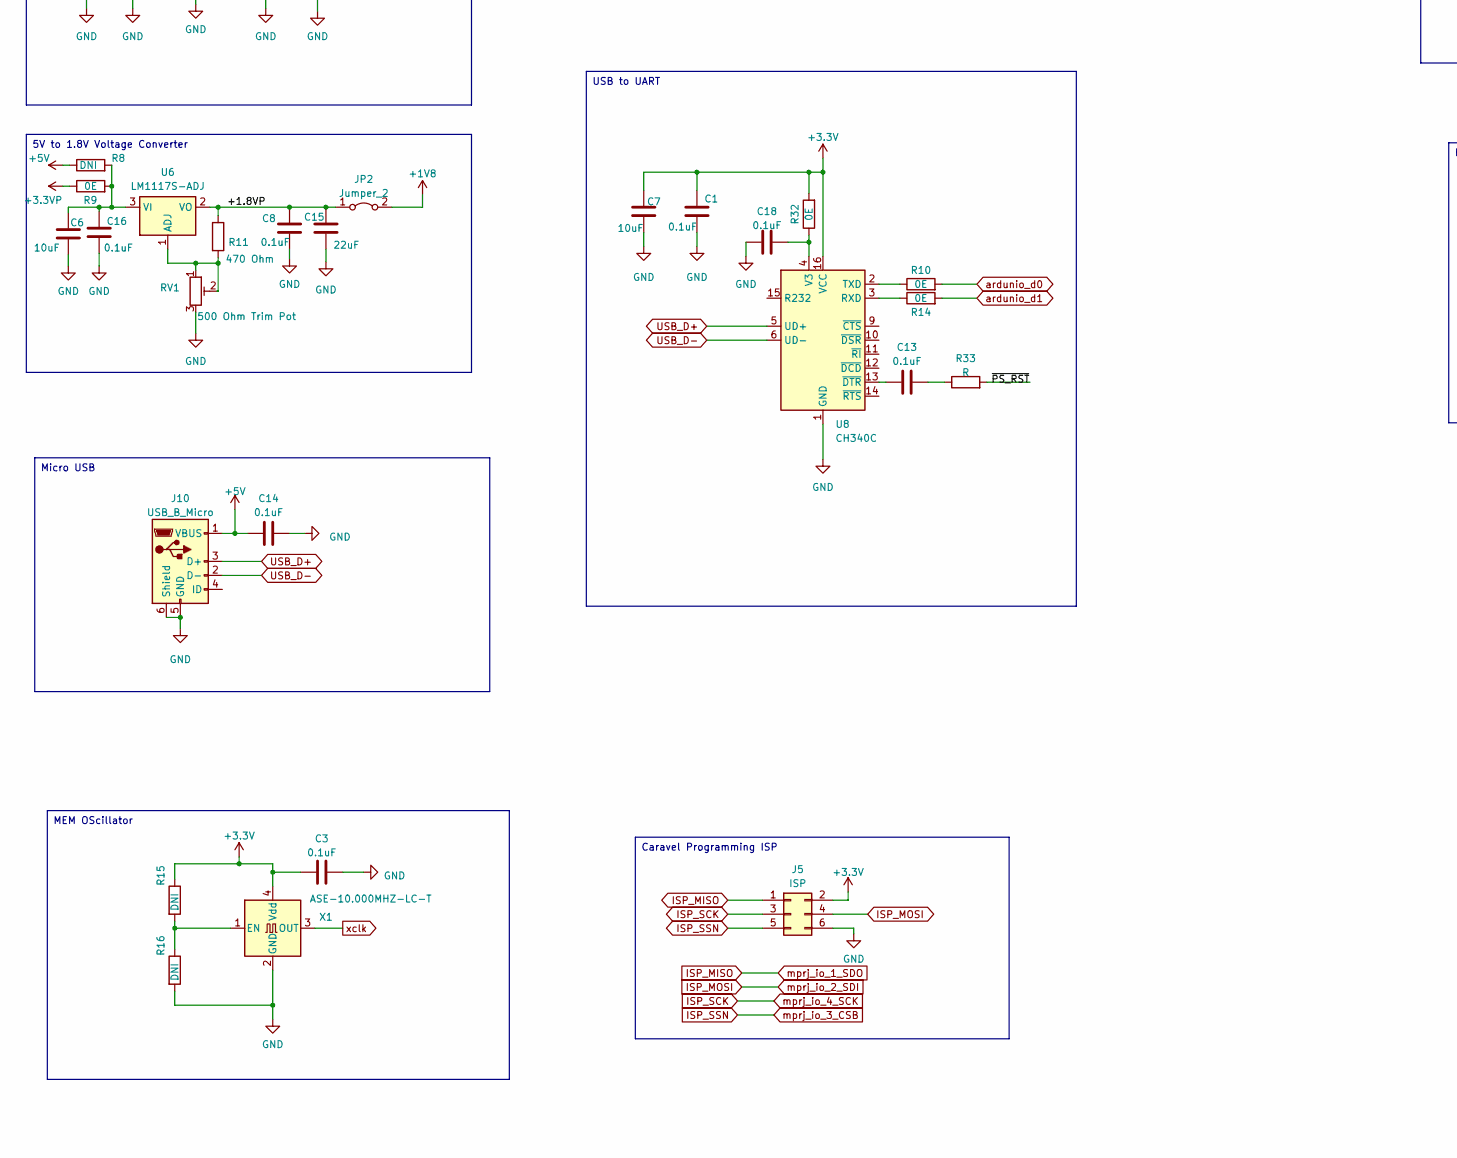
[picture p21: schematic Riscduino_Debug.kicad_sch, part in row 2, column 1]

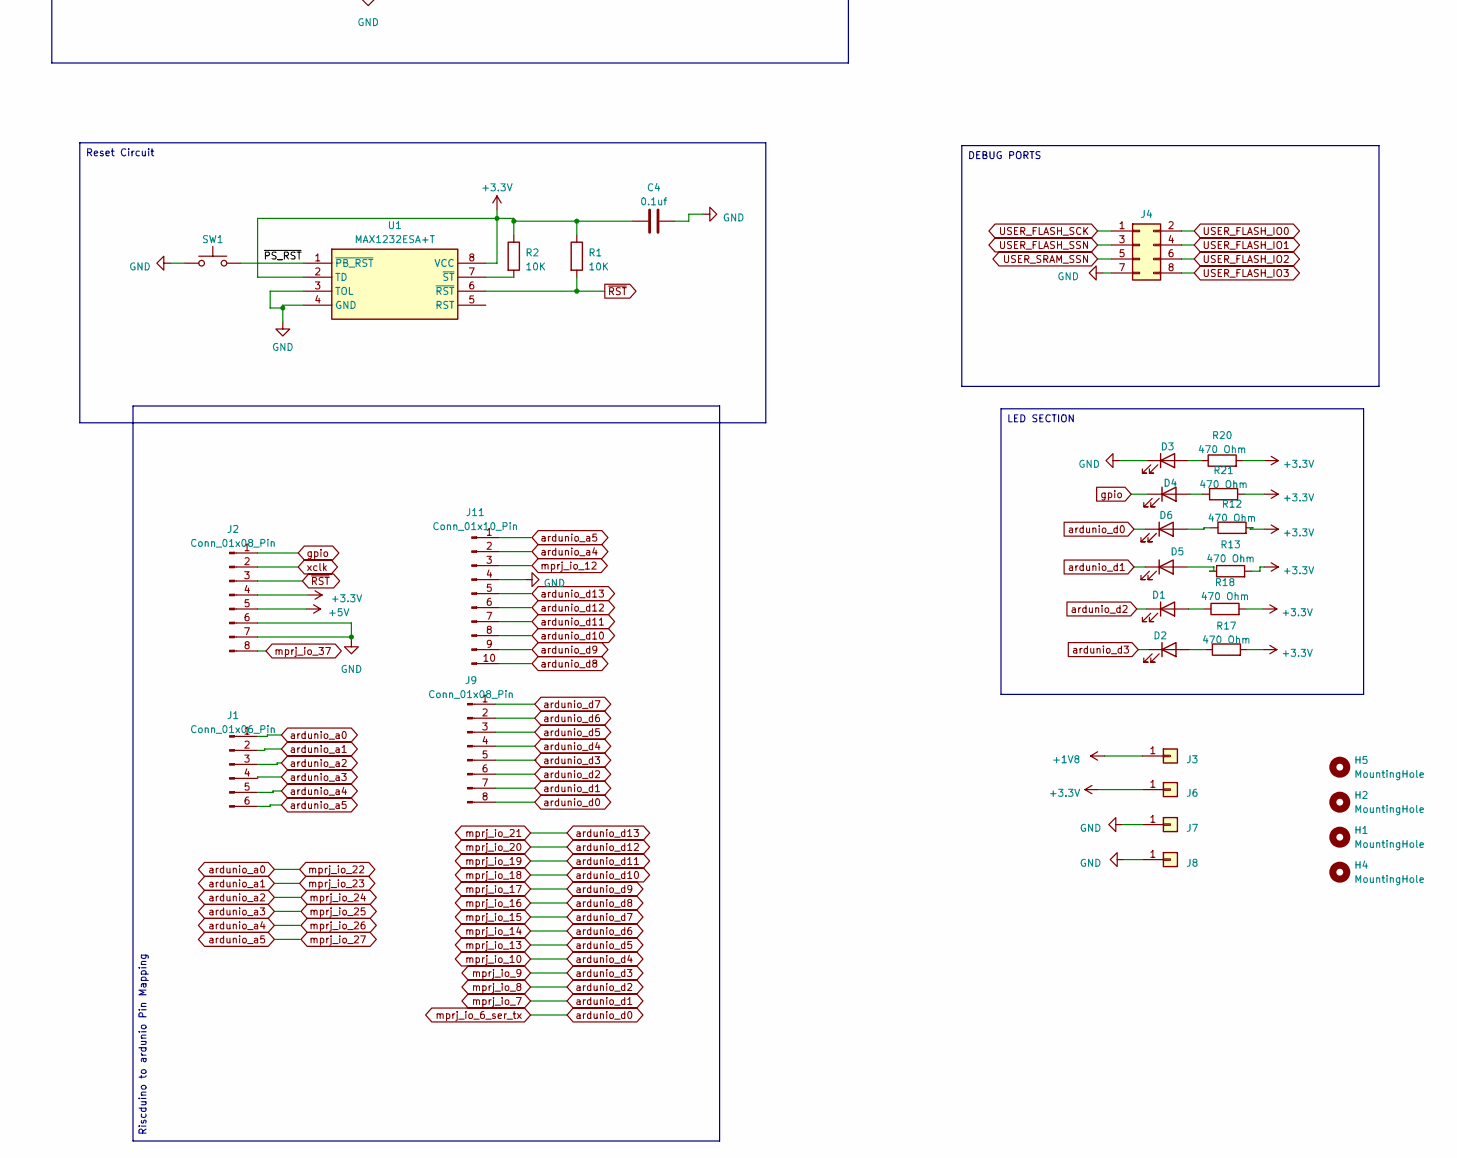
[picture p22: schematic Riscduino_Debug.kicad_sch, part in row 2, column 2]

Parts:
C1, C3, C8, C9, C13, C14, C16, C17, C18: 0.1uF; C_0603_1608Metric_Pad1.08x0.95mm_HandSolder
C2, C4, C5, C11: 0.1uf; C_0603_1608Metric_Pad1.08x0.95mm_HandSolder
C6, C7, C12: 10uF; C_0805_2012Metric_Pad1.18x1.45mm_HandSolder
C10, C15: 22uF; C_0805_2012Metric_Pad1.18x1.45mm_HandSolder
D1, D2, D4, D5: GREEN LED; LED_0805_2012Metric_Pad1.15x1.40mm_HandSolder
D3: RED LED; LED_0805_2012Metric_Pad1.15x1.40mm_HandSolder
D6: BLUE LED; LED_0805_2012Metric_Pad1.15x1.40mm_HandSolder
H1, H2, H4, H5: MountingHole; MountingHole_3.2mm_M3
H3: MICROMOD-Standoff; MicroMod-Standoff
J1: Conn_01x06_Pin; PinHeader_1x06_P2.54mm_Vertical
J2, J9: Conn_01x08_Pin; PinHeader_1x08_P2.54mm_Vertical
J3, J6, J7, J8: Conn_01x01; PinHeader_1x01_P2.54mm_Vertical
J4: Conn_02x04_Odd_Even; PinHeader_2x04_P2.54mm_Vertical
J5: ISP; PinHeader_2x03_P2.54mm_Vertical
J10: USB_B_Micro; USB_Micro-B_Molex-105017-0001
J11: Conn_01x10_Pin; PinHeader_1x10_P2.54mm_Vertical
JP1, JP2: Jumper_2; PinHeader_1x02_P2.54mm_Vertical
R1, R2, R3, R4, R5, R6, R7, R19, R25, R26, R27, R28, R29, R30, R31: 10K; R_0603_1608Metric_Pad0.98x0.95mm_HandSolder
R8, R15, R16: DNI; R_0603_1608Metric_Pad0.98x0.95mm_HandSolder
R9, R10, R14, R32: 0E; R_0603_1608Metric_Pad0.98x0.95mm_HandSolder
R11, R12, R13, R17, R18, R20, R21: 470 Ohm; R_0603_1608Metric_Pad0.98x0.95mm_HandSolder
R22, R23, R24: 0 Ohm; R_0603_1608Metric_Pad0.98x0.95mm_HandSolder
R33: R; R_0603_1608Metric_Pad0.98x0.95mm_HandSolder
RV1: 500 Ohm Trim Pot; Potentiometer_Bourns_3296W_Vertical
SW1: 4Pin Round Button SPST Straight Tactile Switch SM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; SW_SPST_EVPBF_TS4550TP
U1: MAX1232ESA+T; SOIC-8-1EP_3.9x4.9mm_P1.27mm_EP2.29x3mm; Manufacturer_Part_Number MAX1232ESA+T; Mouser Part Number 700-MAX1232ESAT
U2, U4: W25Q32JVSS; SOIC-8_5.23x5.23mm_P1.27mm
U3: 23LC1024-I/P; DIP-8_W7.62mm_LongPads
U5: caravel-M.2-card; M.2-CONNECTOR-E
U6: LM1117S-ADJ; SOT-223-3_TabPin2
U7: LM1117MP-3.3; SOT-223-3_TabPin2
U8: CH340C; SOIC-16_3.9x9.9mm_P1.27mm
X1: ASE-10.000MHZ-LC-T; Crystal_SMD_Abracon_ABM8G-4Pin_3.2x2.5mm

Connections:
+1V8: J3.1, JP2.2 (B), R22.2, R23.1, R24.1
+3.3V: C1.1, C2.1, C3.1, C4.1, C5.1, C7.1, C11.1, J2.4, J5.2, J6.1, JP1.2 (B), R1.1, R2.1, R3.1, R4.1, R5.1, R6.1, R7.1, R12.2, R13.2, R15.1, R17.2, R18.2, R19.1, R20.2, R21.2, R25.1, R26.1, R27.1, R28.1, R29.1, R30.1, R31.1, R32.2, U1.2 (TD), U1.8 (VCC), U2.8 (VCC), U3.8 (VCC), U4.8 (VCC), U5.3 (vddio), U5.5 (vdda), U5.13 (vdda2), U5.16 (vddio), U5.33 (vdda1), U8.16 (VCC), X1.4 (Vdd)
+3.3VP: C9.1, C10.1, JP1.1 (A), R9.1, U7.2 (VO)
+5V: C12.1, C14.1, C17.1, J2.5, J10.1 (VBUS), R8.1, U7.3 (VI)
/+1.8VP: C8.1, C15.1, JP2.1 (A), R11.1, U6.2 (VO)
CARAVEL_FLASH_IO0: R27.2, U4.5 (DI(IO0)), U5.17 (Caravel_D0)
CARAVEL_FLASH_IO1: R5.2, U4.2 (DO(IO1)), U5.19 (Caravel_D1)
CARAVEL_FLASH_IO2: R6.2, U4.3 (IO2)
CARAVEL_FLASH_IO3: R3.2, U4.7 (IO3)
CARAVEL_FLASH_SCK: R29.2, U4.6 (CLK), U5.11 (Caravel_CSB)
CARAVEL_FLASH_SSN: R28.2, U4.1 (~CS), U5.23 (Caravel_SCK)
GND: C1.2, C2.2, C3.2, C4.2, C5.2, C6.2, C7.2, C8.2, C9.2, C10.2, C11.2, C12.2, C14.2, C15.2, C16.2, C17.2, C18.1, D3.1 (K), J2.6, J2.7, J4.7, J5.6, J7.1, J8.1, J10.5 (GND), J10.6 (Shield), J11.4, R16.2, RV1.3, SW1.1, U1.3 (TOL), U1.4 (GND), U2.4 (GND), U3.4 (GND), U4.4 (GND), U5.12 (GND), U5.18 (GND), U5.37 (GND), U5.A1 (GND), U5.A2 (GND), U7.1 (GND), U8.1 (GND), X1.2 (GND)
ISP_MISO: J5.1, U5.51 (mprj_io[1]_SDO)
ISP_MOSI: J5.4, U5.53 (mprj_io[2]_SDI)
ISP_SCK: J5.3, U5.57 (mprj_io[4]_SCK)
ISP_SSN: J5.5, U5.55 (mprj_io[3]_CSB)
unnamed: C13.2, R33.1
unnamed: D1.2 (A), R18.1
unnamed 18: D2.2 (A), R17.1; also elsewhere on the board
unnamed: D3.2 (A), R20.1
unnamed: D4.2 (A), R21.1
unnamed: D5.2 (A), R13.1
unnamed: D6.2 (A), R12.1
unnamed: SW1.2, U1.1 (~PB_RST)
unnamed: R2.2, U1.7 (~ST)
unnamed: R23.2, U5.35 (vccd1)
unnamed: R24.2, U5.1 (vccd2)
unnamed: R22.1, U5.14 (vccd), U5.15 (vcdd)
unnamed: R11.2, RV1.1, RV1.2, U6.1 (ADJ)
unnamed: C6.1, C16.1, R8.2, R9.2, U6.3 (VI)
unnamed: R14.1, U8.3 (RXD)
unnamed: R10.1, U8.2 (TXD)
unnamed: C18.2, R32.1, U8.4 (V3)
unnamed: C13.1, U8.13 (~DTR)
unnamed: R15.2, R16.1, X1.1 (EN)
USB_D+: J10.3 (D+), U8.5 (UD+)
USB_D-: J10.2 (D-), U8.6 (UD-)
USER_FLASH_IO0: J4.2, R30.2, U2.5 (DI(IO0)), U3.5 (DI(IO0)), U5.36 (mprj_io[33])
USER_FLASH_IO1: J4.4, R25.2, U2.2 (DO(IO1)), U3.2 (DO(IO1)), U5.34 (mprj_io[34])
USER_FLASH_IO2: J4.6, R7.2, U2.3 (IO2), U3.3 (IO2), U5.32 (mprj_io[35])
USER_FLASH_IO3: J4.8, R4.2, U2.7 (IO3), U3.7 (IO3), U5.22 (mprj_io[36])
USER_FLASH_SCK: J4.1, R31.2, U2.6 (CLK), U3.6 (CLK), U5.46 (mprj_io[28])
USER_FLASH_SSN: J4.3, R26.2, U2.1 (~CS), U5.44 (mprj_io[29])
USER_SRAM_SSN: J4.5, R19.2, U3.1 (~CS), U5.40 (mprj_io[31])
ardunio_a0: J1.1, U5.58 (mprj_io[22])
ardunio_a1: J1.2, U5.56 (mprj_io[23])
ardunio_a2: J1.3, U5.54 (mprj_io[24])
ardunio_a3: J1.4, U5.52 (mprj_io[25])
ardunio_a4: J1.5, J11.2, U5.50 (mprj_io[26])
ardunio_a5: J1.6, J11.1, U5.48 (mprj_io[27])
ardunio_d0: D6.1 (K), J9.8, R10.2, U5.61 (mprj_io[6]_ser_tx)
ardunio_d1: D5.1 (K), J9.7, R14.2, U5.63 (mprj_io[7])
ardunio_d2: D1.1 (K), J9.6, U5.65 (mprj_io[8])
ardunio_d3: D2.1 (K), J9.5, U5.67 (mprj_io[9]), U8.67; also elsewhere on the board
ardunio_d4: J9.4, U5.69 (mprj_io[10])
ardunio_d5: J9.3, U5.75 (mprj_io[13])
ardunio_d6: J9.2, U5.74 (mprj_io[14])
ardunio_d7: J9.1, U5.72 (mprj_io[15])
ardunio_d8: J11.10, U5.70 (mprj_io[16])
ardunio_d9: J11.9, U5.68 (mprj_io[17])
ardunio_d10: J11.8, U5.66 (mprj_io[18])
ardunio_d11: J11.7, U5.64 (mprj_io[19])
ardunio_d12: J11.6, U5.62 (mprj_io[20])
ardunio_d13: J11.5, U5.60 (mprj_io[21])
gpio: D4.1 (K), J2.1, U5.21 (gpio)
mprj_io_0: U5.49 (mprj_io[0])
mprj_io_5_ser_rx: U5.59 (mprj_io[5]_ser_rx)
mprj_io_11: U5.71 (mprj_io[11])
mprj_io_12: J11.3, U5.73 (mprj_io[12])
mprj_io_30: U5.42 (mprj_io[30])
mprj_io_32: U5.38 (mprj_io[32])
mprj_io_37: J2.8, U5.20 (mprj_io[37])
xclk: J2.2, U5.9 (xclk), X1.3 (OUT)
~RST: J2.3, R1.2, U1.6 (~RST), U5.7 (~RST)

Notes on the sheet:
MEM OScillator
5V to 3.3V Voltage Converter
LED SECTION
Riscduino to ardunio Pin Mapping
Micro USB
USB to UART
USER SRAM MEMORY I/F
DEBUG PORTS
Caravel Programming ISP
USER FLASH MEMORY I/F
5V to 1.8V Voltage Converter
Reset Circuit
CARAVEL FLASH MEMORY I/F

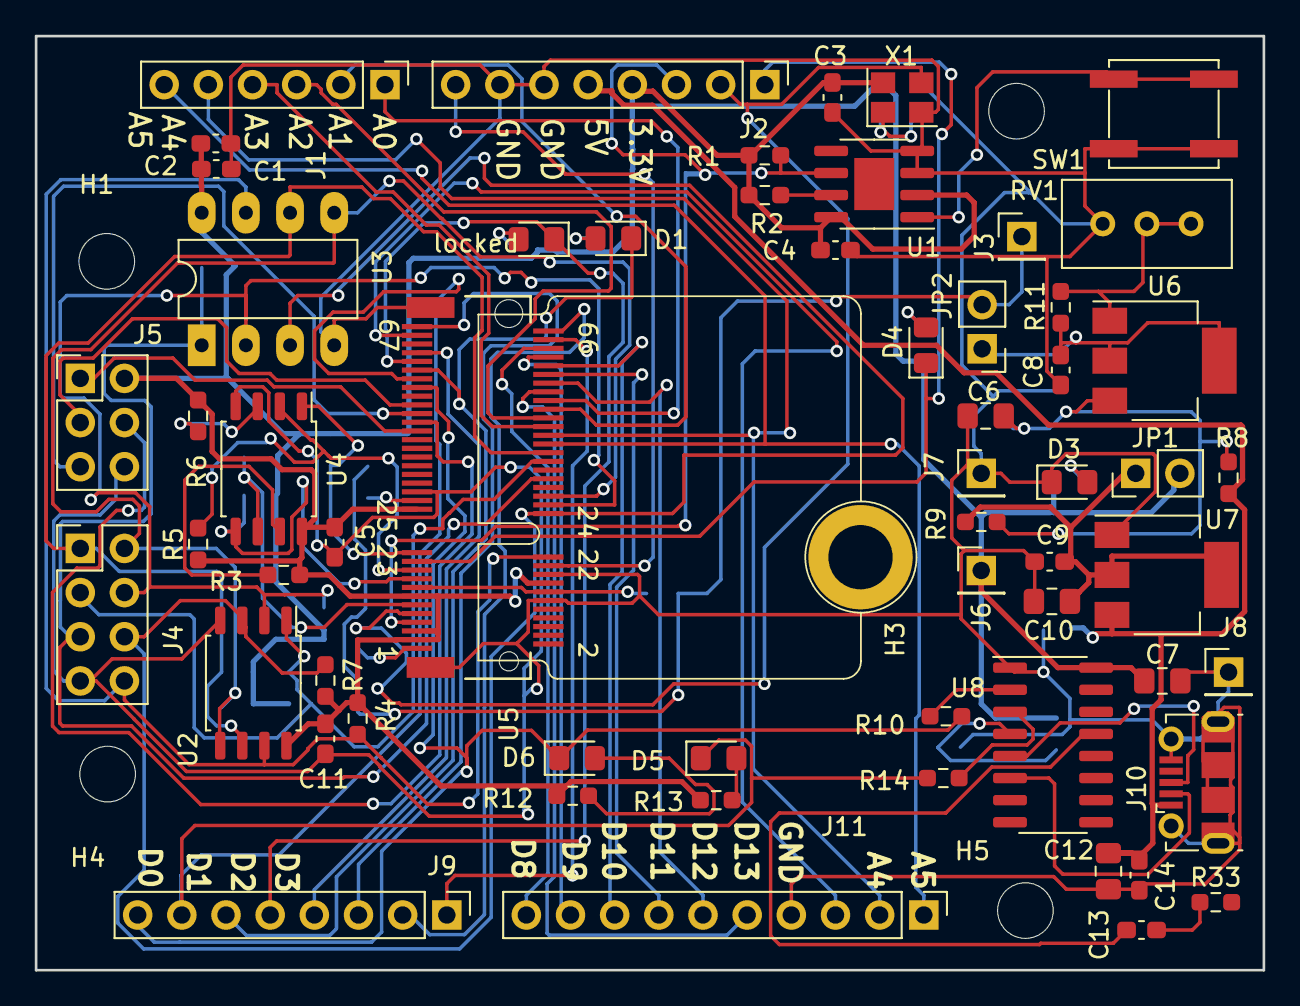
[picture p23: board Riscduino_Debug.kicad_pcb from above]

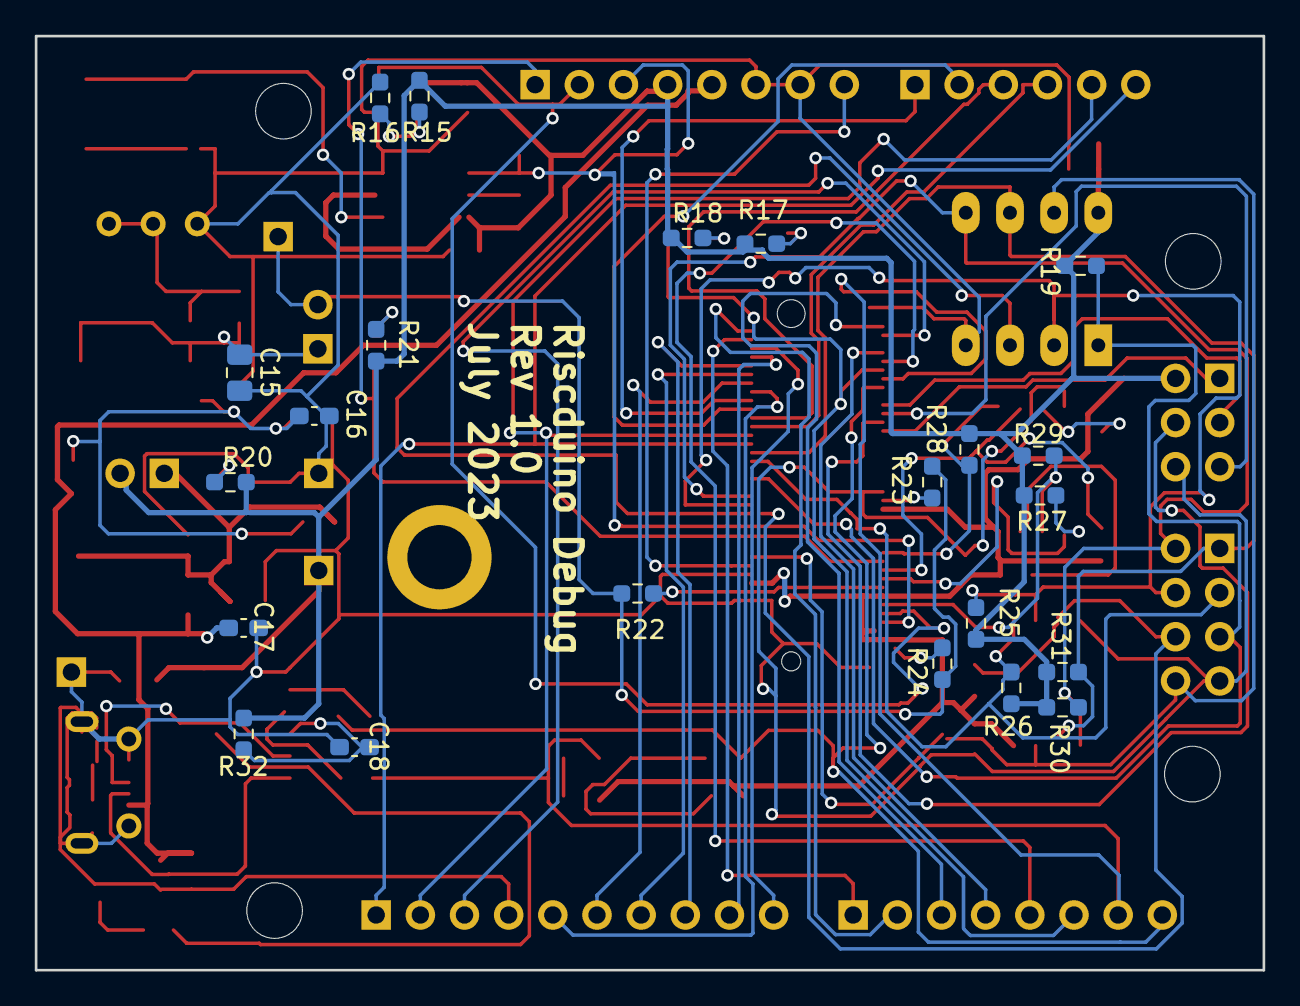
[picture p24: board Riscduino_Debug.kicad_pcb from below]

Board: 2 copper layers, 70.6 x 53.7 mm, 86 parts (22 on the bottom side), 69 nets.

Other parts of the board:
locked: GREEN LED; LED_0805_2012Metric_Pad1.15x1.40mm_HandSolder

Their connections:
unnamed 18: locked.2 (A); also elsewhere on the board
ardunio_d3: locked.1 (K); also elsewhere on the board
