dineshannayya/riscduino_board/KiCad_PCB/Riscduino_ATMEGA_Adpater_Rev1.0/Riscduino_ATMEGA_Adpater_Rev1.0.kicad_pcb

## KiCad design KiCad_PCB/Riscduino_ATMEGA_Adpater_Rev1.0/Riscduino_ATMEGA_Adpater_Rev1.0.kicad_pcb (2023-07-30)

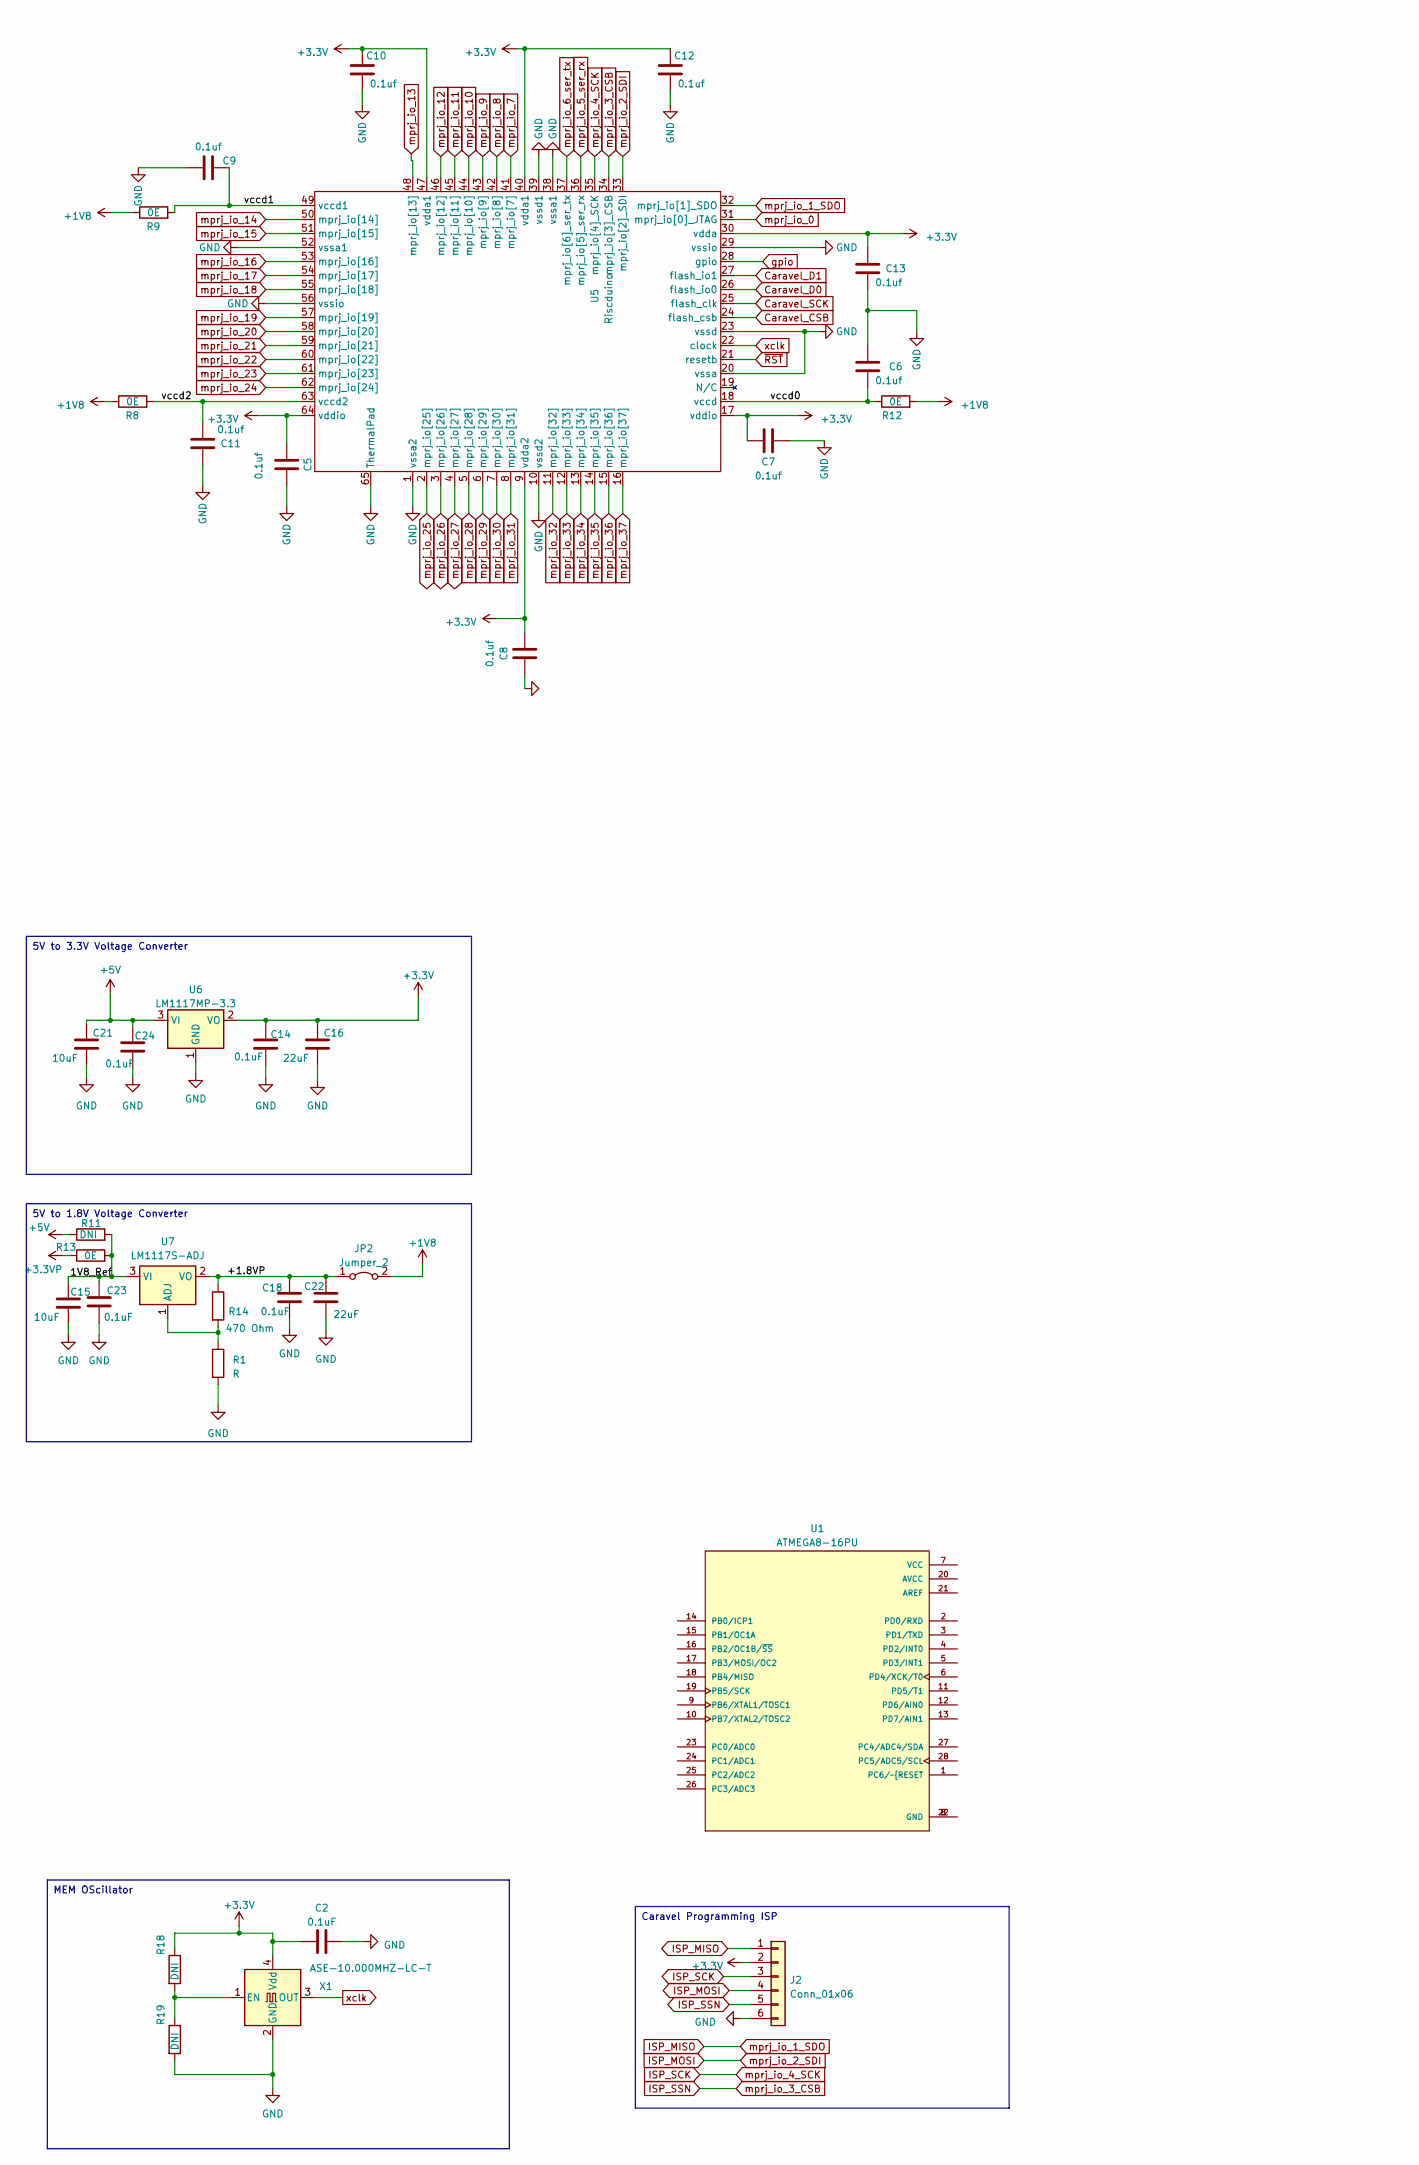
[picture p25: schematic Riscduino_ATMEGA_Adpater_Rev1.0.kicad_sch, part in row 1, column 1]

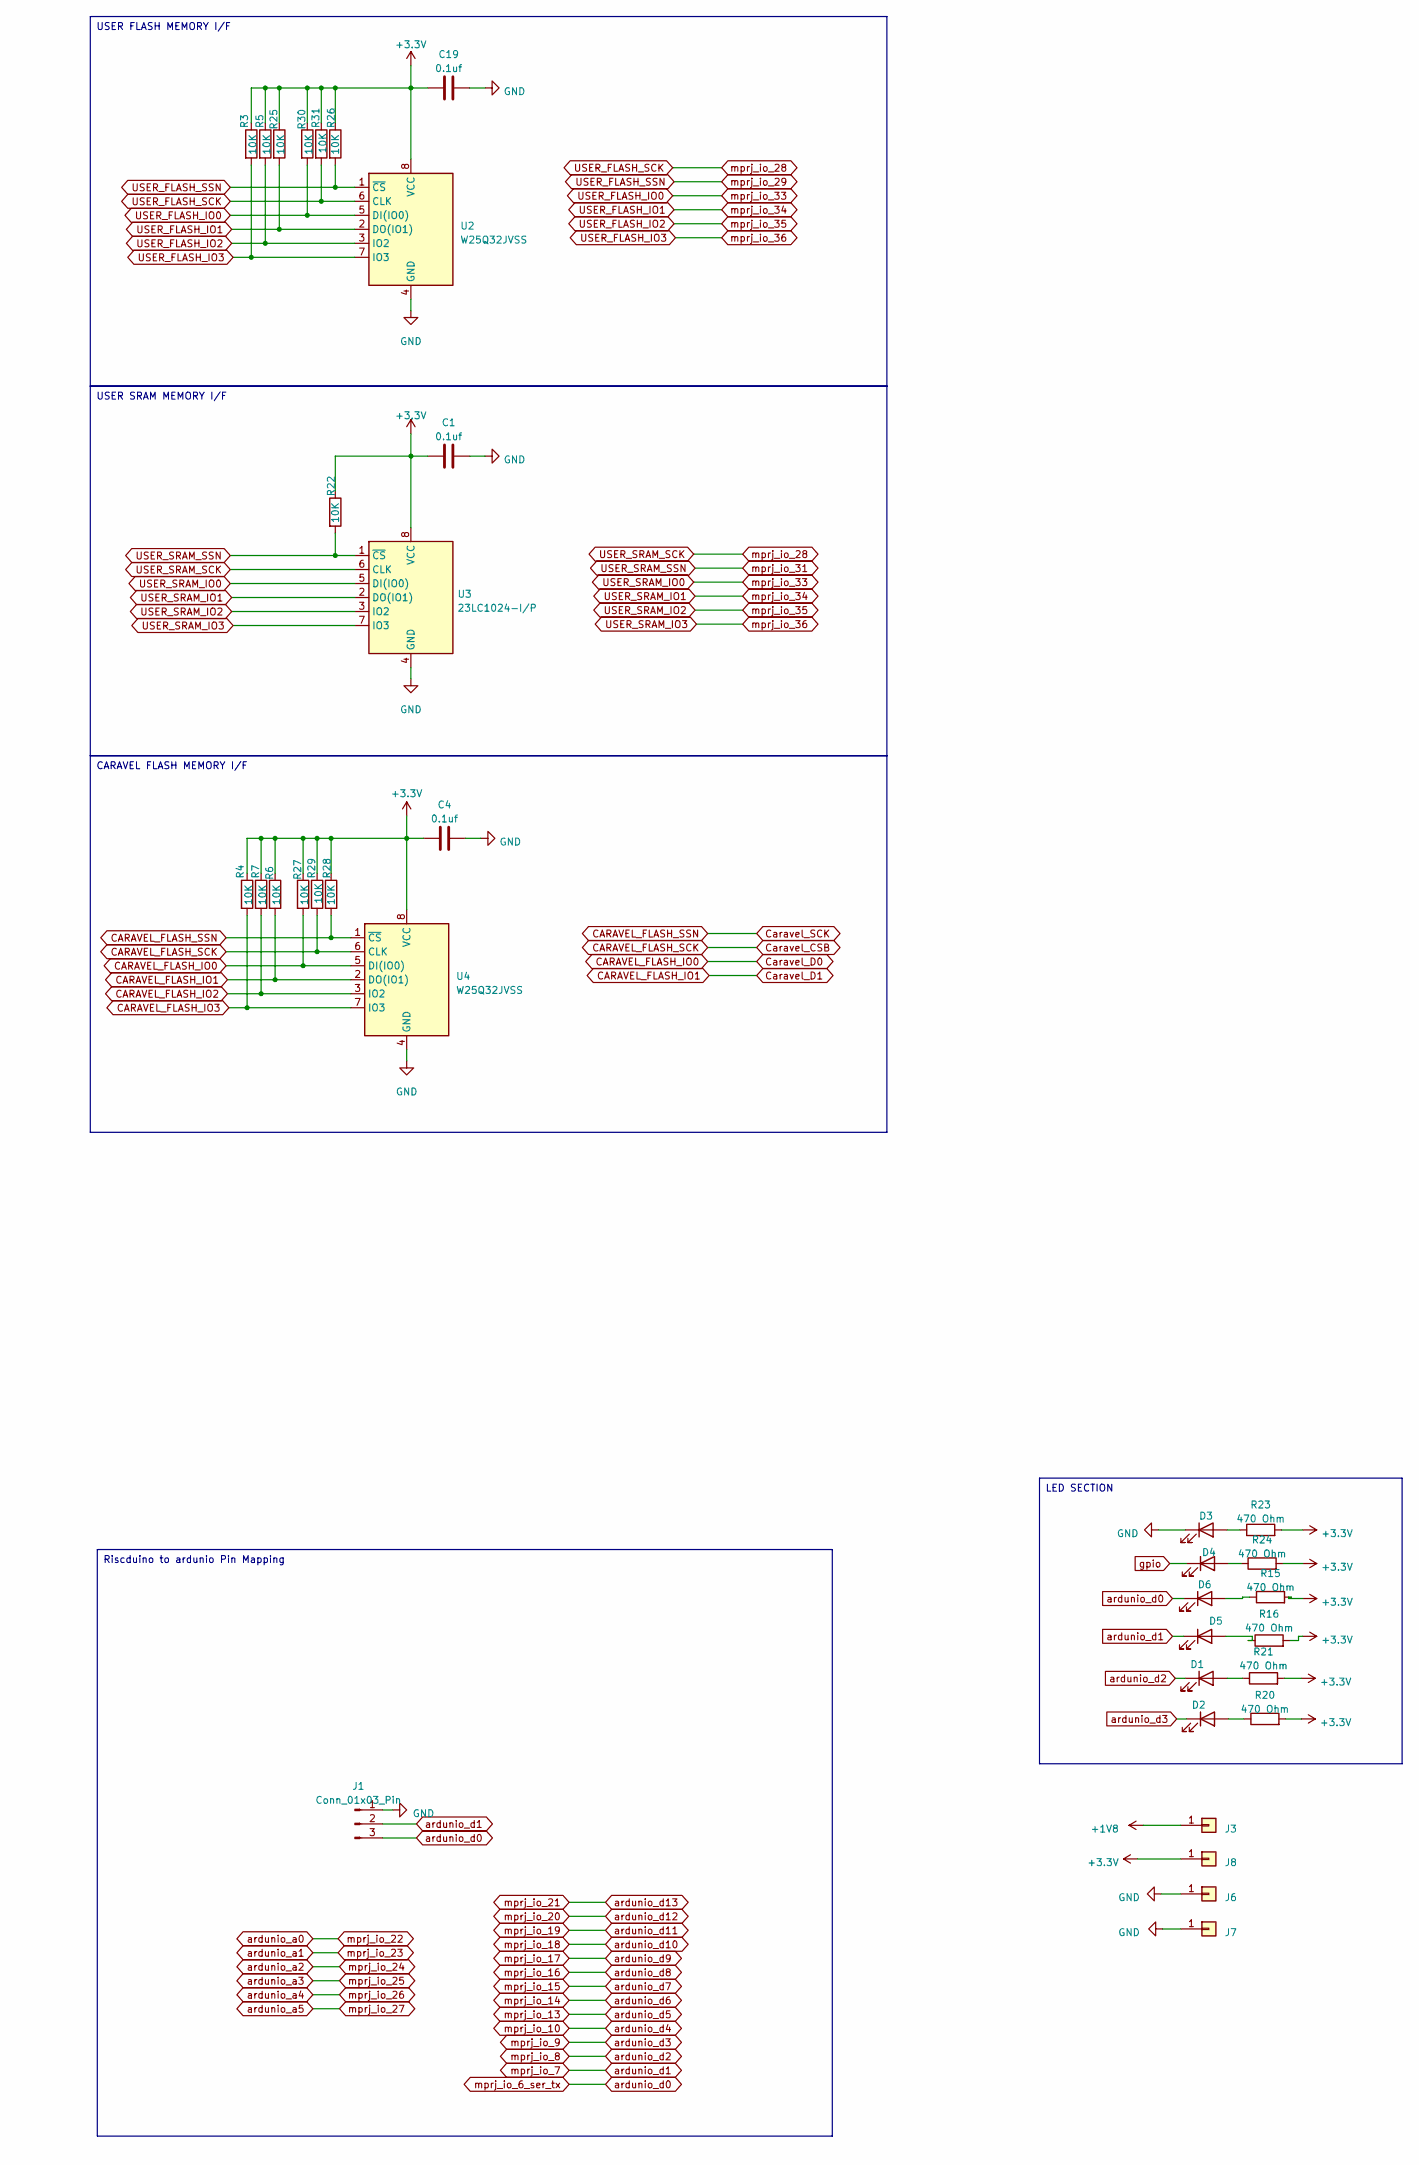
[picture p26: schematic Riscduino_ATMEGA_Adpater_Rev1.0.kicad_sch, part in row 1, column 2]

Parts:
C1, C4, C5, C6, C7, C8, C9, C10, C11, C12, C13, C19: 0.1uf; C_0603_1608Metric_Pad1.08x0.95mm_HandSolder
C2, C14, C18, C23, C24: 0.1uF; C_0603_1608Metric_Pad1.08x0.95mm_HandSolder
C15, C21: 10uF; C_0805_2012Metric_Pad1.18x1.45mm_HandSolder
C16, C22: 22uF; C_0805_2012Metric_Pad1.18x1.45mm_HandSolder
D1, D2, D4, D5: GREEN LED; LED_0805_2012Metric_Pad1.15x1.40mm_HandSolder
D3: RED LED; LED_0805_2012Metric_Pad1.15x1.40mm_HandSolder
D6: BLUE LED; LED_0805_2012Metric_Pad1.15x1.40mm_HandSolder
J1: Conn_01x03_Pin; PinHeader_1x03_P2.54mm_Vertical
J2: Conn_01x06; PinHeader_1x06_P2.54mm_Vertical
J3, J6, J7, J8: Conn_01x01; PinHeader_1x01_P2.54mm_Vertical
JP2: Jumper_2; PinHeader_1x02_P2.54mm_Vertical
R1: R; R_1206_3216Metric_Pad1.30x1.75mm_HandSolder
R3, R4, R5, R6, R7, R22, R25, R26, R27, R28, R29, R30, R31: 10K; R_0603_1608Metric_Pad0.98x0.95mm_HandSolder
R8, R9, R12, R13: 0E; R_0603_1608Metric_Pad0.98x0.95mm_HandSolder
R11, R18, R19: DNI; R_0603_1608Metric_Pad0.98x0.95mm_HandSolder
R14: 470 Ohm; R_1206_3216Metric_Pad1.30x1.75mm_HandSolder
R15, R16, R20, R21, R23, R24: 470 Ohm; R_0603_1608Metric_Pad0.98x0.95mm_HandSolder
U1: ATMEGA8-16PU; ATMEG8_28Pin_Jumper; PARTREV 2486R- 07/07
U2, U4: W25Q32JVSS; SOIC-8_5.23x5.23mm_P1.27mm
U3: 23LC1024-I/P; DIP-8_W7.62mm_LongPads
U5: Riscduino; RISCDUINO_QFN-64-1EP_9x9mm_P0.5mm_EP7.65x7.65mm_Ver1.1
U6: LM1117MP-3.3; SOT-223-3_TabPin2
U7: LM1117S-ADJ; SOT-223-3_TabPin2
X1: ASE-10.000MHZ-LC-T; Crystal_SMD_Abracon_ABM8G-4Pin_3.2x2.5mm

Connections:
+1V8: J3.1, JP2.2 (B), R8.1, R9.1, R12.2
+5V: C21.1, C24.1, R11.1, U6.3 (VI)
/+1.8VP: C18.1, C22.1, JP2.1 (A), R14.1, U7.2 (VO)
/vccd0: C6.2, R12.1, U5.18 (vccd)
/vccd1: C9.2, R9.2, U5.49 (vccd1)
/vccd2: C11.1, R8.2, U5.63 (vccd2)
CARAVEL_FLASH_IO0: R27.2, U4.5 (DI(IO0)), U5.26 (flash_io0)
CARAVEL_FLASH_IO1: R6.2, U4.2 (DO(IO1)), U5.27 (flash_io1)
CARAVEL_FLASH_IO2: R7.2, U4.3 (IO2)
CARAVEL_FLASH_IO3: R4.2, U4.7 (IO3)
CARAVEL_FLASH_SCK: R29.2, U4.6 (CLK), U5.24 (flash_csb)
CARAVEL_FLASH_SSN: R28.2, U4.1 (~CS), U5.25 (flash_clk)
GND: C1.2, C2.2, C4.2, C5.1, C6.1, C7.1, C8.1, C9.1, C10.2, C11.2, C12.2, C13.2, C14.2, C15.2, C16.2, C18.2, C19.2, C21.2, C22.2, C23.2, C24.2, D3.1 (K), J1.1, J2.6, J6.1, J7.1, R1.2, R19.2, U2.4 (GND), U3.4 (GND), U4.4 (GND), U5.1 (vssa2), U5.10 (vssd2), U5.20 (vssa), U5.23 (vssd), U5.29 (vssio), U5.38 (vssa1), U5.39 (vssd1), U5.52 (vssa1), U5.56 (vssio), U5.65 (ThermalPad), U6.1 (GND), X1.2 (GND)
ISP_MISO: J2.1, U5.32 (mprj_io[1]_SDO)
ISP_MOSI: J2.4, U5.33 (mprj_io[2]_SDI)
ISP_SCK: J2.3, U5.35 (mprj_io[4]_SCK)
ISP_SSN: J2.5, U5.34 (mprj_io[3]_CSB)
unnamed: D1.2 (A), R21.1
unnamed 18: D2.2 (A), R20.1; also elsewhere on the board
unnamed: D3.2 (A), R23.1
unnamed: D4.2 (A), R24.1
unnamed: D5.2 (A), R16.1
unnamed: D6.2 (A), R15.1
unnamed: U1.8 (GND), U1.22 (GND)
unnamed: R1.1, R14.2, U7.1 (ADJ)
unnamed: C15.1, C23.1, R11.2, R13.2, U7.3 (VI)
unnamed: R18.2, R19.1, X1.1 (EN)
USER_FLASH_IO0: R30.2, U2.5 (DI(IO0)), U3.5 (DI(IO0)), U5.12 (mprj_io[33])
USER_FLASH_IO1: R25.2, U2.2 (DO(IO1)), U3.2 (DO(IO1)), U5.13 (mprj_io[34])
USER_FLASH_IO2: R5.2, U2.3 (IO2), U3.3 (IO2), U5.14 (mprj_io[35])
USER_FLASH_IO3: R3.2, U2.7 (IO3), U3.7 (IO3), U5.15 (mprj_io[36])
USER_FLASH_SCK: R31.2, U2.6 (CLK), U3.6 (CLK), U5.5 (mprj_io[28])
USER_FLASH_SSN: R26.2, U2.1 (~CS), U5.6 (mprj_io[29])
USER_SRAM_SSN: R22.2, U3.1 (~CS), U5.8 (mprj_io[31])
ardunio_a0: U5.60 (mprj_io[22])
ardunio_a1: U5.61 (mprj_io[23])
ardunio_a2: U5.62 (mprj_io[24])
ardunio_a3: U5.2 (mprj_io[25])
ardunio_a4: U5.3 (mprj_io[26])
ardunio_a5: U5.4 (mprj_io[27])
ardunio_d0: D6.1 (K), J1.3, U5.37 (mprj_io[6]_ser_tx)
ardunio_d1: D5.1 (K), J1.2, U5.41 (mprj_io[7])
ardunio_d2: D1.1 (K), U5.42 (mprj_io[8])
ardunio_d3: D2.1 (K), U5.43 (mprj_io[9]); also elsewhere on the board
ardunio_d4: U5.44 (mprj_io[10])
ardunio_d5: U5.48 (mprj_io[13])
ardunio_d6: U5.50 (mprj_io[14])
ardunio_d7: U5.51 (mprj_io[15])
ardunio_d8: U5.53 (mprj_io[16])
ardunio_d9: U5.54 (mprj_io[17])
ardunio_d10: U5.55 (mprj_io[18])
ardunio_d11: U5.57 (mprj_io[19])
ardunio_d12: U5.58 (mprj_io[20])
ardunio_d13: U5.59 (mprj_io[21])
gpio: D4.1 (K), U5.28 (gpio)
mprj_io_0: U5.31 (mprj_io[0]_JTAG)
mprj_io_5_ser_rx: U5.36 (mprj_io[5]_ser_rx)
mprj_io_11: U5.45 (mprj_io[11])
mprj_io_12: U5.46 (mprj_io[12])
mprj_io_30: U5.7 (mprj_io[30])
mprj_io_32: U5.11 (mprj_io[32])
mprj_io_37: U5.16 (mprj_io[37])
xclk: U5.22 (clock), X1.3 (OUT)
~RST: U5.21 (resetb)

Notes on the sheet:
MEM OScillator
5V to 3.3V Voltage Converter
LED SECTION
Riscduino to ardunio Pin Mapping
USER SRAM MEMORY I/F
Caravel Programming ISP
USER FLASH MEMORY I/F
5V to 1.8V Voltage Converter
CARAVEL FLASH MEMORY I/F

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
Board: 2 copper layers, 71 parts (19 on the bottom side), 42 nets, no tracks yet.

Other parts of the board:
JP1: Jumper_2; PinHeader_1x02_P2.54mm_Vertical
locked: GREEN LED; LED_0805_2012Metric_Pad1.15x1.40mm_HandSolder

Their connections:
unnamed 18: locked.2 (A); also elsewhere on the board
ardunio_d3: locked.1 (K); also elsewhere on the board
