dineshannayya/riscduino_board/KiCad_PCB/Riscduino_Adpater_Rev1.0/Riscduino_Adpater_Rev1.0.kicad_pcb

## KiCad design KiCad_PCB/Riscduino_Adpater_Rev1.0/Riscduino_Adpater_Rev1.0.kicad_pcb (2023-07-27)

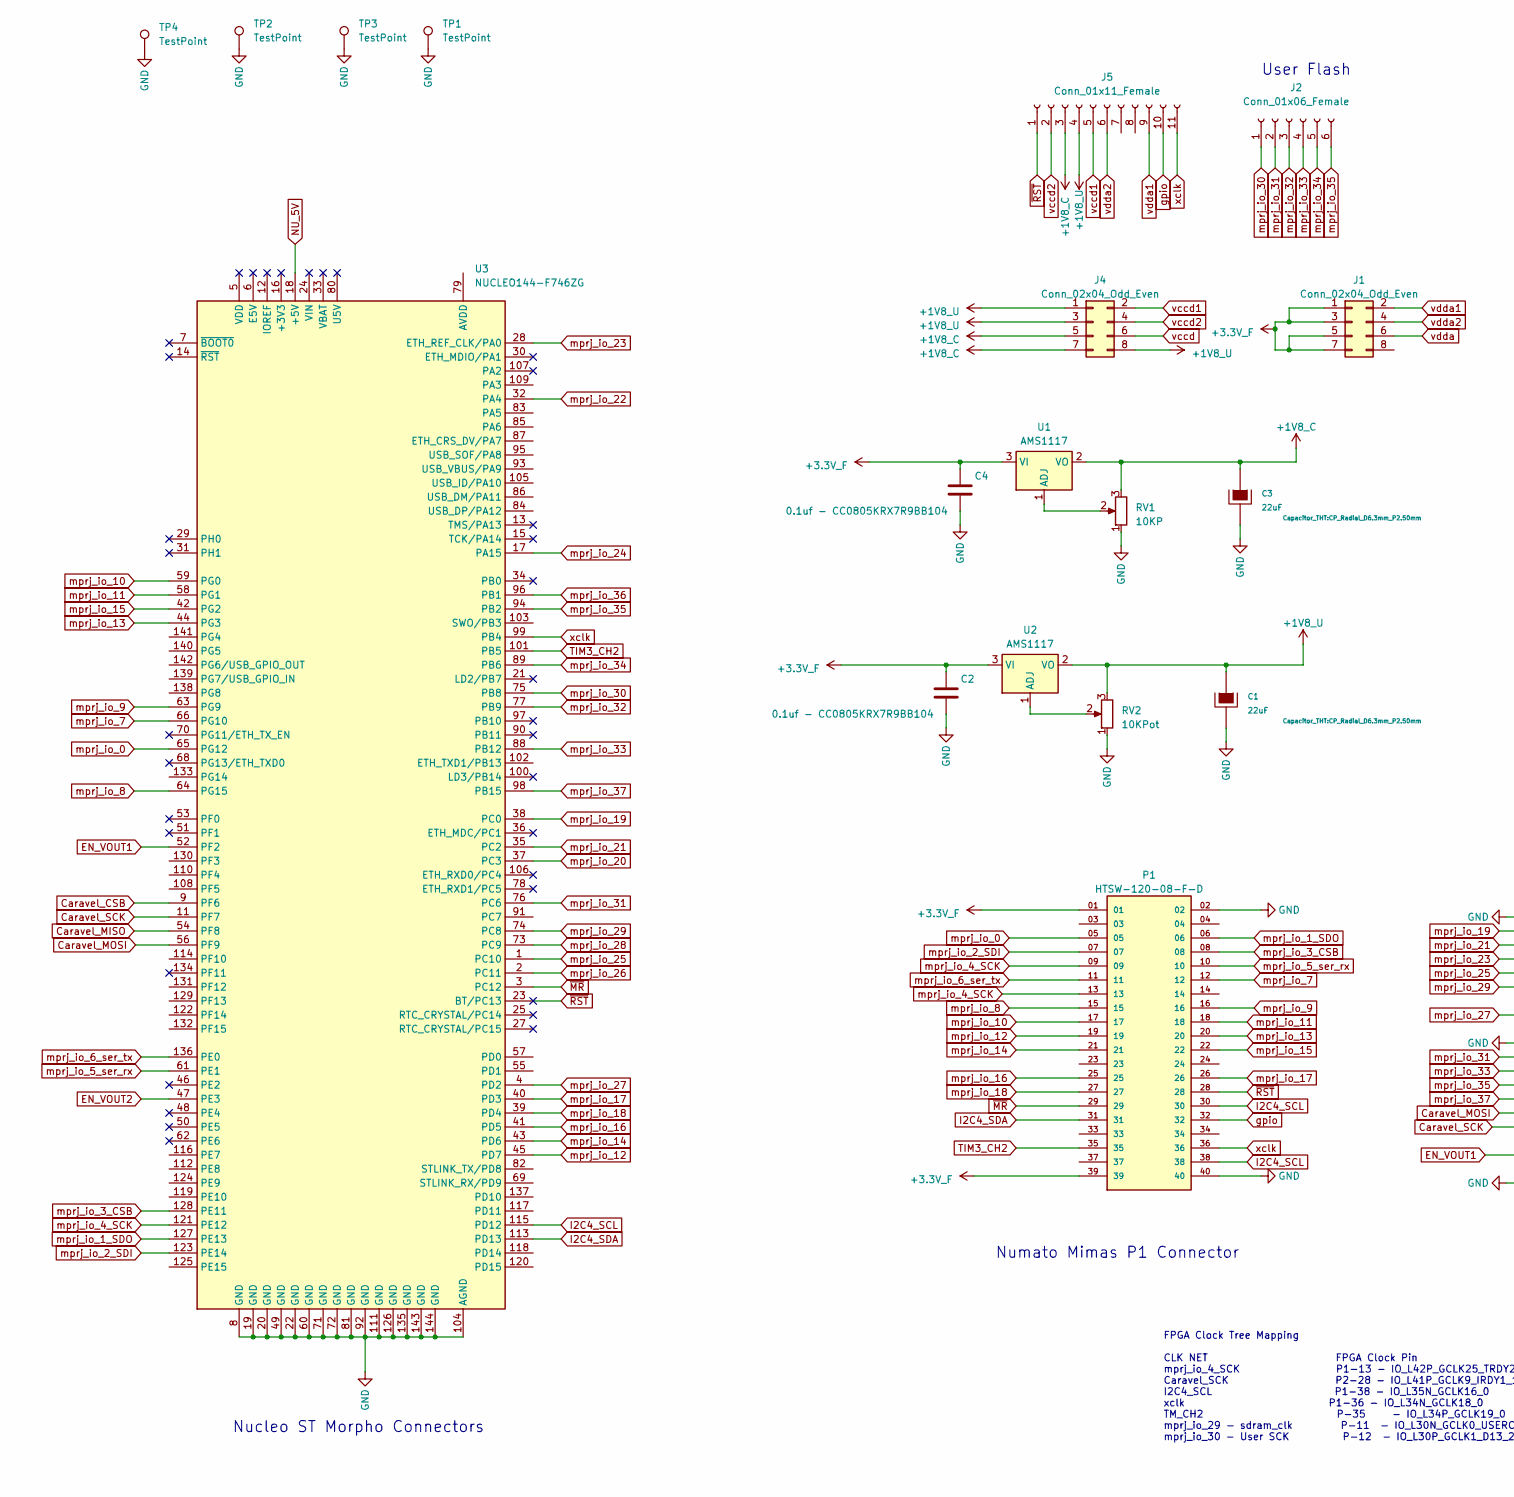
[picture p27: schematic Riscduino_Adpater_Rev1.0.kicad_sch, part in row 1, column 1]

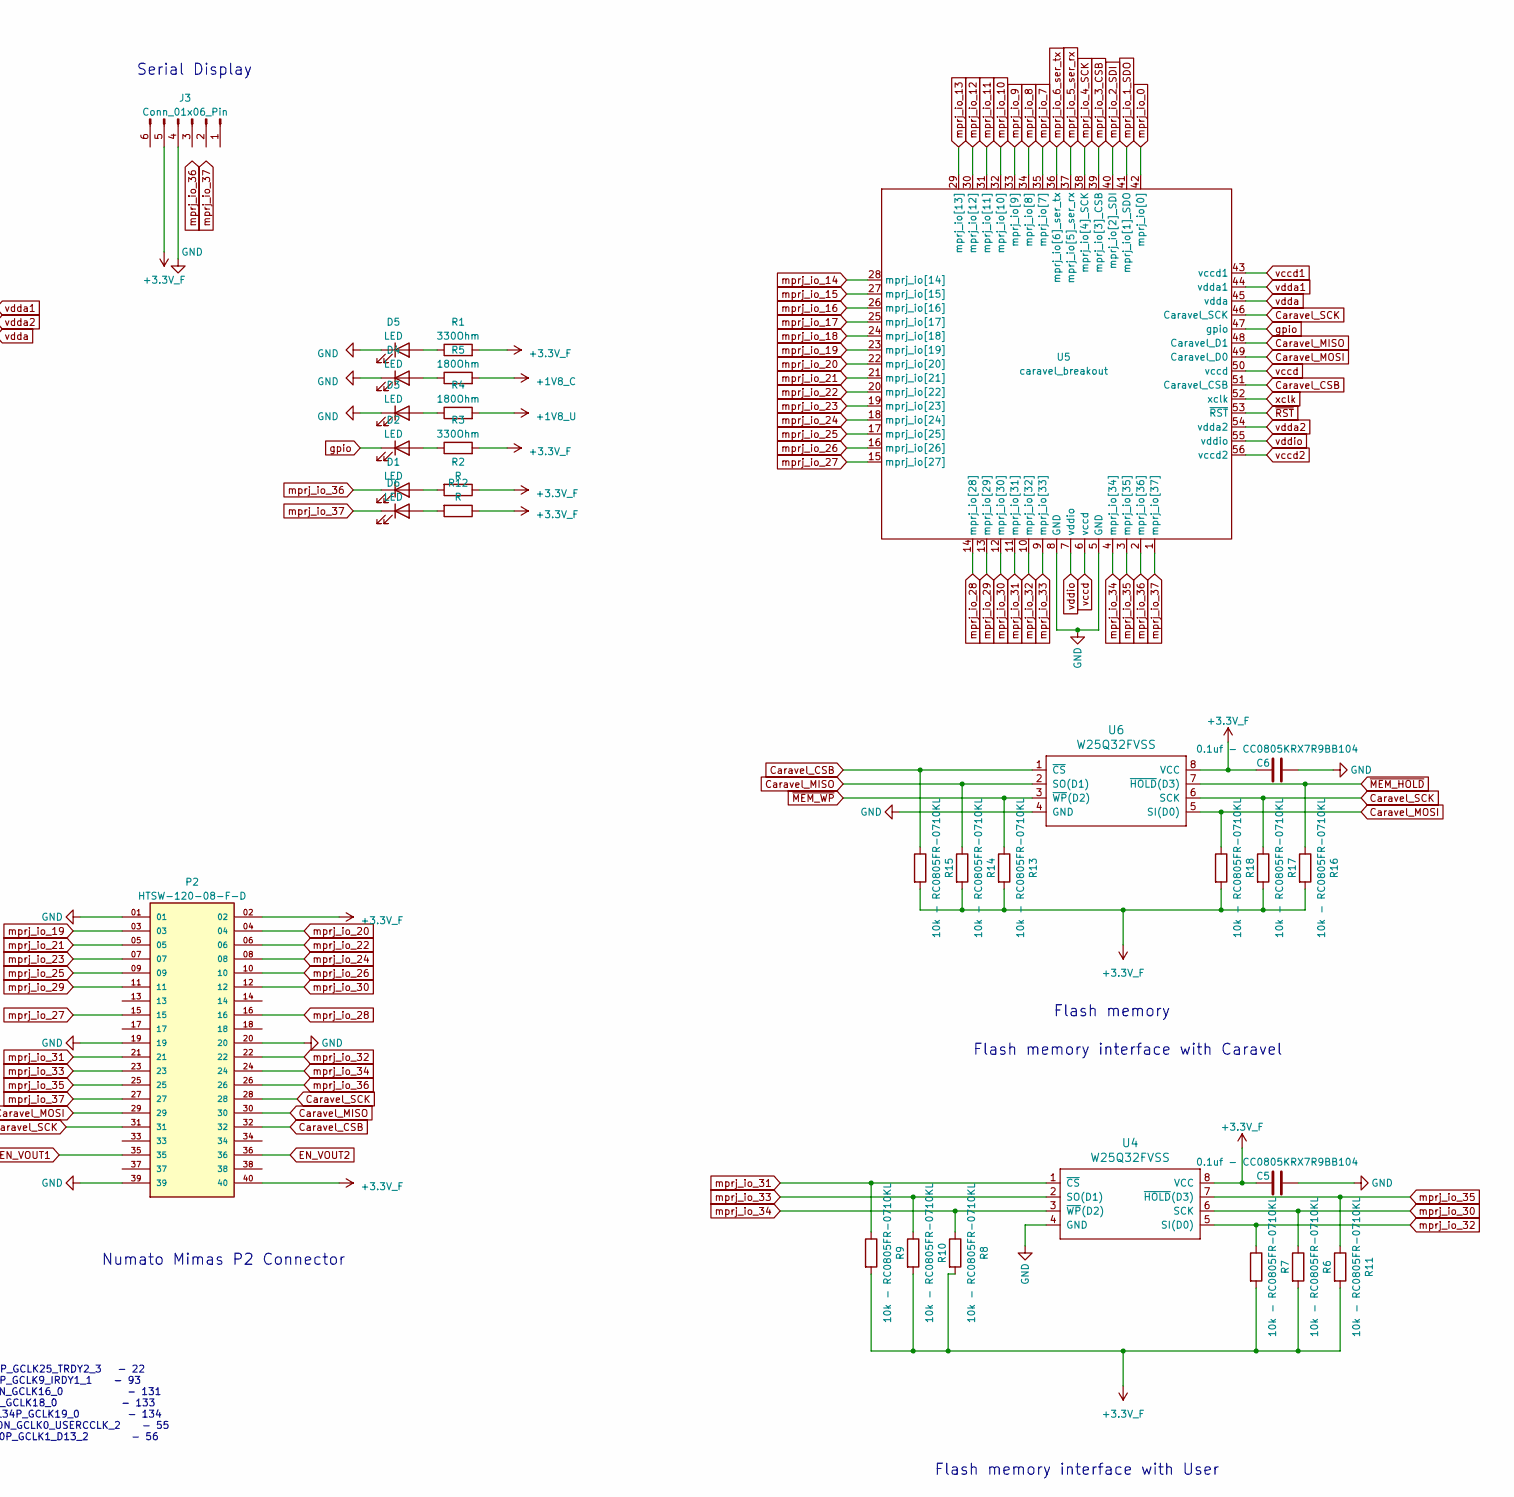
[picture p28: schematic Riscduino_Adpater_Rev1.0.kicad_sch, part in row 1, column 2]

Parts:
C1, C3: 22uF; CP_Radial_D6.3mm_P2.50mm
C2, C4, C5, C6: 0.1uf - CC0805KRX7R9BB104; C_1206_3216Metric
D1, D2, D3, D4, D5, D6: LED; LED_1206_3216Metric
J1, J4: Conn_02x04_Odd_Even; PinHeader_2x04_P2.54mm_Vertical
J2: Conn_01x06_Female; PinHeader_1x06_P2.54mm_Vertical
J3: Conn_01x06_Pin; PinHeader_1x06_P2.54mm_Vertical
J5: Conn_01x11_Female; PinHeader_1x11_P2.54mm_Vertical
P1, P2: HTSW-120-08-F-D; SAMTEC_HTSW-120-08-F-D; PARTREV R
R1, R3: 330Ohm; R_1206_3216Metric
R2, R12: R; R_1206_3216Metric
R4, R5: 180Ohm; R_1206_3216Metric
R6, R7, R8, R9, R10, R11, R13, R14, R15, R16, R17, R18: 10k - RC0805FR-0710KL; R_1206_3216Metric
RV1: 10KP; TRIM_T73YU103KT20
RV2: 10KPot; TRIM_T73YU103KT20
TP1, TP2, TP3, TP4: TestPoint; TestPoint_Bridge_Pitch2.54mm_Drill1.0mm
U1, U2: AMS1117; SOT-223-3_TabPin2
U3: NUCLEO144-F746ZG; ST_Morpho_Connectors_144
U4, U6: W25Q32FVSS; SOIC127P790X216-8N
U5: caravel_breakout; caravel_breakout_flexy_rev3D

Connections:
+1V8_C: C3.1, J4.5, J4.7, J5.3, R5.2, RV1.3, U1.2 (VO)
+1V8_U: C1.1, J4.1, J4.3, J4.8, J5.4, R4.2, RV2.3, U2.2 (VO)
+3.3V_F: C2.1, C4.1, C5.1, C6.1, J1.1, J1.3, J1.5, J1.7, J3.5, P1.01, P1.39, P2.02, P2.40, R1.2, R2.1, R3.2, R6.2, R7.2, R8.2, R9.2, R10.2, R11.2, R12.1, R13.2, R14.2, R15.2, R16.2, R17.2, R18.2, U1.3 (VI), U2.3 (VI), U4.8 (VCC), U6.8 (VCC)
Caravel_CSB: P2.32, R15.1, U3.9 (PF6), U5.51 (Caravel_CSB), U6.1 (~CS)
Caravel_MISO: P2.30, R14.1, U3.54 (PF8), U5.48 (Caravel_D1), U6.2 (SO(D1))
Caravel_MOSI: P2.29, R18.1, U3.56 (PF9), U5.49 (Caravel_D0), U6.5 (SI(D0))
Caravel_SCK: P2.28, P2.31, R17.1, U3.11 (PF7), U5.46 (Caravel_SCK), U6.6 (SCK)
EN_VOUT1: P2.35, U3.52 (PF2)
EN_VOUT2: P2.36, U3.47 (PE3)
GND: C1.2, C2.2, C3.2, C4.2, C5.2, C6.2, D3.1 (K), D4.1 (K), D5.1 (K), J3.4, P1.02, P1.40, P2.01, P2.19, P2.20, P2.39, RV1.1, RV2.1, TP1.1, TP2.1, TP3.1, TP4.1, U3.8 (GND), U3.19 (GND), U3.20 (GND), U3.22 (GND), U3.49 (GND), U3.60 (GND), U3.71 (GND), U3.72 (GND), U3.81 (GND), U3.92 (GND), U3.104 (AGND), U3.111 (GND), U3.126 (GND), U3.135 (GND), U3.143 (GND), U3.144 (GND), U4.4 (GND), U5.5 (GND), U5.8 (GND), U6.4 (GND)
I2C4_SCL: P1.30, P1.38, U3.115 (PD12)
I2C4_SDA: P1.31, U3.113 (PD13)
NU_5V: U3.18 (+5V)
unnamed: D1.2 (A), R2.2
unnamed: D2.2 (A), R3.1
unnamed: D3.2 (A), R4.1
unnamed: D4.2 (A), R5.1
unnamed: D5.2 (A), R1.1
unnamed: D6.2 (A), R12.2
unnamed: RV1.2, U1.1 (ADJ)
unnamed: RV2.2, U2.1 (ADJ)
TIM3_CH2: P1.35, U3.101 (PB5)
gpio: D2.1 (K), J5.10, P1.32, U5.47 (gpio)
mprj_io_0: P1.05, U3.65 (PG12), U5.42 (mprj_io[0])
mprj_io_1_SDO: P1.06, U3.127 (PE13), U5.41 (mprj_io[1]_SDO)
mprj_io_2_SDI: P1.07, U3.123 (PE14), U5.40 (mprj_io[2]_SDI)
mprj_io_3_CSB: P1.08, U3.128 (PE11), U5.39 (mprj_io[3]_CSB)
mprj_io_4_SCK: P1.09, P1.13, U3.121 (PE12), U5.38 (mprj_io[4]_SCK)
mprj_io_5_ser_rx: P1.10, U3.61 (PE1), U5.37 (mprj_io[5]_ser_rx)
mprj_io_6_ser_tx: P1.11, U3.136 (PE0), U5.36 (mprj_io[6]_ser_tx)
mprj_io_7: P1.12, U3.66 (PG10), U5.35 (mprj_io[7])
mprj_io_8: P1.15, U3.64 (PG15), U5.34 (mprj_io[8])
mprj_io_9: P1.16, U3.63 (PG9), U5.33 (mprj_io[9])
mprj_io_10: P1.17, U3.59 (PG0), U5.32 (mprj_io[10])
mprj_io_11: P1.18, U3.58 (PG1), U5.31 (mprj_io[11])
mprj_io_12: P1.19, U3.45 (PD7), U5.30 (mprj_io[12])
mprj_io_13: P1.20, U3.44 (PG3), U5.29 (mprj_io[13])
mprj_io_14: P1.21, U3.43 (PD6), U5.28 (mprj_io[14])
mprj_io_15: P1.22, U3.42 (PG2), U5.27 (mprj_io[15])
mprj_io_16: P1.25, U3.41 (PD5), U5.26 (mprj_io[16])
mprj_io_17: P1.26, U3.40 (PD3), U5.25 (mprj_io[17])
mprj_io_18: P1.27, U3.39 (PD4), U5.24 (mprj_io[18])
mprj_io_19: P2.03, U3.38 (PC0), U5.23 (mprj_io[19])
mprj_io_20: P2.04, U3.37 (PC3), U5.22 (mprj_io[20])
mprj_io_21: P2.05, U3.35 (PC2), U5.21 (mprj_io[21])
mprj_io_22: P2.06, U3.32 (PA4), U5.20 (mprj_io[22])
mprj_io_23: P2.07, U3.28 (ETH_REF_CLK/PA0), U5.19 (mprj_io[23])
mprj_io_24: P2.08, U3.17 (PA15), U5.18 (mprj_io[24])
mprj_io_25: P2.09, U3.1 (PC10), U5.17 (mprj_io[25])
mprj_io_26: P2.10, U3.2 (PC11), U5.16 (mprj_io[26])
mprj_io_27: P2.15, U3.4 (PD2), U5.15 (mprj_io[27])
mprj_io_28: P2.16, U3.73 (PC9), U5.14 (mprj_io[28])
mprj_io_29: P2.11, U3.74 (PC8), U5.13 (mprj_io[29])
mprj_io_30: J2.1, P2.12, R6.1, U3.75 (PB8), U4.6 (SCK), U5.12 (mprj_io[30])
mprj_io_31: J2.2, P2.21, R9.1, U3.76 (PC6), U4.1 (~CS), U5.11 (mprj_io[31])
mprj_io_32: J2.3, P2.22, R7.1, U3.77 (PB9), U4.5 (SI(D0)), U5.10 (mprj_io[32])
mprj_io_33: J2.4, P2.23, R10.1, U3.88 (PB12), U4.2 (SO(D1)), U5.9 (mprj_io[33])
mprj_io_34: J2.5, P2.24, R8.1, U3.89 (PB6), U4.3 (~WP(D2)), U5.4 (mprj_io[34])
mprj_io_35: J2.6, P2.25, R11.1, U3.94 (PB2), U4.7 (~HOLD(D3)), U5.3 (mprj_io[35])
mprj_io_36: D1.1 (K), P2.26, U3.96 (PB1), U5.2 (mprj_io[36])
mprj_io_37: D6.1 (K), P2.27, U3.98 (PB15), U5.1 (mprj_io[37])
vccd: J4.6, U5.6 (vccd), U5.50 (vccd)
vccd1: J4.2, J5.5, U5.43 (vccd1)
vccd2: J4.4, J5.2, U5.56 (vccd2)
vdda: J1.6, U5.45 (vdda)
vdda1: J1.2, J5.9, U5.44 (vdda1)
vdda2: J1.4, J5.6, U5.54 (vdda2)
vddio: U5.7 (vddio), U5.55 (vddio)
xclk: J5.11, P1.36, U3.99 (PB4), U5.52 (xclk)
~MEM_HOLD: R16.1, U6.7 (~HOLD(D3))
~MEM_WP: R13.1, U6.3 (~WP(D2))
~MR: P1.29, U3.3 (PC12)
~RST: J5.1, P1.28, U3.23 (BT/PC13), U5.53 (~RST)

Notes on the sheet:
Numato Mimas P1 Connector
Flash memory
Serial Display
Numato Mimas P2 Connector
User Flash
Nucleo ST Morpho Connectors
FPGA Clock Tree Mapping CLK NET FPGA Clock Pin mprj_io_4_SCK P1-13 - IO_L42P_GCLK25_TRDY2_3 - 22 Caravel_SCK P2-28 - IO_L41P_GCLK9_IRDY1_1 - 93 I2C4_SCL P1-38 - IO_L35N_GCLK16_0 - 131 xclk P1-36 - IO_L34N_GCLK18_0 - 133 TM_CH2 P-35 - IO_L34P_GCLK19_0 - 134 mprj_io_29 - sdram_clk P-11 - IO_L30N_GCLK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
Flash memory interface with User
Flash memory interface with Caravel

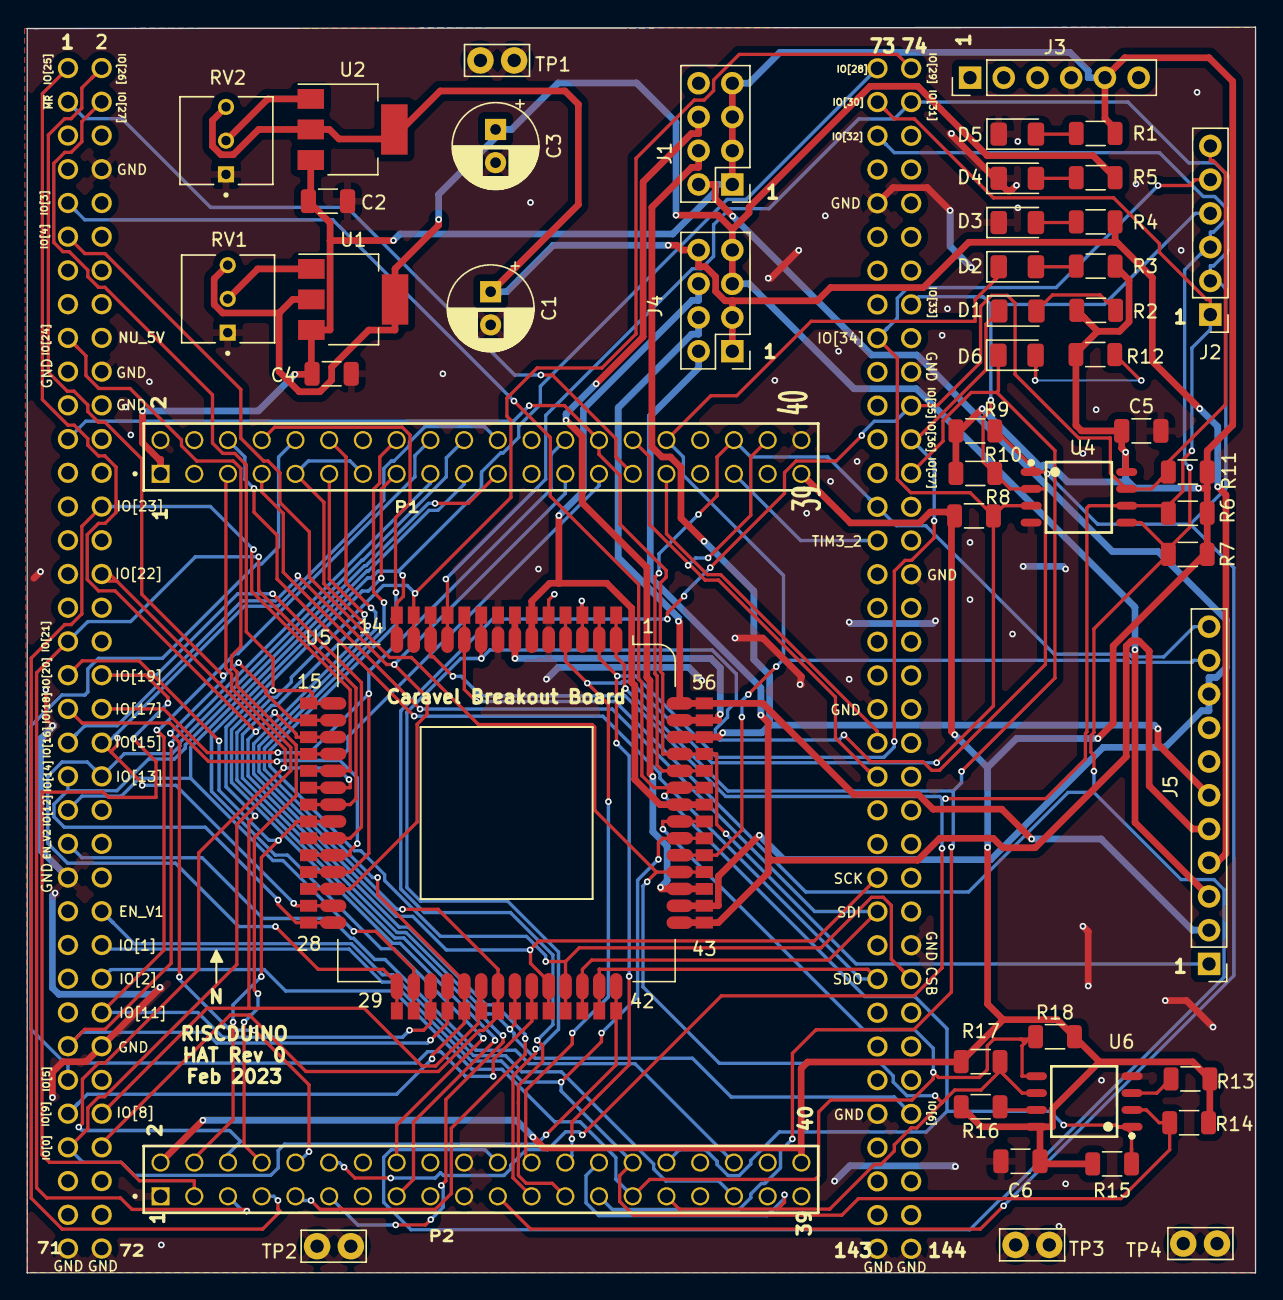
[picture p29: board Riscduino_Adpater_Rev1.0.kicad_pcb from above]

Board: 2 copper layers, 92.5 x 93.8 mm, 49 parts (0 on the bottom side), 72 nets.
