dineshannayya/riscduino_board/(commit log)

2023-07-25 KiCad PCB
    [Riscduino_Debug.kicad_pcb, Riscduino_Debug.kicad_sch, Riscduino_Debug_Rev1.0.xlsx, Riscduino_Uno.csv, Riscduino_Uno.kicad_pcb, Riscduino_Uno.kicad_sch, Riscduino_Uno.xlsx]
2023-07-25 ver 1.1 boards
    [Riscduino_Debug.kicad_pcb, Riscduino_Debug.kicad_sch, Riscduino_Uno.kicad_pcb, Riscduino_Uno.kicad_sch]
2023-07-25 gerber files
2023-07-27 Riscduino Uno 1.2
    [Riscduino_Uno.kicad_pcb, Riscduino_Uno.kicad_sch]
2023-07-27 Riscduino Adpater Used in MPW-2 Debug
    [Riscduino_Adpater_Rev1.0.kicad_pcb, Riscduino_Adpater_Rev1.0.kicad_sch, numato_pinmaping.xlsx]
2023-07-30 Kicad Foot Prints
2023-07-30 atmega adapter
    [Riscduino_ATMEGA_Adpater_Rev1.0.kicad_pcb, Riscduino_ATMEGA_Adpater_Rev1.0.kicad_sch]
2023-08-01 BOM Update
    [Riscduino_Componets_Tracking.xlsx, Riscduino_Debug_Rev1.0.xlsx, Riscduino_Debug_Rev1.0_BOM.xlsx]
2023-08-01 BOM Addition
    [Riscduino_Uno_Rev1.1.BOM.xlsx]
2023-08-12 Rev Uno 1.2 update
    [Riscduino_Uno.kicad_pcb, Riscduino_Uno.kicad_sch]
2023-08-13 Riscduino Uno Rev1.2
    [Riscduino_Uno.kicad_pcb, Riscduino_Uno.kicad_sch, Riscduino_Uno_Rev1.2.csv]
2023-08-14 PCB Update
    [Riscduino_Uno.kicad_pcb]
2023-08-23 Uno 1.2
    [Riscduino_Componets_Tracking.xlsx]
2023-08-29 Uno 1.1.3
    [Riscduino_Componets_Tracking.xlsx, Riscduino_Uno.kicad_pcb, Riscduino_Uno.kicad_sch]
2023-08-30 Riscduino Test Ver 1.0
    [Riscduino_Tester.kicad_pcb, Riscduino_Tester.kicad_sch]
2023-09-07 Power Supervisory Circuit
    [Riscduino_Uno.kicad_pcb, Riscduino_Uno.kicad_sch]
2023-09-08 1.3 Uno Schematic update
    [Riscduino_Uno.kicad_pcb, Riscduino_Uno.kicad_sch]
2023-09-16 Riscduino Uno 1.3
    [Riscduino_Componets_Tracking.xlsx, Riscduino_Uno.kicad_pcb, Riscduino_Uno.kicad_sch]
2023-12-24 Debug 1.3 Update
    [BoardStatus.xlsx, Riscduino_Debug_Rev1.3.kicad_pcb, Riscduino_Debug_Rev1.3.kicad_sch]
2023-12-25 Debug 1.3 BOM clean up
    [Riscduino_Debug_Rev1.3.kicad_pcb, Riscduino_Debug_Rev1.3.kicad_sch, Riscduino_Debug_Rev1.3.xlsx]
2023-12-25 Debug PCB View
2023-12-26 component tracking xls update
    [Riscduino_Componets_Tracking.xlsx, Riscduino_Debug_Rev1.3.xlsx]
2024-02-03 Debug Board 1.4
    [BoardStatus.xlsx, Riscduino_Debug_Rev1.4.kicad_pcb, Riscduino_Debug_Rev1.4.kicad_sch, Riscduino_Debug_Rev1.4.xlsx, freerouting.dsn]
2024-03-04 Riscduino FPGA Setup
    [Riscduino_Fpga_Rev1.0.csv, Riscduino_Fpga_Rev1.0.kicad_pcb, Riscduino_Fpga_Rev1.0.kicad_sch, Riscduino_Fpga_Rev1.0_BOM.xlsx]
2024-03-15 Riscduino FPGA 1.1
    [Riscduino_Fpga_Rev1.1.kicad_pcb, Riscduino_Fpga_Rev1.1.kicad_sch]
